floronics/ProBoter/docs/offene-fragen.md

# Offene Fragen

Sammelstelle für Fragen an SCHUTZWERK, die Werkstatt und andere Ansprechpartner.
Beantwortete Fragen mit Antwort und Datum unten unter **Erledigt** ablegen.

Status: `offen` · `gefragt` (wartet auf Antwort) · `erledigt`

## SCHUTZWERK

| # | Frage | Kontext | Status | Datum |
|---|---|---|---|---|
| | | | | |

## Werkstatt (Hochschule)

| # | Frage | Kontext | Status | Datum |
|---|---|---|---|---|
| | | | | |

## Sonstige

| # | Frage | Ansprechpartner | Status | Datum |
|---|---|---|---|---|
| | | | | |

## Erledigt

| # | Frage | Antwort | Datum |
|---|---|---|---|
| S1 | Aus welchem Material ist die Schubladenplatte gefertigt? | Siebdruckplatte, 12 mm Stärke (Material grundsätzlich austauschbar). Rückwand mit den Boards: 5 mm MDF, kann auch aus Kunststoff gefertigt werden. | 2026-10-28 |
| S2 | Wie wurde der PCB Holder gefertigt? | Zwei Rechteckführungen mit gedruckten Kunststoffhaltern, die vorne einen 90°-Innenwinkel haben. Material/Fertigungsverfahren der Halter sind beliebig wählbar. | 2026-10-28 |
| S3 | Endenbearbeitung/Nut der Trapezspindel TR10x2 | Entfällt – Spindel-Variante wurde laut SCHUTZWERK nicht weiterverfolgt (siehe S4), die betroffene BOM-Position entfällt komplett. | 2026-10-28 |
| S4 | Sind die Spindel-Angaben für X/Y in der BOM veraltet? | Ja, können raus. Das war der erste Prototyp-Aufbau mit Trapezspindeln, wurde dann gegen Zahnriemen getauscht. | 2026-10-28 |
| S5 | Welche Prüfspitzen und Aufnahmehülsen setzt ihr ein? | SCHUTZWERK hat keine Bestellbezeichnung mehr (nur vermuteter AliExpress-Artikel). Eigene Auswahl getroffen, P75-kompatibel, RS Components: Prüfspitzen 261-5171 (konkav, Power/GND), 261-5193 (Nadel, Oszi/Multimeter), 261-5187 (Kegel, Vergleich), Crimp-Buchse 261-5250 für alle. Achtung: Pins sind ca. 17 mm lang statt 31,8 mm im CAD, Probe-Holder muss angepasst werden. | 2026-10-28 |
| S6 | Gibt es Fertigungsdaten für das Probe-PCB, und welches Kabel verbindet MMCX und SMA? | Keine Gerber-/Schaltplandaten vorhanden – es ist keine funktionale Leiterplatte, sondern nur eine kleine Platine mit Aufnahmehülse (https://de.aliexpress.com/item/1005002266917025.html), die vorn ins Plastikteil eingeklebt ist und hinten per MMCX weitergeht. Das Kabel ist vermutlich RG316-Koaxkabel. | 2026-10-28 |
| S7 | Wo habt ihr die Stahlplatten lasern lassen? | Siebdruckplatte: expresszuschnitt.de. Stahlteile: laserteile4you.de. | 2026-10-28 |
| S8 | Welches Material wurde für die gedruckten Teile verwendet? | Teile mit mechanischer Belastung: PETG. ABS wurde nicht verwendet. Die Kalibrierplatte (und evtl. einzelne Halter) sind in PLA gedruckt. | 2026-10-28 |
| W1 | Können die Motorplatten in der Werkstatt gefertigt werden? | Nicht mehr nötig: Motorplatten X/X2 und Seitenplatten werden extern bei laserteile4you.de gelasert (Stahl oder Alu, 5 mm). Die Werkstatt schneidet nur Schubladenplatte und Rückwand zu. | 2026-10-28 |
