floronics/ProBoter/bom/Bestellliste.md

# Bestellliste und Einstieg

**Stand 16.10.2026 · ein PROBoter / vier Prüfeinheiten · Bildungseinrichtung Deutschland.**

3D-Druck und Blechbearbeitung intern; CNC/PCB extern. Host-PC, Messgeräte und Werkzeuge vorhan den. Arbeitszeit, Maschinenkosten, Softwaremigration und Elektronikentwicklung sind ausgeschlossen. Die Grundkonfiguration enthält **ein bewegliches Mikroskop und eine Übersichtskamera**, drei weitere Mikroskope sind optional.

## Kostenstand

| Ergebnis | netto | brutto 19% |
| --- | --- | --- |
| 1. Summe belegter Webpreise bei Planmengen (einschließlich ungeprüfter Kandidaten) | 3.153,78 € | 3.753,10 € |
| Zusätzliche eigene Budgetschätzungen inklusive Frachtreserve | 826,09 € | 983,03 € |
| 2. Vorläufiger Gesamtbedarf des bezifferten Umfangs | 3.979,87 € | 4.736,13 € |
| 3. 20 noch unbezifferte Bestellpositionen | offen | offen |

**Das vorläufige Total ist kein vollständiger Baupreis.** Die unbezifferten Platinen, Prüfkontakte, Sensoren und Kalibrierteile kommen hinzu. Ein vorhan dener Shoppreis beweist keine Austauschbarkeit. [Kostenmethodik](Kosten.md) trennt Preise, Mengenannahmen und offene Bedarfe.

## Dokumente

- [Alle Teile und Mengen](Teileliste.md) / [CSV](teileliste.csv)
- [Fertigung nach Verfahren und Angebotsanforderungen](Fertigung.md)
- [Nichtidentifizierte Teile und übrige Lücken](Ungeklaert.md)
- [Lieferanten, Rechnungskauf und Versand](Lieferanten.md)
- [Bestell-CSV mit Packungsrechnung](bestellliste.csv), [Kosten-JSON](kosten.json), [Angebotsquellen](data/offers.json)
- [CAD-/Fusion-Abgleich](CAD-Pruefung.md), [Reproduktion](Reproduktion.md)

## Bereits eindeutig beschaffbar

- **CAD-060:1×Mean Well RSP-200-24** – Originalmodell; Netzanschluss/Verteilung separat planen.
- **CAD-079:16×SHF10,DOLD11260** – Hauptmaße bestätigt; aktuell angekündigter Wareneingang 27.11.2026.

TMC2130, Rollen, Lager und Kamerakandidaten besitzen konkrete Bezugsquellen, benötigen aber die jeweils genannte Passungsprüfung. Filament ist als Materialvorschlag preislich bestimmt; Druckteile sind noch keine freigegebenen Fertigungsaufträge.

## Shopartikel mit beobachtetem Preis

| ID / Bedarf | Bedarf → Bestellung | Anbieter / Artikel | Preis pro Packung | Summe netto / brutto | Passung / Vorbehalt |
| --- | --- | --- | --- | --- | --- |
| **BUY-001** Netzteil 24 V<br>CAD-060 | 1 Stück → 1 × 1 | [REICHELT](https://www.reichelt.de/de/de/shop/produkt/schaltnetzteil_geschlossen_200_w_24_v_8_4_a-147909) / MW RSP-200-24<br>Mean Well: RSP-200-24<br>ab Lager; 1–2 Werktage | 42,50 € brutto | 35,71 € / 42,50 € | Originalmodell; CAD 215×115×30 mm. Gesamte 24-V-Last noch nachweisen.  |
| **BUY-002** 16 TMC2130 aus 4 Viererpacks<br>SYS-001 | 16 Stück → 4 × 4 | [RBS](https://www.roboter-bausatz.de/p/4x-tmc2130-spi-schrittmotortreiber) / RBS13024<br>BIGTREETECH: TMC2130 SPI Modul (Revision prüfen)<br>lieferbar; 1–3 Werktage | 39,95 € brutto | 134,29 € / 159,80 € | Treiberfamilie laut Firmware. SPI-Pinbelegung, Modulrevision, Jumper und Kühlung am SKR1.3 prüfen.  |
| **BUY-003** 16 Flanschhalter SHF10<br>CAD-079 | 16 Stück → 16 × 1 | [DOLD](https://www.dold-mechatronik.de/Wellenhalter-Flansch-SHF10) / 11260<br>DOLD: SHF10<br>nicht auf Lager; 320 Stück angekündigt für 27.11.2026 | 3,90 € brutto | 52,44 € / 62,40 € | CAD: 43×24×10 mm, Bohrung 10 mm, Befestigung 5,5 mm; mechanische Hauptmaße stimmen.  |
| **BUY-004** 12 X/Y-Antriebsriemenscheiben<br>CAD-077 | 12 Stück → 12 × 1 | [RBS](https://www.roboter-bausatz.de/p/gt2-riemenscheibe-z16-5mm-bohrung-6mm-riemen) / RBS10278<br>Maker Mind: 16-2GT-6 BF<br>lieferbar; 1–3 Werktage | 0,95 € brutto | 9,58 € / 11,40 € | Preisstaffel 5–19 Stück, geplant 12. Bohrung 5 mm CAD bestätigt; axiale Bund-/Klemmlänge mit 14,1-mm-CAD prüfen.  |
| **BUY-005** 20 Umlenkrollen 6 mm, 8,5 mm breit<br>CAD-078 | 20 Stück → 20 × 1 | [TINYTRONICS](https://www.tinytronics.nl/en/mechanics-and-actuators/parts/pulleys/gt2-16-pulley-16-teeth-3mm-axis-with-ball-bearing) / 002225<br>nicht angegeben: 002225<br>500+ auf Lager (NL) | 1,50 € brutto | 25,21 € / 30,00 € | Bohrung 3, Ø13, Höhe 8,5 mm, 6-mm-Riemen = CAD exakt.  |
| **BUY-006** 8 Z-Zahnscheiben 9 mm, Ersatz mit Halteranpassung<br>CAD-076 | 8 Stück → 8 × 1 | [RBS](https://www.roboter-bausatz.de/p/gt2-riemenscheibe-16-zaehne-5mm-bohrung-fuer-10mm-zahnriemen) / RBS12867<br>nicht angegeben: RBS12867<br>sofort verfügbar; 1–3 Werktage | 1,29 € brutto | 8,67 € / 10,32 € | Exaktes Teil 16 Zähne / 9 mm / Ø18×11 in DE/EU nicht gefunden. Kandidat Ø13×19,5, Zahnbreite 11,5: Halter anpassen; als Umlenkung nur mit Lagern. DOLD 64396 ist ein glattes Führungsrad und passt nicht.  |
| **BUY-007** X/Y-Riemen 6 mm,2 Rollen à10 m<br>CAD-087;CAD-104 | 20 m → 2 × 10 | [DOLD](https://www.dold-mechatronik.de/Zahnriemen-GT2-Breite-6mm-Meterware-Laenge-10-Meter) / 46194-VKV / Variante 10 m<br>DOLD: GT2 6 mm Neopren gewebeverstärkt<br>lieferbar; 3–4 Werktage | 25,00 € brutto | 42,02 € / 50,00 € | Budget 20 m für X/Y. Zuschnitt erst nach Prüfung der wirksamen Längen und offenen/geschlossenen Ausführung. Zuschnitt aus Fusion-Messung: 8×1,51 m + 4×1,10 m = 16,5 m inklusive Klemmzugabe; zwei 10-m-Rollen decken den Bedarf. |
| **BUY-008** Kurze Energieketten, 192 Glieder<br>CAD-049 | 192 Glied → 192 × 1 | [IGUS](https://www.igus.de/product/series-E2i-10?artNr=E2i.10.10.028.0) / E2i.10.10.028.0<br>igus: E2i.10.10.028.0<br>in 24 Stunden versandfertig | 0,47 € netto | 90,24 € / 107,39 € | Teilung 20 mm, Außenbreite 17,4, Höhe 15, Einbauhöhe 71 bei R28 = CAD. 0,24 m = 12 Glieder. Preis aus Seitendaten, vermutlich netto. 16 Abschnitte à 12 Glieder (0,24 m). |
| **BUY-009** 4 optische Endstops inkl 1 m Kabel<br>CAD-065 | 4 Stück → 4 × 1 | [RBS](https://www.roboter-bausatz.de/p/optischer-endschalter-endstop-mit-1m-kabel) / RBS12901<br>Maker Mind: RBS12901<br>sofort verfügbar; 1–3 Werktage | 2,85 € brutto | 9,58 € / 11,40 € | 35×11 mm, 2 Bohrungen im Abstand 28 mm = CAD. VCC/GND/SIG, 2,7–5 V, HIGH bei Unterbrechung; 3-polig 2,54 mm, 1 m Kabel. Pinfolge am SKR-Stecker prüfen.  |
| **MAT-001** PETG für CAD-Druckteile plus Kalibrierkörper<br>CAD-001;CAD-002;CAD-004;CAD-005;CAD-006;CAD-015;CAD-016;CAD-017;CAD-018;CAD-019;CAD-021;CAD-022;CAD-024;CAD-025;CAD-026;CAD-067;CAD-068;CAD-071;CAD-072;CAD-074;CAD-083;CAD-088;CAD-089;CAD-090;CAD-091;CAD-092;CAD-101;CAD-102;CAD-105;CAD-106;CAD-107;CAD-109;CAD-110;CAD-111;CAD-112;CAD-114;CAD-116;CAD-117;CAD-118;CAD-119;CAD-120;SYS-061;SYS-062;SYS-063;SYS-064;SYS-065;SYS-066;SYS-067;SYS-068;SYS-069;SYS-070;SYS-071;SYS-072 | 5,052 kg → 6 × 1 | [RBS](https://www.roboter-bausatz.de/p/yourdroid-petg-filament-schwarz-1.75mm-1kg) / RBS13444<br>your Droid: RBS13444<br>lieferbar; 1–3 Werktage | 11,95 € brutto | 60,25 € / 71,70 € | Werkstoffvorschlag; kein Originalwerkstoffnachweis. Bedarf aus CAD-Vollvolumen mit Zuschlag; Pass-/Belastungsprobe nötig. 2658.987 cm³ CAD-Vollvolumen × angenommene 1,27 g/cm³ ×1,20 +1 kg Kalibrier-/Probedruckbudget. Auf ganze 1 kg-Rollen gerundet. Kein Slicerresultat. |
| **BUY-011** USB-Mikroskop Toolcraft 2 MP (AUSWAHL, ANPASSUNG Halter)<br>CAD-085 | 1 Stück → 1 × 1 | [VOELKNER](https://www.voelkner.de/products/1177903/TOOLCRAFT-USB-Mikroskop-2-Megapixel-Digitale-Vergroesserung-max.-200-x.html) / D929041<br>Toolcraft: Conrad 1713197<br>auf Lager | 57,99 € brutto | 48,73 € / 57,99 € | Körper Ø33×110 mm (CAD Ø36×108), Fokus 0–150 mm. UVC/Linux nicht angegeben: vor Einbau mit v 4l 2-ctl testen. Druckhalter mit 1,5-mm-Hülse anpassen.  |
| **BUY-012** Aktiver 7Port-USB-Hub<br>SYS-010 | 1 Stück → 1 × 1 | [REICHELT](https://www.reichelt.de/de/de/shop/produkt/usb_2_0_7-port_hub_mit_netzteil_schwarz-131488) / D-LINK DUB H7<br>D-Link: DUB-H7/E<br>ab Lager; 1–2 Werktage | 25,90 € brutto | 21,76 € / 25,90 € | Steuergeräte an Hub, Kameras an zwei separate Hostports. Netzteil 5V2,5 A und Anschlusskabel enthalten; Strombudget prüfen.  |
| **BUY-013** LED-Streifen 5-m-Rolle für 1,9 m<br>SYS-007 | 1,9 m → 1 × 5 | [REICHELT](https://www.reichelt.de/de/de/shop/produkt/led-streifen_5_meter_4500_k_120_led_m_24_v_8_mm-365051) / LUXULA LX700101<br>LUXULA: LX700101<br>ab Lager; 1–2 Werktage | 6,95 € brutto | 5,84 € / 6,95 € | Vorschlag:2 m Beleuchtung aus 5 m-Rolle; 8 mm breit,5cm teilbar. Leistung, homogene Ausleuchtung und PWM/Kamera-Flimmern prüfen.  |
| **BUY-014** 12 NEMA17 Originalmotoren<br>CAD-064 | 12 Stück → 12 × 1 | [NANOTEC](https://www.nanotec.com/eu/de/produkte/363-st4118m1804-a) / ST4118M1804-A<br>Nanotec: ST4118M1804-A<br>Verfügbarkeit laut Shop anfragen | 31,20 € netto | 374,40 € / 445,54 € | Originalmodell, aktuelle Serie. 1,8 A, 1,1 Ω, 0,28 Nm, 42,3 mm Flansch, 38 mm, Welle Ø5×24, Litzen 300 mm mit JST XHP-4. Preisbasis im Shop nicht angegeben, als netto angesetzt.  |
| **BUY-016** 4 Steuerplatinen SKR 1.4 Turbo (ERSATZ)<br>CAD-023 | 4 Stück → 4 × 1 | [RBS](https://www.roboter-bausatz.de/p/btt-skr-1.4-turbo-32-bit-mainboard) / RBS13645<br>BIGTREETECH: SKR V1.4 Turbo<br>sofort verfügbar; 1–3 Werktage | 49,95 € brutto | 167,90 € / 199,80 € | Nur Kandidat: SKR V1.3 neu in DE/EU nicht gefunden. 110×85 mm, Löcher 102×76 (V1.3: 101,85×76,10), LPC1769. Marlin-Pins für Endstops, Treiber-CS und SPI-MOSI ändern; nicht freigegeben. Firmware-Migration auf SKR 1.4 Turbo nötig (Arbeitszeit nicht kalkuliert). |
| **BUY-018** 8 CPC-Führungswagen MR12ML<br>CAD-027 | 8 Stück → 8 × 1 | [MOTEDIS](https://www.motedis.com/de/Fuehrungswagen-Miniatur-MR12ML-SS-V0-N-Edelstahl) / 6344<br>CPC: MR12MLSSV0N<br>laut Shop derzeit nicht genug Bestand | 20,51 € netto | 164,08 € / 195,26 € | CPC-Katalog SS-Ausführung: L 47,6, Körperhöhe 10, Breite 27, Lochbild 20×20 M3 = CAD.  |
| **BUY-019** 2 CPC-Schienen MR12M 600 mm<br>CAD-095 | 2 Stück → 2 × 1 | [MOTEDIS](https://www.motedis.com/de/Edelstahl-Profilschienenfuehrung-Miniatur-MR12M-N-L-600mm) / MR12M-N-600<br>CPC: MR12M-N-600<br>laut Shop nicht auf Lager | 50,17 € netto | 100,34 € / 119,40 € | 12×7,5 mm, Teilung 25, Bohrung Ø3,5/Ø6, 24 Bohrungen, Endabstand 12,5 = CAD. Endabstand bei Bestellung angeben.  |
| **BUY-020** 4 HIWIN-Schienen 150 mm<br>CAD-053 | 4 Stück → 4 × 1 | [DAMEN](https://www.damencnc.com/en/hiwin-profile-rails-narrow-type-mgnr-12-hm/a1945) / 3449<br>HIWIN: MGNR12R150HM<br>auf Lager (NL) | 46,75 € netto | 187,00 € / 222,53 € | 12×8, Teilung 25, 6 Bohrungen, Endabstand 12,5 = CAD. Preis berechnet: 245 EUR/m netto × 0,15 m + 10 EUR Zuschnitt.  |
| **BUY-021** 4 HIWIN-Wagen MGN12C<br>CAD-054 | 4 Stück → 4 × 1 | [DAMEN](https://www.damencnc.com/en/hiwin-carriage-mgn-narrow-type-mgn-12-c-z0-hm-short/a1947) / 3455<br>HIWIN: MGN12CZ0HM<br>auf Lager (NL) | 31,00 € netto | 124,00 € / 147,56 € | Breite 27, Körperhöhe 10, Lochbild 20×15 M3 = CAD; Katalog-Länge 34,7 statt CAD 35,7.  |
| **BUY-022** 16 Gleitbuchsen RJ4JP-01-10<br>CAD-080 | 16 Stück → 16 × 1 | [DOLD](https://www.dold-mechatronik.de/index.php?a=216047) / RJ4JP-01-10<br>igus: RJ4JP-01-10<br>sofort verfügbar; 3–4 Werktage | 3,82 € brutto | 51,36 € / 61,12 € | d 10, D 19, B 29, Nut Ø18 = CAD. Staffelpreis ab 10 Stück.  |
| **BUY-023** Lange Energieketten, 112 Glieder<br>CAD-050 | 112 Glied → 112 × 1 | [IGUS](https://www.igus.de/product/series-E2i-10?artNr=E2I.10.20.028.0) / E2I.10.20.028.0<br>igus: E2i.10.20.028.0<br>in 24 Stunden versandfertig | 0,49 € netto | 54,88 € / 65,31 € | Teilung 20 mm, Außenbreite 27,4, Einbauhöhe 71 = CAD. 0,28 m = 14 Glieder. Preis vermutlich netto. 8 Abschnitte à 14 Glieder (0,28 m). |
| **BUY-024** 16 Anschlusssätze E2.10 schmal<br>SYS-027 | 16 Satz → 16 × 1 | [DIGIKEY](https://www.digikey.de/de/products/detail/igus/E2-100-10-34PZ/13157727) / E2-100-10-34PZ<br>igus: E2.100.10.34PZ<br>14 vorrätig, sonst 22 Wochen | 5,84 € netto | 93,44 € / 111,19 € | Beidseitig schwenkbar mit Zugentlastung; Breite 17,4 = CAD-Anschlusskörper.  |
| **BUY-025** 8 Anschlusssätze E2.10 breit<br>SYS-028 | 8 Satz → 8 × 1 | [DIGIKEY](https://www.digikey.de/de/products/detail/igus/E2-100-20-34PZ/13157712) / E2-100-20-34PZ<br>igus: E2.100.20.34PZ<br>42 vorrätig | 6,76 € netto | 54,08 € / 64,36 € | Breite 27,4 = CAD-Anschlusskörper.  |
| **BUY-017** Z-Riemen 9 mm<br>CAD-113 | 1,28 m → 2 × 1 | [RBS](https://www.roboter-bausatz.de/p/1-meter-gt2-zahnriemen-gates-ll2gt-rf-9mm) / RBS14040<br>Maker Mind (Shopangabe; Titel nennt Gates LL-2GT RF): LL-2GT RF 9 mm<br>sofort verfügbar; 1–3 Werktage | 8,69 € brutto | 14,61 € / 17,38 € | GT2, 9 mm breit = CAD. Bedarf 4×0,32 m. Zuschnitt aus Fusion-Messung 4×0,32 m. |
| **BUY-SYS-057** 10 Prüfstifte P75-E2<br>SYS-057 | 10 Stück → 10 × 1 | [DOMOTICX](https://domoticx.net/webshop/pogo-pin-test-probe-075mm-conisch-p75-e2/) / P75-E2<br>nicht angegeben: P75-E2<br>nicht geprüft | 0,18 € brutto | 1,51 € / 1,80 € | Gleicher Körper wie P75-B1, Kegelspitze.  |
| **BUY-SYS-042** Nutenstein I-Typ Nut 6, M4, Rückwand<br>SYS-042 | 6 Stück → 1 × 10 | [DOLD](https://www.dold-mechatronik.de/Nutenstein-mit-Steg-I-Typ-Nut-6-Gewindedurchmesser-M4) / 62347-VK<br>DOLD: 62347-VK<br>sofort verfügbar | 4,80 € brutto | 4,03 € / 4,80 € | Passend zu I-Typ Nut 6; Staffelpreis 0,48 EUR ab 10 Stück.  |
| **BUY-SYS-043** Zylinderschraube DIN 912 M4×10 A2, Rückwand<br>SYS-043 | 6 Stück → 1 × 10 | [SCHRAUBEN](https://schrauben-expert.de/Zylinderschraube-DIN-912-M4-x-10-mm-Edelstahl-A2) / 912 4 10 A2<br>Schrauben.Expert: 912 4 10 A2<br>Expresslager 1–4 Werktage | 3,30 € brutto | 2,77 € / 3,30 € | 3 mm Rückwand + Nutenstein; gleicher Artikel wie CAD-043, separat für die Rückwand.  |
| **BUY-SYS-044** Nutenstein I-Typ Nut 6, M5, Griff<br>SYS-044 | 2 Stück → 2 × 1 | [DOLD](https://www.dold-mechatronik.de/Nutenstein-mit-Steg-I-Typ-Nut-6-Gewindedurchmesser-M5) / 62361-VK<br>DOLD: 62361-VK<br>sofort verfügbar | 0,89 € brutto | 1,50 € / 1,78 € | Für die Griffschrauben M5.  |
| **BUY-SYS-045** Zylinderschraube DIN 912 M5×35 A2, Griff<br>SYS-045 | 2 Stück → 1 × 10 | [SCHRAUBEN](https://schrauben-expert.de/Zylinderschraube-DIN-912-M5-x-35-mm-Edelstahl-A2) / 912 5 35 A2<br>Schrauben.Expert: 912 5 35 A2<br>Express 13 Stück, Lager 8000 | 3,30 € brutto | 2,77 € / 3,30 € | Mindestabnahme 10.  |
| **BUY-SYS-046** Zylinderschraube DIN 912 M4×10 A2, Wellenhalter<br>SYS-046 | 7 Stück → 1 × 10 | [SCHRAUBEN](https://schrauben-expert.de/Zylinderschraube-DIN-912-M4-x-10-mm-Edelstahl-A2) / 912 4 10 A2<br>Schrauben.Expert: 912 4 10 A2<br>Expresslager 1–4 Werktage | 3,30 € brutto | 2,77 € / 3,30 € | Wellenhalter: 6 mm Flansch + Nutenstein; Fusion zeigt die modellierte M4×10 genau so.  |
| **BUY-SYS-047** Nutenstein I-Typ Nut 6, M4, Wellenhalter<br>SYS-047 | 8 Stück → 1 × 10 | [DOLD](https://www.dold-mechatronik.de/Nutenstein-mit-Steg-I-Typ-Nut-6-Gewindedurchmesser-M4) / 62347-VK<br>DOLD: 62347-VK<br>sofort verfügbar | 4,80 € brutto | 4,03 € / 4,80 € | Staffelpreis 0,48 EUR ab 10 Stück.  |
| **BUY-SYS-048** Linsenkopfschraube ISO 7380-1 M4×8 A2, Teleskopschienen<br>SYS-048 | 12 Stück → 1 × 25 | [SCHRAUBEN](https://schrauben-expert.de/Linsenkopfschraube-ISO-7380-1-M4-x-8-Edelstahl-A2) / 7380-1 4 8 A2<br>Schrauben.Expert: 7380-1 4 8 A2<br>Express 130 Stück | 5,00 € brutto | 4,20 € / 5,00 € | Flacher Kopf dk 7,6, k 2,2 mm; 25 Stück günstiger als 14.  |
| **BUY-SYS-049** Nutenstein I-Typ Nut 6, M4, Teleskopschienen<br>SYS-049 | 12 Stück → 2 × 10 | [DOLD](https://www.dold-mechatronik.de/Nutenstein-mit-Steg-I-Typ-Nut-6-Gewindedurchmesser-M4) / 62347-VK<br>DOLD: 62347-VK<br>sofort verfügbar | 4,80 € brutto | 8,07 € / 9,60 € | Staffelpreis 0,48 EUR ab 10 Stück.  |
| **BUY-SYS-050** Zylinderschraube DIN 912 M3×8 A2, Kabelhalter M3<br>SYS-050 | 4 Stück → 1 × 100 | [EISEN2000](https://www.eisenwaren2000.de/?a=85292) / OS-912-2-030008<br>nicht angegeben: 9122030008<br>sofort verfügbar; 2–5 Werktage | 5,00 € brutto | 4,20 € / 5,00 € | Blankes A2. Preisstaffel: Kaufmenge = günstigste Staffel ≥ Planmenge. Festigkeitsklasse A2-70 nicht ausgewiesen.  |
| **BUY-SYS-051** Zylinderschraube DIN 912 M3×10 A2, igus-Kettenanschlüsse<br>SYS-051 | 106 Stück → 2 × 100 | [EISEN2000](https://www.eisenwaren2000.de/?a=85293) / OS-912-2-030010<br>nicht angegeben: 9122030010<br>sofort verfügbar; 2–5 Werktage | 5,00 € brutto | 8,40 € / 10,00 € | Blankes A2. Preisstaffel: Kaufmenge = günstigste Staffel ≥ Planmenge. Festigkeitsklasse A2-70 nicht ausgewiesen.  |
| **BUY-SYS-052** Zylinderschraube DIN 912 M3×12 A2, Z-Kabelhalter<br>SYS-052 | 6 Stück → 1 × 50 | [EISEN2000](https://www.eisenwaren2000.de/?a=85294) / OS-912-2-030012<br>nicht angegeben: 9122030012<br>sofort verfügbar; 2–5 Werktage | 6,50 € brutto | 5,46 € / 6,50 € | Blankes A2. Preisstaffel: Kaufmenge = günstigste Staffel ≥ Planmenge. Festigkeitsklasse A2-70 nicht ausgewiesen.  |
| **BUY-SYS-053** Sechskantmutter DIN 934 M3 A2, Kabelführung<br>SYS-053 | 111 Stück → 3 × 50 | [SCHRAUBEN](https://schrauben-expert.de/Sechskantmutter-DIN-934-M3-Edelstahl-V2A) / 934 3 A2<br>Schrauben.Expert: 934 3 A2<br>Expresslager 1–4 Werktage | 6,00 € brutto | 15,13 € / 18,00 € | SW 5,5, H 2,4 = CAD; ISO 4032 identisch. Preisstaffel: Kaufmenge = günstigste Staffel ≥ Planmenge. Festigkeitsklasse A2-70 nicht ausgewiesen.  |
| **BUY-SYS-054** Linsenkopfschraube ISO 7380-1 M4×8 A2, Kabelführung<br>SYS-054 | 11 Stück → 1 × 25 | [SCHRAUBEN](https://schrauben-expert.de/Linsenkopfschraube-ISO-7380-1-M4-x-8-Edelstahl-A2) / 7380-1 4 8 A2<br>Schrauben.Expert: 7380-1 4 8 A2<br>Express 130 Stück | 5,00 € brutto | 4,20 € / 5,00 € | Flacher Kopf dk 7,6, k 2,2 mm; 25 Stück günstiger als 14.  |
| **BUY-SYS-055** Nutenstein I-Typ Nut 6, M4, Kabelhalter<br>SYS-055 | 3 Stück → 1 × 10 | [DOLD](https://www.dold-mechatronik.de/Nutenstein-mit-Steg-I-Typ-Nut-6-Gewindedurchmesser-M4) / 62347-VK<br>DOLD: 62347-VK<br>sofort verfügbar | 4,80 € brutto | 4,03 € / 4,80 € | Passend zu I-Typ Nut 6; Staffelpreis 0,48 EUR ab 10 Stück.  |
| **BUY-SYS-056** Zylinderschraube DIN 912 M5×10 A2, Kabelhalter M5<br>SYS-056 | 6 Stück → 1 × 50 | [SCHRAUBEN](https://schrauben-expert.de/Zylinderschraube-DIN-912-M5-x-10-mm-Edelstahl-A2) / 912 5 10 A2<br>Schrauben.Expert: 912 5 10 A2<br>Expresslager 1–4 Werktage | 6,00 € brutto | 5,04 € / 6,00 € | 50 Stück günstiger als 36. Preisstaffel: Kaufmenge = günstigste Staffel ≥ Planmenge. Festigkeitsklasse A2-70 nicht ausgewiesen.  |
| **BUY-SYS-059** Zylinderschraube DIN 912 M5×10 A2, Abdeckungen<br>SYS-059 | 18 Stück → 1 × 50 | [SCHRAUBEN](https://schrauben-expert.de/Zylinderschraube-DIN-912-M5-x-10-mm-Edelstahl-A2) / 912 5 10 A2<br>Schrauben.Expert: 912 5 10 A2<br>Expresslager 1–4 Werktage | 6,00 € brutto | 5,04 € / 6,00 € | 50 Stück günstiger als 36. Preisstaffel: Kaufmenge = günstigste Staffel ≥ Planmenge. Festigkeitsklasse A2-70 nicht ausgewiesen.  |
| **BUY-SYS-060** Nutenstein I-Typ Nut 6, M5, Abdeckungen<br>SYS-060 | 18 Stück → 18 × 1 | [DOLD](https://www.dold-mechatronik.de/Nutenstein-mit-Steg-I-Typ-Nut-6-Gewindedurchmesser-M5) / 62361-VK<br>DOLD: 62361-VK<br>sofort verfügbar | 0,89 € brutto | 13,46 € / 16,02 € | Für die Griffschrauben M5.  |
| **MAT-007** Aluprofil 40x 16S Nut 8, Zuschnitt<br>CAD-103 | 1 Los → 1 × 1 | [DOLD](https://www.dold-mechatronik.de/Aluminiumprofil-40x16S-I-Typ-Nut-8) / 60879-Z<br>DOLD: 60879-Z<br>Zuschnitt auf Bestellung | 29,03 € brutto | 24,39 € / 29,03 € | 1,178 kg/m ≈ 436 mm² (CAD 446 mm²), Kern Ø5 für M6 = CAD. 1,744 m à 15,50 EUR + 4 Schnitte à 0,50 EUR; Brutto/Netto im Shop nicht geprüft.  |
| **MAT-008** Aluprofil 80x 16S Nut 8, Zuschnitt, Kandidat<br>CAD-009 | 1 Los → 1 × 1 | [DOLD](https://www.dold-mechatronik.de/Aluminiumprofil-80x16S-I-Typ-Nut-8) / 60886-Z<br>DOLD: 60886-Z<br>Zuschnitt auf Bestellung | 74,80 € brutto | 62,86 € / 74,80 € | Gleiche Serie wie CAD-103, aber 2,196 kg/m ≈ 813 mm² (CAD 932 mm²). Produktseite nennt Kern für M8, CAD zeigt Ø5: vor Bestellung an der DOLD-Zeichnung prüfen. 2,6 m à 28,00 EUR + 4 Schnitte à 0,50 EUR.  |
| **MAT-009** Auslöserstäbe Ø8 Cf 53, Zuschnitt<br>CAD-093;CAD-094 | 1 Los → 1 × 1 | [DOLD](https://www.dold-mechatronik.de/Praezisionswelle-8mm-h6-geschliffen-und-gehaertet-Material-CF53-Zuschnitt) / PW-CF53-8-h 6-Z<br>DOLD: PW-CF53-8-h 6-Z<br>verfügbar, 9–10 Werktage | 14,29 € brutto | 12,01 € / 14,29 € | Cf 53 magnetisch, Ø8 h 6 = CAD. 0,8 m à 11,72 EUR + 8 Schnitte à 0,50 EUR + 0,91 EUR Mindermengenzuschlag.  |
| **BUY-SEN** 24 induktive Sensoren ELCO NI4-M08-ON6L-Q8<br>CAD-055 | 24 Stück → 24 × 1 | [ELCO](https://shop.elco-automation.de/NI4-M08-ON6L-Q8) / NI4-M08-ON6L-Q8<br>ELCO: NI4-M08-ON6L-Q8<br>Lieferzeit ca. 3 Wochen | 10,44 € netto | 250,56 € / 298,17 € | Sn 4 mm, 10–30 V DC, NPN NO, M8 3-polig, Messing vernickelt, M8×59,6 mm (CAD 60 mm). Datenblatt (Belegung, Muttern im Lieferumfang) noch prüfen; Shop ggf. Anfrage statt Checkout. Alternative ab Lager: FI2-M08-ON6L-Q8 (bündig, Sn 2 mm, 55,4 mm).  |
| **BUY-SW** Netzschalter Ø19 ONPOW LAS1 A<br>CAD-086 | 1 Stück → 1 × 1 | [REICHELT](https://www.reichelt.de/de/de/shop/produkt/av-schalter_ip67_22_19_mm_5a-250v_gn-108422) / VS LAS1 A-ZG24<br>ONPOW: LAS1AGQ-11ZE/G/DC24 V<br>ab Lager, 1–2 Werktage | 11,94 € brutto | 10,03 € / 11,94 € | Einbau Ø19 = CAD, 5 A / 250 V AC. Rastend aus Typcode Z und Bezeichnung "Schalter" abgeleitet: vor Bestellung bestätigen.  |
| **BUY-CAB** 24 Sensorleitungen ifm EVC141<br>SYS-016 | 24 Stück → 24 × 1 | [AUTOMATION24](https://www.automation24.de/m8-sensorleitung-ifm-electronic-evc141) / EVC141<br>ifm: EVC141<br>sofort verfügbar | 13,90 € netto | 333,60 € / 396,98 € | M8 3-polig gerade, PUR, schleppkettentauglich.  |
| **BUY-PIN** Prüfstifte P75-B1 (CAD-Spitze)<br>CAD-115 | 10 Stück → 10 × 1 | [DOMOTICX](https://domoticx.net/webshop/pogo-pin-test-probe-0-75mm-punt-p75-b1) / CON-0032-P75B1<br>nicht angegeben: P75-B1<br>239 auf Lager | 0,18 € brutto | 1,51 € / 1,80 € | Ø1,0 × 16,5 mm, 3 A, Hub 2,5 mm = CAD (Ø1 × 16,6, 30°-Spitze). Federkraft nicht angegeben.  |
| **BUY-LEDP** LED-Profilsatz BARdolino<br>SYS-008 | 1 Satz → 1 × 1 | [REICHELT](https://www.reichelt.de/de/de/shop/produkt/bardolino_flach_profil_alu_eloxiert_1m-122169) / BARDOLINO P1MF + A1MO + EKSF + HKS<br>Barthelme: 62399201 / 62399301 / 62398614 / 50990090<br>ab Lager, 1–2 Werktage | 44,55 € brutto | 37,44 € / 44,55 € | 2×6,65 + 2×4,60 + 2×8,55 + 3×1,65 EUR. Je 1-m-Profil ein 590- und ein 350-mm-Stück. Außen 18,4×13 mm für 8-mm-Streifen; Innenbreite im Datenblatt prüfen.  |
| **BUY-C051** Schubladengriff DOLD A-75873, Lochabstand 100 mm<br>CAD-051 | 1 Stück → 1 × 1 | [DOLD](https://www.dold-mechatronik.de/Buegelgriff-100mm-mit-Befestigungsbohrungen) / A-75873<br>DOLD: A-75873<br>laut Recherche lieferbar | 8,15 € brutto | 6,85 € / 8,15 € | Lochabstand 100, Höhe 49, Durchgangsbohrung Ø5,4 = CAD (Ø5,5 durch, 29 mm); Länge 112 statt 113 mm.  |
| **BUY-C052** Gelenkfuß M6×20 / Teller Ø40 mm<br>CAD-052 | 4 Stück → 4 × 1 | [DOLD](https://www.dold-mechatronik.de/index.php?a=91508) / GF-K-10-PA-028<br>DOLD: GF-K-10-PA-028<br>sofort verfügbar; 3–4 Werktage | 2,47 € brutto | 8,30 € / 9,88 € | M6×20 und Teller Ø40 = CAD (Fusion-Messung). Preis vorsichtshalber als Summe der Variantenteile angesetzt: Teller 0,87 + Gewindestange 1,50 + Mutter DIN 439 0,10 EUR; Shop zeigt 1,50 EUR (Luis 18.10.2026). Stahl verzinkt + PA, Traglast nicht angegeben.  |
| **BUY-C059** Mean Well MHS012 Montagewinkel<br>CAD-059 | 4 Stück → 4 × 1 | [REICHELT](https://www.reichelt.de/de/de/shop/produkt/befestigungswinkel_fuer_schaltnetzteile-188580) / MHS-012<br>Mean Well: MHS012<br>ab Lager; 1–2 Werktage | 0,30 € brutto | 1,01 € / 1,20 € | 15×16,2×19,5 laut Zeichnung (CAD 15×16×19,2); 4 je RSP-200.  |
| **BUY-C081** Anschraubwinkel 30 / Nut 6<br>CAD-081 | 26 Stück → 26 × 1 | [DOLD](https://www.dold-mechatronik.de/Winkel-30-I-Typ-Nut-6-inkl-Befestigungssatz) / 62385-BS<br>DOLD: 62385-BS<br>sofort verfügbar; 3–4 Werktage | 2,24 € brutto | 48,94 € / 58,24 € | 28×28×28 = CAD; Satz mit 2 Schrauben DIN 7380 M6×12 10.9 verzinkt (so belassen, Luis 18.10.2026) und 2 Nutensteinen M6. Staffelpreis 2,24 EUR ab 10 Stück (Einzelpreis 2,65 EUR).  |
| **BUY-C084** Teleskopschiene 350 mm, Vollauszug<br>CAD-084 | 2 Stück → 1 × 2 | [DOLD](https://www.dold-mechatronik.de/Vollauszug-45kg-350mm-(1-Paar-Teleskopschienen)) / HS-4613-350<br>DOLD: HS-4613-350<br>sofort verfügbar; 3–4 Werktage | 10,84 € brutto | 9,11 € / 10,84 € | 350×45,7×12,7 (CAD 45,5); die zwei CAD-Schienen sind ein Paar.  |
| **N-028** DIN 466 Rändelmutter hoch M4<br>CAD-028 | 10 Stück → 1 × 10 | [EISEN2000](https://www.eisenwaren2000.de/?a=82262) / OS-466-1-040<br>nicht angegeben: 4662040<br>sofort verfügbar; 2–5 Werktage | 16,10 € brutto | 13,53 € / 16,10 € | DIN 466 M4: dk 16, m 9,5 = CAD. Nur A1 statt A2 lieferbar. Preisstaffel: Kaufmenge = günstigste Staffel ≥ Planmenge. Festigkeitsklasse A2-70 nicht ausgewiesen.  |
| **N-029** DIN 562 M3 Vierkantmutter<br>CAD-029 | 10 Stück → 1 × 25 | [EISEN2000](https://www.eisenwaren2000.de/?a=82353) / OS-562-2-0030<br>Schäfer+Peters (Händlerangabe): 56223<br>sofort verfügbar; 2–5 Werktage | 6,00 € brutto | 5,04 € / 6,00 € | DIN 562 M3: s 5,5, m 1,8 = CAD. Preisstaffel: Kaufmenge = günstigste Staffel ≥ Planmenge. Festigkeitsklasse A2-70 nicht ausgewiesen.  |
| **N-030** DIN 562 M4 Vierkantmutter<br>CAD-030 | 14 Stück → 1 × 25 | [EISEN2000](https://www.eisenwaren2000.de/?a=82354) / OS-562-2-0040<br>Schäfer+Peters (Händlerangabe): 56224<br>sofort verfügbar; 2–5 Werktage | 6,25 € brutto | 5,25 € / 6,25 € | DIN 562 M4: s 7, m 2,2 = CAD. Preisstaffel: Kaufmenge = günstigste Staffel ≥ Planmenge. Festigkeitsklasse A2-70 nicht ausgewiesen.  |
| **N-031** DIN 7991 M3×8<br>CAD-031 | 36 Stück → 1 × 100 | [EISEN2000](https://www.eisenwaren2000.de/?a=84924) / OS-7991-2-030008<br>nicht angegeben: 79912030008<br>sofort verfügbar; 2–5 Werktage | 5,00 € brutto | 4,20 € / 5,00 € | Blankes A2; Schrauben.Expert nur schwarz. Preisstaffel: Kaufmenge = günstigste Staffel ≥ Planmenge. Festigkeitsklasse A2-70 nicht ausgewiesen.  |
| **N-032** DIN 7991 M6×12<br>CAD-032 | 18 Stück → 1 × 25 | [SCHRAUBEN](https://schrauben-expert.de/Senkschraube-ISO-10642-M6-x-12-Edelstahl-A2) / 7991 6 12 A2<br>Schrauben.Expert: 7991 6 12 A2<br>Expresslager 1–4 Werktage | 5,00 € brutto | 4,20 € / 5,00 € | ISO 10642 = DIN 7991; Kopf Ø13,44. Preisstaffel: Kaufmenge = günstigste Staffel ≥ Planmenge. Festigkeitsklasse A2-70 nicht ausgewiesen.  |
| **N-033** DIN 7991 M6×14<br>CAD-033 | 8 Stück → 1 × 10 | [SCHRAUBEN](https://schrauben-expert.de/Senkschraube-ISO-10642-M6-x-14-Edelstahl-A2) / 7991 6 14 A2<br>Schrauben.Expert: 7991 6 14 A2<br>Expresslager 1–4 Werktage | 3,30 € brutto | 2,77 € / 3,30 € | ISO 10642 = DIN 7991. Preisstaffel: Kaufmenge = günstigste Staffel ≥ Planmenge. Festigkeitsklasse A2-70 nicht ausgewiesen.  |
| **N-034** DIN 7991 M6×20<br>CAD-034 | 25 Stück → 1 × 25 | [SCHRAUBEN](https://schrauben-expert.de/Senkschraube-ISO-10642-M6-x-20-Edelstahl-A2) / 7991 6 20 A2<br>Schrauben.Expert: 7991 6 20 A2<br>Expresslager 1–4 Werktage | 5,00 € brutto | 4,20 € / 5,00 € | ISO 10642 = DIN 7991. Preisstaffel: Kaufmenge = günstigste Staffel ≥ Planmenge. Festigkeitsklasse A2-70 nicht ausgewiesen.  |
| **N-035** DIN 912 M3×10<br>CAD-035 | 84 Stück → 1 × 100 | [EISEN2000](https://www.eisenwaren2000.de/?a=85293) / OS-912-2-030010<br>nicht angegeben: 9122030010<br>sofort verfügbar; 2–5 Werktage | 5,00 € brutto | 4,20 € / 5,00 € | Blankes A2. Preisstaffel: Kaufmenge = günstigste Staffel ≥ Planmenge. Festigkeitsklasse A2-70 nicht ausgewiesen.  |
| **N-036** DIN 912 M3×12<br>CAD-036 | 10 Stück → 1 × 50 | [EISEN2000](https://www.eisenwaren2000.de/?a=85294) / OS-912-2-030012<br>nicht angegeben: 9122030012<br>sofort verfügbar; 2–5 Werktage | 6,50 € brutto | 5,46 € / 6,50 € | Blankes A2. Preisstaffel: Kaufmenge = günstigste Staffel ≥ Planmenge. Festigkeitsklasse A2-70 nicht ausgewiesen.  |
| **N-037** DIN 912 M3×14<br>CAD-037 | 6 Stück → 1 × 100 | [EISEN2000](https://www.eisenwaren2000.de/?a=85295) / OS-912-2-030014<br>nicht angegeben: 9122030014<br>sofort verfügbar; 2–5 Werktage | 5,00 € brutto | 4,20 € / 5,00 € | Blankes A2; 100 Stück günstiger als 6. Preisstaffel: Kaufmenge = günstigste Staffel ≥ Planmenge. Festigkeitsklasse A2-70 nicht ausgewiesen.  |
| **N-038** DIN 912 M3×16<br>CAD-038 | 31 Stück → 1 × 50 | [EISEN2000](https://www.eisenwaren2000.de/?a=85296) / OS-912-2-030016<br>nicht angegeben: 9122030016<br>sofort verfügbar; 2–5 Werktage | 10,50 € brutto | 8,82 € / 10,50 € | Blankes A2. Preisstaffel: Kaufmenge = günstigste Staffel ≥ Planmenge. Festigkeitsklasse A2-70 nicht ausgewiesen.  |
| **N-039** DIN 912 M3×18<br>CAD-039 | 36 Stück → 1 × 50 | [EISEN2000](https://www.eisenwaren2000.de/?a=85297) / OS-912-2-030018<br>nicht angegeben: 9122030018<br>sofort verfügbar; 2–5 Werktage | 10,50 € brutto | 8,82 € / 10,50 € | Blankes A2. Preisstaffel: Kaufmenge = günstigste Staffel ≥ Planmenge. Festigkeitsklasse A2-70 nicht ausgewiesen.  |
| **N-040** DIN 912 M3×20<br>CAD-040 | 6 Stück → 1 × 6 | [EISEN2000](https://www.eisenwaren2000.de/?a=85298) / OS-912-2-030020<br>nicht angegeben: 9122030020<br>sofort verfügbar; 2–5 Werktage | 8,40 € brutto | 7,06 € / 8,40 € | Blankes A2. Preisstaffel: Kaufmenge = günstigste Staffel ≥ Planmenge. Festigkeitsklasse A2-70 nicht ausgewiesen.  |
| **N-041** DIN 912 M3×30<br>CAD-041 | 10 Stück → 1 × 10 | [EISEN2000](https://www.eisenwaren2000.de/?a=85301) / OS-912-2-030030<br>nicht angegeben: 9122030030<br>sofort verfügbar; 2–5 Werktage | 7,90 € brutto | 6,64 € / 7,90 € | Blankes A2. Preisstaffel: Kaufmenge = günstigste Staffel ≥ Planmenge. Festigkeitsklasse A2-70 nicht ausgewiesen.  |
| **N-042** DIN 912 M3×8<br>CAD-042 | 58 Stück → 1 × 100 | [EISEN2000](https://www.eisenwaren2000.de/?a=85292) / OS-912-2-030008<br>nicht angegeben: 9122030008<br>sofort verfügbar; 2–5 Werktage | 5,00 € brutto | 4,20 € / 5,00 € | Blankes A2. Preisstaffel: Kaufmenge = günstigste Staffel ≥ Planmenge. Festigkeitsklasse A2-70 nicht ausgewiesen.  |
| **N-043** DIN 912 M4×10<br>CAD-043 | 3 Stück → 1 × 10 | [SCHRAUBEN](https://schrauben-expert.de/Zylinderschraube-DIN-912-M4-x-10-mm-Edelstahl-A2) / 912 4 10 A2<br>Schrauben.Expert: 912 4 10 A2<br>Expresslager 1–4 Werktage | 3,30 € brutto | 2,77 € / 3,30 € | Kopf Ø7, k 4. Preisstaffel: Kaufmenge = günstigste Staffel ≥ Planmenge. Festigkeitsklasse A2-70 nicht ausgewiesen.  |
| **N-044** DIN 912 M4×20<br>CAD-044 | 22 Stück → 1 × 25 | [SCHRAUBEN](https://schrauben-expert.de/Zylinderschraube-DIN-912-M4-x-20-mm-Edelstahl-A2) / 912 4 20 A2<br>Schrauben.Expert: 912 4 20 A2<br>Expresslager 1–4 Werktage | 5,00 € brutto | 4,20 € / 5,00 € | 25 Stück günstiger als 22. Preisstaffel: Kaufmenge = günstigste Staffel ≥ Planmenge. Festigkeitsklasse A2-70 nicht ausgewiesen.  |
| **N-045** DIN 912 M4×30<br>CAD-045 | 40 Stück → 1 × 50 | [SCHRAUBEN](https://schrauben-expert.de/Zylinderschraube-DIN-912-M4-x-30-mm-Edelstahl-A2) / 912 4 30 A2<br>Schrauben.Expert: 912 4 30 A2<br>Expresslager 1–4 Werktage | 6,00 € brutto | 5,04 € / 6,00 € | 50 Stück günstiger als 40. Preisstaffel: Kaufmenge = günstigste Staffel ≥ Planmenge. Festigkeitsklasse A2-70 nicht ausgewiesen.  |
| **N-046** DIN 912 M5×10<br>CAD-046 | 36 Stück → 1 × 50 | [SCHRAUBEN](https://schrauben-expert.de/Zylinderschraube-DIN-912-M5-x-10-mm-Edelstahl-A2) / 912 5 10 A2<br>Schrauben.Expert: 912 5 10 A2<br>Expresslager 1–4 Werktage | 6,00 € brutto | 5,04 € / 6,00 € | 50 Stück günstiger als 36. Preisstaffel: Kaufmenge = günstigste Staffel ≥ Planmenge. Festigkeitsklasse A2-70 nicht ausgewiesen.  |
| **N-047** DIN 912 M5×14<br>CAD-047 | 6 Stück → 1 × 10 | [SCHRAUBEN](https://schrauben-expert.de/Zylinderschraube-DIN-912-M5-x-14-mm-Edelstahl-A2) / 912 5 14 A2<br>Schrauben.Expert: 912 5 14 A2<br>Expresslager 1–4 Werktage | 3,30 € brutto | 2,77 € / 3,30 € | Preisstaffel: Kaufmenge = günstigste Staffel ≥ Planmenge. Festigkeitsklasse A2-70 nicht ausgewiesen.  |
| **N-048** DIN 933 M4×20<br>CAD-048 | 10 Stück → 1 × 10 | [SCHRAUBEN](https://schrauben-expert.de/Sechskantschraube-DIN-933-M4-x-20-Edelstahl-V2A) / 933 4 20 A2<br>Schrauben.Expert: 933 4 20 A2<br>Expresslager 1–4 Werktage | 3,30 € brutto | 2,77 € / 3,30 € | SW 7, Vollgewinde. Preisstaffel: Kaufmenge = günstigste Staffel ≥ Planmenge. Festigkeitsklasse A2-70 nicht ausgewiesen.  |
| **N-056** Sechskantmutter DIN 934 M3 A2<br>CAD-056 | 49 Stück → 1 × 50 | [SCHRAUBEN](https://schrauben-expert.de/Sechskantmutter-DIN-934-M3-Edelstahl-V2A) / 934 3 A2<br>Schrauben.Expert: 934 3 A2<br>Expresslager 1–4 Werktage | 6,00 € brutto | 5,04 € / 6,00 € | SW 5,5, H 2,4 = CAD; ISO 4032 identisch. Preisstaffel: Kaufmenge = günstigste Staffel ≥ Planmenge. Festigkeitsklasse A2-70 nicht ausgewiesen.  |
| **N-057** Sechskantmutter DIN 934 M4 A2<br>CAD-057 | 71 Stück → 1 × 100 | [SCHRAUBEN](https://schrauben-expert.de/Sechskantmutter-DIN-934-M4-Edelstahl-V2A) / 934 4 A2<br>Schrauben.Expert: 934 4 A2<br>Expresslager 1–4 Werktage | 7,00 € brutto | 5,88 € / 7,00 € | SW 7, H 3,2 = CAD; ISO 4032 identisch. Preisstaffel: Kaufmenge = günstigste Staffel ≥ Planmenge. Festigkeitsklasse A2-70 nicht ausgewiesen.  |
| **N-058** ISO 8673 Mutter M8<br>CAD-058 | 53 Stück → 1 × 100 | [BEFFUCHS](https://www.befestigungsfuchs.de/eisenwaren/muttern/sechskantmuttern/100-sechskantmuttern-mf8-sw13-feingewinde-1mm-edelstahl-a4-80-din-934) / 24122 08 1<br>Schäfer+Peters: S+P 093448 1<br>verfügbar; Versand in 3 Tagen | 9,41 € brutto | 7,91 € / 9,41 € | A4 statt A2; H 6,5 statt 6,8. Datenblatt nennt Linksgewinde, vermutlich Datenfehler: vor Bestellung klären. Preisstaffel: Kaufmenge = günstigste Staffel ≥ Planmenge. Festigkeitsklasse A2-70 nicht ausgewiesen. Nur kaufen, wenn die Sensoren keine Muttern mitbringen. |
| **MAT-002** 30×30 Nut 6 Aluprofil, Zuschnitt-Los<br>CAD-011;CAD-012;CAD-013;CAD-020 | 1 Los → 1 × 1 | [DOLD](https://www.dold-mechatronik.de/Aluminiumprofil-30x30L-I-Typ-Nut-6-leicht-094kg-m-Zuschnitt-50-6000mm) / 63009-Z<br>DOLD: 63009-Z<br>Zuschnitt auf Bestellung | 93,68 € brutto | 78,72 € / 93,68 € | Raster 30, Nut 6, Kern Ø5 (M6) = CAD; CAD-Querschnitt voller modelliert (Entscheidung Luis 17.10.2026). Los: 2×564 + 3×590 + 12×350 mm = 7,098 m à 12,00 EUR + 17 Schnitte à 0,50 EUR.  |
| **MAT-003** 60×30 Nut 6 Aluprofil schwer, Zuschnitt<br>CAD-014 | 1 Los → 1 × 1 | [DOLD](https://www.dold-mechatronik.de/Aluminiumprofil-30x60S-I-Typ-Nut-6-schwer-22kg-m-Zuschnitt-50-6000mm) / 71370-Z<br>DOLD: 71370-Z<br>Zuschnitt auf Bestellung | 43,00 € brutto | 36,13 € / 43,00 € | 2 Kerne Ø5 = CAD; schwere Variante gewählt (Entscheidung Luis 17.10.2026). 1,3 m à 30,00 EUR + 2 Schnitte à 2,00 EUR.  |
| **MAT-004** Präzisionswellen Ø10, Zuschnitt-Los<br>CAD-069;CAD-098 | 1 Los → 1 × 1 | [DOLD](https://www.voelkner.de/products/10394662/Praezisionswelle-10mm-h6-Edelstahl-X46CR13-Linearwellen-geschliffen-und-gehaertet.-ZUSCHNITT-18-EUR-m-0-60-EUR-pro-Schnitt-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) / D25160720<br>DOLD (über voelkner.de): D25160720<br>Zuschnitt auf Bestellung | 83,64 € brutto | 70,29 € / 83,64 € | Ø10 h 6, gehärtet und geschliffen = CAD. Los: 8×450 + 2×356,8 mm = 4,3136 m à 18 EUR + 10 Schnitte à 0,60 EUR (Preise aus Angebotstitel). Fase an den Enden nicht angegeben.  |
| **SHIP-RBS** RBS Sammelversand Deutschland<br> | 1 Sendung → 1 × 1 | [RBS](https://www.roboter-bausatz.de/c/information/versand-und-zahlung/) / offen<br>nicht festgelegt: offen<br>nicht bestätigt; Angebot/Checkout erforderlich | 0,00 € brutto | 0,00 € / 0,00 € |  Kostenlos ab 99 EUR brutto; geplanter RBS-Warenkorb liegt darüber. |
| **SHIP-REICHELT** Reichelt DHL Deutschland bis 10 kg<br> | 1 Sendung → 1 × 1 | [REICHELT](https://www.reichelt.de/versandkosten) / offen<br>nicht festgelegt: offen<br>nicht bestätigt; Angebot/Checkout erforderlich | 5,95 € brutto | 5,00 € / 5,95 € |  Öffentlicher DHL-Tarif bis 10 kg:5,95EURbrutto. Gewichtunter 10 kg für geplante Elektronik angenommen; endgültigen Warenkorb prüfen. |
| **SHIP-EISEN2000** Eisenwaren 2000 Versand Deutschland<br> | 1 Sendung → 1 × 1 | [EISEN2000](https://www.eisenwaren2000.de/) / offen<br>nicht festgelegt: offen<br>nicht bestätigt; Angebot/Checkout erforderlich | 0,00 € brutto | 0,00 € / 0,00 € |  Versandkostenfrei ab 59 EUR; geplanter Normteile-Warenkorb ca. 92 EUR. |

## Vorläufige Budgetansätze – keine Shopangebote

| ID / Bedarf | Bedarf → Bestellung | Anbieter / Artikel | Preis pro Packung | Summe netto / brutto | Passung / Vorbehalt |
| --- | --- | --- | --- | --- | --- |
| **BUY-015** 4 NEMA14 Z-Motoren, ERSATZ STEPPERONLINE 14HS13-0804S<br>CAD-063 | 4 Stück → 4 × 1 | [STEPPERONLINE](https://www.omc-stepperonline.com/de/nema-14-bipolar-1-8deg-18ncm-25-5oz-in-0-8a-5-74v-35x35x34mm-4-draehte-14hs13-0804s) / 14HS13-0804S | 8,00 € netto | 32,00 € / 38,08 € | 35×35×34,8 mm (Original 36 mm), Welle Ø5×24 mit D-Abflachung, 0,8 A, 18 Ncm, 4 Litzen 400 mm ohne Stecker. Shoppreis 8,48 USD; EUR-Preis im Checkout prüfen. Shoppreis 8,48 USD, als 8 EUR netto geschätzt; EUR-Preis und Versandlager im Checkout prüfen. |
| **MAT-010** Acrylglas-Abdeckungen, Zuschnitt-Los<br>CAD-007;CAD-008 | 1 Los → 1 × 1 | [PLATTENZUSCHNITT24](https://www.plattenzuschnitt24.de/Acrylglas-XT-5mm-transparent.html) / C10000-AC05 | 31,00 € brutto | 26,05 € / 31,00 € | Zuschnitt nach Maß, Kanten wählbar (gefräst/poliert), Kauf auf Rechnung. Preis nur im Konfigurator; Schätzung über 4 mm 58,60 und 6 mm 87,90 EUR/m² bei 0,418 m². Schätzung ca. 74 EUR/m² × 0,418 m² (zwischen 4- und 6-mm-Preis); exakter Preis im Konfigurator. |
| **MAT-005** Versteifungsprofile 40×16 und Halte-/Distanzstäbe<br>CAD-070;CAD-108 | 1 Los → 1 × 1 | [DOLD](https://www.dold-mechatronik.de/) / offen | 100,00 € brutto | 84,03 € / 100,00 € | ABWEICHUNG (Entscheidung Luis 17.10.2026): CAD-Vierkantrohr 11,5×11,5×1,5×205 mm (Fusion-Messung) wird durch Alu-Vierkantrohr 12×12×1 mm ersetzt (keine Last; 12×12×1,5 in DE/EU nicht gefunden); gedruckte Schieber CAD-067 auf 12 mm anpassen. Bezugsquelle z. B. e Bay metalexpres (Al Mg Si 0,5, ab 500 mm), Preis und Lager noch prüfen.; Fusion-Messung: massiver Rundstab Ø4×70 mm, Fasen an beiden Enden, ohne Gewinde. Werkstatt: aus Ø4-h 6-Silberstahl (1.2210) ablängen und anfasen (Entscheidung Luis 17.10.2026). Eigenes 100 EUR-Bruttobudget für Profile 4×436 mm, Rechteck 2×205 mm, Ø8Trigger 4×125+4×75 mm, Ø4 Stäbe 8×70 mm und 4Distanzteile. Material/Profile noch klären. |
| **MAT-006** Blechrohmaterial und Verschnitt<br>CAD-003;CAD-096;CAD-097;CAD-099;CAD-100 | 1 Los → 1 × 1 | [DOLD](https://www.dold-mechatronik.de/) / offen | 200,00 € brutto | 168,07 € / 200,00 € | 650×270×3 mm, 54 Bohrungen Ø3,4, 10 Bohrungen Ø4,5, 1 Bohrung Ø8. 6 Ø4,5-Bohrungen sitzen auf den langen Profilen (M4 + Nutenstein, siehe M01). Zuschnitt und Bohrungen intern; Zeichnung aus CAD ableiten.; 5 mm Stahl, 550×135 mm. Fusion-Messung: 16 Kernlöcher Ø2,46 für M3-Gewinde (Riemenspanner), Senkungen für M6 und Ø22-Durchbrüche für die Motoren. Kontur und Bohrungen aus CAD; Gewinde und Senkungen intern. Zeichnung mit Lagetoleranzen der Führungsbohrungen fehlt.; 5 mm Stahl, 550×135 mm. Fusion-Messung: 16 Kernlöcher Ø2,46 für M3-Gewinde (Riemenspanner), Senkungen für M6 und Ø22-Durchbrüche für die Motoren. Kontur und Bohrungen aus CAD; Gewinde und Senkungen intern. Zeichnung mit Lagetoleranzen der Führungsbohrungen fehlt.; 5 mm Seitenplatte des X-Wagens 55×166,5 mm. Fräszeichnung aus hardware/cad (.par/.dft) ableiten.; 5 mm Seitenplatte des X-Wagens 55×166,5 mm. Fräszeichnung aus hardware/cad (.par/.dft) ableiten. Eigener 200 EUR-Bruttobudgettopf für 3/5 mm Platten und noch nicht abgewickelte Teile. Kein Händlerangebot; Material/Flachzuschnitte noch nicht bestellfähig. Interne Arbeits-/Maschinenzeit ausgeschlossen. |
| **BUD-S011** USB-Kabel für 4 SKR<br>SYS-011 | 1 Los → 1 × 1 | [REICHELT](https://www.reichelt.de/) / offen | 20,00 € brutto | 16,81 € / 20,00 € | Host USB-A auf Board USB-B bestätigen; Länge vorläufig 2 m je Board, Ports/Verlegung prüfen. Eigener Gesamt-Budgetansatz fürden in Teileliste genannten Bedarf; kein konkretes Artikelangebot. Beipack undvorhan dene Bestände abziehen. |
| **BUD-S012** USB-Kabel für MUX/UART/Zielversorgung<br>SYS-012 | 1 Los → 1 × 1 | [REICHELT](https://www.reichelt.de/) / offen | 15,00 € brutto | 12,61 € / 15,00 € | 3 Verbindungen aus Softwarekonfiguration, Geräteseite und enthaltene Kabel offen; nur nach Geräteauswahl kaufen. Eigener Gesamt-Budgetansatz fürden in Teileliste genannten Bedarf; kein konkretes Artikelangebot. Beipack undvorhan dene Bestände abziehen. |
| **BUD-S013** Bewegliche Kameraleitung / USB-Verlängerung<br>SYS-013 | 1 Los → 1 × 1 | [REICHELT](https://www.reichelt.de/) / offen | 15,00 € brutto | 12,61 € / 15,00 € | Schleppkettengeeignete Leitung/Länge/Stecker offen; Kamera-Beipack gegenrechnen. Eigener Gesamt-Budgetansatz fürden in Teileliste genannten Bedarf; kein konkretes Artikelangebot. Beipack undvorhan dene Bestände abziehen. |
| **BUD-S014** Motorleitungen 4adrig<br>SYS-014 | 1 Los → 1 × 1 | [TME](https://www.tme.eu/de/) / offen | 64,00 € brutto | 53,78 € / 64,00 € | Plan 16×2 m; Schleppkettenradius, Querschnitt/Strom, Aderfarben und reale Wege offen. Eigener Gesamt-Budgetansatz fürden in Teileliste genannten Bedarf; kein konkretes Artikelangebot. Beipack undvorhan dene Bestände abziehen. |
| **BUD-S015** Motor-Gegenstecker und Crimpkontakte<br>SYS-015 | 1 Los → 1 × 1 | [TME](https://www.tme.eu/de/) / offen | 25,00 € brutto | 21,01 € / 25,00 € | Plan 2 Enden je 16 Motoren. Board-/Motorhersteller-Raster und Kontaktzahl prüfen; beiliegende Kabel abziehen. Eigener Gesamt-Budgetansatz fürden in Teileliste genannten Bedarf; kein konkretes Artikelangebot. Beipack undvorhan dene Bestände abziehen. |
| **BUD-S018** 24-V-Verteilung, Sicherungen, Klemmen, Leitungen<br>SYS-018 | 1 Los → 1 × 1 | [REICHELT](https://www.reichelt.de/) / offen | 60,00 € brutto | 50,42 € / 60,00 € | 4 Controller+Sensoren+LED; Last/Stromlaufplan, Aderquerschnitte und Sicherungswerte bestimmen. Eigener Gesamt-Budgetansatz fürden in Teileliste genannten Bedarf; kein konkretes Artikelangebot. Beipack undvorhan dene Bestände abziehen. |
| **BUD-S020** Netzeinspeisung, Leitung, Sicherung und Zugentlastung<br>SYS-020 | 1 Los → 1 × 1 | [REICHELT](https://www.reichelt.de/) / offen | 35,00 € brutto | 29,41 € / 35,00 € | 230 V-Anschluss an offenes Netzteil: Anschlussmodul, Netzleitung, Sicherungshalter und geschützter Kabelweg planen. Eigener Gesamt-Budgetansatz fürden in Teileliste genannten Bedarf; kein konkretes Artikelangebot. Beipack undvorhan dene Bestände abziehen. |
| **BUD-S021** Schutzleiter, Ringkabelschuhe und Klemmenabdeckung<br>SYS-021 | 1 Los → 1 × 1 | [REICHELT](https://www.reichelt.de/) / offen | 15,00 € brutto | 12,61 € / 15,00 € | Metallrahmen/Netzteil erden; Querschnitt, Anschlusspunkte und Prüfverfahren in Stromlaufplan dokumentieren. Eigener Gesamt-Budgetansatz fürden in Teileliste genannten Bedarf; kein konkretes Artikelangebot. Beipack undvorhan dene Bestände abziehen. |
| **BUD-S022** Messkoax und instrumentenseitige Adapter<br>SYS-022 | 1 Los → 1 × 1 | [TME](https://www.tme.eu/de/) / offen | 60,00 € brutto | 50,42 € / 60,00 € | Vorhan dene Messgeräte verwenden; BNC/SMA/MMCX und Impedanz gerätespezifisch. CAD-MM CX-Stecker 61/62 sind separat, hier nur Kabel und Instrumentadapter. Eigener Gesamt-Budgetansatz fürden in Teileliste genannten Bedarf; kein konkretes Artikelangebot. Beipack undvorhan dene Bestände abziehen. |
| **BUD-S025** USB-UART-Adapter<br>SYS-025 | 1 Los → 1 × 1 | [TME](https://www.tme.eu/de/) / offen | 20,00 € brutto | 16,81 € / 20,00 € | Software setzt Adapter voraus; Pegel, Isolation, Pinout und Zielversorgung prüfen; Laborausstattung ggf. gegenrechnen. Eigener Gesamt-Budgetansatz fürden in Teileliste genannten Bedarf; kein konkretes Artikelangebot. Beipack undvorhan dene Bestände abziehen. |
| **BUD-S029** Profil-Nutensteine und Zusatzbefestigung<br>SYS-029 | 1 Los → 1 × 1 | [DOLD](https://www.dold-mechatronik.de/) / offen | 35,00 € brutto | 29,41 € / 35,00 € | Nut 6/Profilserie klären; 26Winkel plus Halter. CAD-Vierkantmuttern 29/30 und mitgelieferte Winkelsätze abziehen. Eigener Gesamt-Budgetansatz fürden in Teileliste genannten Bedarf; kein konkretes Artikelangebot. Beipack undvorhan dene Bestände abziehen. |
| **BUD-S030** Scheiben, Sicherungselemente, Distanzteile<br>SYS-030 | 1 Los → 1 × 1 | [SCHRAUBEN](https://schrauben-expert.de/) / offen | 20,00 € brutto | 16,81 € / 20,00 € | Ergänzungsbedarf je Verschraubung/Idler; CAD-Normteile und Sensor-Beipack abziehen. Stückzahlen noch offen. Eigener Gesamt-Budgetansatz fürden in Teileliste genannten Bedarf; kein konkretes Artikelangebot. Beipack undvorhan dene Bestände abziehen. |
| **BUD-S031** Lötzinn, Schrumpfschlauch, Binder, Labels, Kleber<br>SYS-031 | 1 Los → 1 × 1 | [REICHELT](https://www.reichelt.de/) / offen | 35,00 € brutto | 29,41 € / 35,00 € | Verbrauchsmaterialbudget; vorhan dene Bestände später abziehen. Werkzeuge nicht enthalten. Eigener Gesamt-Budgetansatz fürden in Teileliste genannten Bedarf; kein konkretes Artikelangebot. Beipack undvorhan dene Bestände abziehen. |
| **BUD-S032** Controller-Befestigung und Kühlung<br>SYS-032 | 1 Los → 1 × 1 | [RBS](https://www.roboter-bausatz.de/) / offen | 30,00 € brutto | 25,21 € / 30,00 € | Abstandshalter, Isolierung, ggf.Lüfter; SKR/TMC-Beipack und thermische Auslegung prüfen. Eigener Gesamt-Budgetansatz fürden in Teileliste genannten Bedarf; kein konkretes Artikelangebot. Beipack undvorhan dene Bestände abziehen. |
| **FEE-001** Rechnungskaufgebühr Schrauben.Expert<br> | 1 Gebühr → 1 × 1 | [SCHRAUBEN](https://schrauben-expert.de/Zahlungsmoeglichkeiten) / offen | 5,00 € brutto | 4,20 € / 5,00 € |  Öffentlich 5 EUR; brutto angenommen,Steuerbasis im Checkoutprüfen. Ab 3.qualifizierter Bestellung entfallend. |
| **SHIP-BEFFUCHS** Befestigungsfuchs Versand Deutschland<br> | 1 Sendung → 1 × 1 | [BEFFUCHS](https://www.befestigungsfuchs.de/) / offen | 5,95 € brutto | 5,00 € / 5,95 € |  5,95 EUR laut Shop; nur nötig, falls M8×1-Muttern bestellt werden. |
| **SHIP-SCHRAUBEN** Schrauben.Expert Versand Deutschland<br> | 1 Sendung → 1 × 1 | [SCHRAUBEN](https://schrauben-expert.de/) / offen | 4,00 € brutto | 3,36 € / 4,00 € |  Versand nach Gewicht; Produktfeed nennt 4 EUR, Warenkorb ca. 54 EUR liegt unter der 100-EUR-Freigrenze. |
| **SHIP-REST** Frachtreserve fürübrige Lieferanten<br> | 1 Budget → 1 × 1 | noch festzulegen | 150,00 € brutto | 126,05 € / 150,00 € |  Eigene 150 EUR-Bruttoreserve für DOLD/TME/Normteile/Motoren/Führungen/CNC/PCB. Tatsächliche Fracht je Anbieter offen; kein bestätigter Versandpreis. Reichelt/RBS separat. |

## Nochunbezifferte Bestellpositionen

| ID / Bedarf | Bedarf → Bestellung | Anbieter / Artikel | Preis pro Packung | Summe netto / brutto | Passung / Vorbehalt |
| --- | --- | --- | --- | --- | --- |
| **BUY-010** Übersichtskamera ELP-USBFHD01M-H100<br>SYS-002 | 1 Stück → 1 × 1 | [ELP](https://www.elpcctv.com/elp-full-hd-1080p-usb-camera-module-usb20-ov2710-color-sensor-support-mjpeg-with-36mm-lens-p-203.html) / ELP-USBFHD01M-H100 | offen | offen / offen | OV2710, UVC/Linux, M12, Platine 38×38 auf 32×32 kürzbar. Lochraster 28×28 nicht schriftlich bestätigt.  |
| **OPEN-CAD-010** Schubladen-Dummyplatte<br>CAD-010 | 1 Stück → 1 × 1 | [DOLD](https://www.dold-mechatronik.de/) / offen | offen | offen / offen | Schubladen-Dummy 564×410×12 mm: unklar, ob reale Platte benötigt und welches Material. Nicht stillschweigend ausschließen oder aus Stahl fertigen. Preis und/oder Bestellvariante offen. Nicht im numerischen Zwischentotal enthalten. |
| **OPEN-CAD-061** MMCX-Stecker gerade mit RG316, offenes Ende<br>CAD-061 | 4 Stück → 4 × 1 | noch festzulegen | offen | offen / offen | Fusion: MMCX-Stecker mit Kabel Ø2,5 = RG316. rf-connectors.pl liefert MMCX-Pigtails RG316 offen nur bis 30 cm; 1 m nur mit SMA-Gegenstecker (abschneiden) oder als Sonderanfertigung. Länge an Kette/Messgerät festlegen. Preis und/oder Bestellvariante offen. Nicht im numerischen Zwischentotal enthalten. |
| **OPEN-CAD-062** MMCX-Stecker gewinkelt mit RG316, offenes Ende<br>CAD-062 | 4 Stück → 4 × 1 | noch festzulegen | offen | offen / offen | rf-connectors.pl PT_MMCX MLS030Q: gewinkelt, RG316, offen, 30 cm, 33,95 zł. Für 1–1,5 m Sonderlänge anfragen oder MMCX–SMA 1 m kürzen. Preis und/oder Bestellvariante offen. Nicht im numerischen Zwischentotal enthalten. |
| **OPEN-CAD-073** Aufnahmehülse R75 mit Drahtende (CAD: P75-2_W)<br>CAD-073 | 8 Stück → 8 × 1 | noch festzulegen | offen | offen / offen | Fusion-Messung: Ø1,2 × 25,4 mm, Drahtende Ø0,6 × 5 mm = R75-Aufnahmehülse für P75 (Bohrung ca. 1,4 mm). Kein EU-Angebot mit Preis gefunden; Peaktest R75-Serie nur auf Anfrage. Preis und/oder Bestellvariante offen. Nicht im numerischen Zwischentotal enthalten. |
| **OPEN-CAD-075** Prüfspitzen-PCB, unbestückt<br>CAD-075 | 4 Stück → 4 × 1 | [BETA](https://de.beta-layout.com/leiterplatten/) / offen | offen | offen / offen | 4 Stück; CAD nur Quader 26,67×10,96×1,6 mm ohne Daten. Entscheidung Luis 17.10.2026: Originaldaten bei SCHUTZWERK angefragt (Anfrage durch Luis versendet, Antwort offen). Preis und/oder Bestellvariante offen. Nicht im numerischen Zwischentotal enthalten. |
| **OPEN-SYS-003** Signal-Multiplexer, unbestückte Leiterplatte<br>SYS-003 | 1 Stück → 1 × 1 | [JLCPCB](https://jlcpcb.com/) / offen | offen | offen / offen | SCHUTZWERK-Original: 4 Lagen, Gerber hardware/signal-multiplexer/hardware/gerber 1.1/gerber 1.1.zip (deckungsgleich mit mux.kicad_pcb, geprüft 26.10.2026). Bei JLCPCB bestellen. Preis und/oder Bestellvariante offen. Nicht im numerischen Zwischentotal enthalten. |
| **OPEN-SYS-005** Innere Messing-Referenzzylinder Ø7/8/9/10<br>SYS-005 | 4 Stück → 4 × 1 | noch festzulegen | offen | offen / offen | WERKSTATT aus Messing-Rundstab (Entscheidung Luis 18.10.2026): je 1× Ø7/8/9/10 mm, Raster 11,95×19,95 mm, Endfläche bündig mit der Plattenoberfläche. Länge = Plattendicke 5,1 mm plus Einpresstiefe. Preis und/oder Bestellvariante offen. Nicht im numerischen Zwischentotal enthalten. |
| **OPEN-SYS-009** LED-Anschluss an den Heizbett-Ausgang der Licht-Steuerplatine<br>SYS-009 | 1 Satz → 1 × 1 | [REICHELT](https://www.reichelt.de/) / offen | offen | offen / offen | Configuration_adv.h:4396 setzt PROBOTER_LIGHT_CONTROL_PIN auf HEATER_BED_PIN; M376 steuert Helligkeit. Kein separater USB-LED-Controller nötig. Stecker/Leitungen, Strom und Flimmern prüfen; keine zusätzliche MOSFET-Platine pauschal kaufen. Preis und/oder Bestellvariante offen. Nicht im numerischen Zwischentotal enthalten. |
| **OPEN-SYS-017** Sensor-Gegenstecker und Kontakte<br>SYS-017 | 28 Satz → 28 × 1 | [TME](https://www.tme.eu/de/) / offen | offen | offen / offen | 24 induktiv+4 optisch; bei steckerfertigem Beipack reduzieren. Keine generischen JST/Dupont ohne Rasterprüfung. Preis und/oder Bestellvariante offen. Nicht im numerischen Zwischentotal enthalten. |
| **OPEN-SYS-019** Sensor-Pegelanpassung / Eingangsschutz<br>SYS-019 | 24 Kanäle → 24 × 1 | [BETA](https://de.beta-layout.com/leiterplatten/) / offen | offen | offen / offen | Bedarf abhängig von M8-Ausgang; 24 V/3,3 V-Interface. Keine Schaltung/BOM vorhan den; nicht blind 24Module bestellen. Preis und/oder Bestellvariante offen. Nicht im numerischen Zwischentotal enthalten. |
| **OPEN-SYS-023** Signal-Multiplexer Bestückung<br>SYS-023 | 1 Baugruppe → 1 × 1 | [JLCPCB](https://jlcpcb.com/) / offen | offen | offen / offen | Board-BOM hardware/signal-multiplexer/hardware/mux.csv (76 Bauteile, u. a. 6 Relais TE 6-1462037-3, SMA, USB-B, DB9). Bestückung bei JLCPCB oder selbst; MPNs/LCSC-Nummern noch zuordnen. Preis und/oder Bestellvariante offen. Nicht im numerischen Zwischentotal enthalten. |
| **OPEN-SYS-024** Prüfspitzen-PCB Bestückung<br>SYS-024 | 4 Baugruppen → 4 × 1 | [BETA](https://de.beta-layout.com/leiterplatten/) / offen | offen | offen / offen | CAD-MM CX/Federkontakte separat; zusätzliche Buchsen und Bauteile erst aus Schaltplan. Unbestückte Platine CAD-075 nicht erneut zählen. Preis und/oder Bestellvariante offen. Nicht im numerischen Zwischentotal enthalten. |
| **OPEN-SYS-026** Zielplatinen-Versorgungscontroller<br>SYS-026 | 1 Baugruppe → 1 × 1 | [BETA](https://de.beta-layout.com/leiterplatten/) / offen | offen | offen / offen | Softwareziel /dev/proboter_target-power-controller; Schaltung, Firmware/Hardware und Kabel fehlen. Separat vom RSP-Netzteil. Preis und/oder Bestellvariante offen. Nicht im numerischen Zwischentotal enthalten. |
| **OPEN-SYS-038** Kalibrier-Kontaktleitungen und gemeinsame Messreferenz<br>SYS-038 | 1 Satz → 1 × 1 | [TME](https://www.tme.eu/de/) / offen | offen | offen / offen | 4 SKR-Zentriereingänge P0_17 mit Pull-up/aktiv Low sowie Referenzkörper/Kontaktkreis verdrahten. Netzplan, Stecker, Länge und Bezugspotenzial mit Multiplexer klären; keine Verbindung ungeprüft festlegen. Preis und/oder Bestellvariante offen. Nicht im numerischen Zwischentotal enthalten. |
| **OPEN-SYS-039** Erhöhte Messing-Referenzzylinder<br>SYS-039 | 4 Stück → 4 × 1 | noch festzulegen | offen | offen / offen | WERKSTATT aus Messing-Rundstab Ø7 (Entscheidung Luis 18.10.2026): Raster 59,6×39,9 mm, Endflächen 6/8/10/12 mm über der Plattenoberfläche, in Türmen der Platte. Preis und/oder Bestellvariante offen. Nicht im numerischen Zwischentotal enthalten. |
| **OPEN-SYS-040** Äußere flache Messing-Referenzzylinder Ø7<br>SYS-040 | 4 Stück → 4 × 1 | noch festzulegen | offen | offen / offen | WERKSTATT aus Messing-Rundstab Ø7 (Entscheidung Luis 18.10.2026): Mittelpunkte (±54,95; 0) und (0; ±44,9) mm, bündig. Preis und/oder Bestellvariante offen. Nicht im numerischen Zwischentotal enthalten. |
| **OPEN-SYS-058** Prüfstifte P75 Flachspitze zum Bestromen von Pads (Spitzenauswahl)<br>SYS-058 | 10 Stück → 10 × 1 | noch festzulegen | offen | offen / offen | Wunsch Luis (17.10.2026). Flachspitzen-Code uneinheitlich (Peaktest: F flach, A konkav, D2 Kuppe); kein Lagerangebot gefunden, Spitzenzeichnung beim Händler anfordern. Preis und/oder Bestellvariante offen. Nicht im numerischen Zwischentotal enthalten. |
| **OPEN-SYS-073** Energiekette Schublade igus E2C.10.10.028.0, 0,5 m<br>SYS-073 | 2 Stück → 2 × 1 | [IGUS](https://www.igus.de/) / offen | offen | offen / offen | drag_chain_0_5m_E2C_10_10_028_0 in drawer_drag_chain.asm: 2 Ketten je 25 Glieder (Fusion-Messung) mit Anschlüssen E2.100.10.56PZ.A1 (SYS-074) (Entscheidung Luis 26.10.2026). Preis und/oder Bestellvariante offen. Nicht im numerischen Zwischentotal enthalten. |
| **OPEN-SYS-074** Anschlusssatz igus E2.100.10.56PZ.A1, Schubladenkette<br>SYS-074 | 2 Satz → 2 × 1 | [IGUS](https://www.igus.de/) / offen | offen | offen / offen | Anschlüsse zu SYS-073, laut CAD-Dateiname (Entscheidung Luis 26.10.2026). Preis und/oder Bestellvariante offen. Nicht im numerischen Zwischentotal enthalten. |

## Optionen und Vergleiche – nicht im Grundtotal

| ID | Artikel / Quelle | Menge | brutto | Einschränkung |
| --- | --- | --- | --- | --- |
| ALT-001 | [MR12MLVergleich, keine bestätigte CPC-Paarung](https://www.motedis.com/de/Fuehrungswagen-Miniatur-MR12ML-SS-V0-N-Edelstahl) | 8 | 185,74 € | Vergleichsangebot; CPC-Herkunft und Paarung nicht bestätigt. Anzeige hatte 20%USt, hier Netto mit 19%DE kalkuliert. Nicht im Basistotal.  |
| ALT-002 | [MGN12CNachbauvergleich, kein HIWIN](https://www.dold-mechatronik.de/Linear-carriage-MGN12C) | 4 | 48,00 € | Kein HIWIN-Original, nur gemeinsam mit passender Schiene prüfen. Nicht mit Originalschienen mischen; nicht im Basistotal.  |
| OPT-001 | [3zusätzliche Mikroskope](https://www.reichelt.de/de/de/shop/produkt/digital_mikroskop_50-_1000x_wifi_2_0-380934) | 3 | 164,97 € | Ersatzkandidat USB/Wi Fi. Linux-UVC, 100 mm Arbeitsabstand bei ca 30×40 mm Bildfeld und Halterpassung unbewiesen; nicht als kompatibel freigegeben. Nur Kamerapreis; zusätzliche Kabel, Halteränderung und USB-Topologie nicht kalkuliert. |

Lieferstatus, Hersteller/MPN und Preisdatum stehen vollständig in der [Bestell-CSV](bestellliste.csv) und [Angebotsdatei](data/offers.json). Sämtliche Webpreise sind EUR; Versand pro Lieferant siehe [Lieferanten](Lieferanten.md). Es wurden keine Bestellungen ausgelöst.
