floronics/ProBoter/bom/Fertigung.md

# Fertigungsliste und Anforderungen für Angebote

**Alle Sonderteile benötigen noch eine Freigabe von Werkstoff, Passungen und Zeichnung.**
Die folgende Einteilung ist eine begründete Fertigungsplanung. Originalbelege und
Vorschläge stehen getrennt in der Tabelle. Maße sind lokale CAD-Hüllmaße in mm,
keine tolerierten Fertigungszeichnungen und bei Biegeteilen keine Flachzuschnitte.
Der Fusion-Import setzt nahezu überall „Stahl“; das ist kein Materialbeleg.

[Teileliste](Teileliste.md) · [Kosten](Kosten.md) · [CAD-Messdaten](evidence/cad-geometry.csv)

## 3D-Druck intern

PETG als nichtleitender Ausgangsvorschlag; bei wärmeren Motorhaltern ggf. temperaturfesteren Werkstoff testen. Originalwerkstoff unbekannt. 0,2-mm-Schichthöhe, vier Außenwände und 40–60% Infill sind ausschließlich Versuchsvorschläge. Führungs-/Lagersitze mit Probekörper und gegebenenfalls Nacharbeit qualifizieren; Gewinde/Inserts nur nach Zeichnung. Druckrichtung nach Kraftfluss, Stützen und Bauräumen festlegen. Keine pauschale Passung aus Hüllmaßen ableiten.

Materialkalkulation: Summe der CAD-Vollvolumen × Planmenge × angenommene Dichte 1,27 g/cm³, plus 20% für Stützen/Fehldrucke; zusätzlich 1 kg für Kalibrierkörper/Versuche. Auf volle 1 kg-Rollen gerundet. Das ist ein bewusst konservativer Budgetansatz, kein Slicerresultat. Der echte Materialbedarf hängt von Infill, Wänden und Orientierung ab. Arbeitszeit/Maschinenkosten sind ausgeschlossen.

| ID / Teil | Planmenge | CAD-Hülle mm / Volumen je Teil | Verfahren / Werkstoffbeleg | Offen |
| --- | --- | --- | --- | --- |
| CAD-001 Y-Riemenklemme (CAD-Name TR10x 2 GT2 Adapter) | 4 Stück | 15.0 x 20.0 x 22.0 / 3.981555 cm³ | 3D-Druck intern, PETG, Geometrie als STL aus dem CAD (Entscheidung Luis 17.10.2026); PETG vorgeschlagen; Importmaterial Stahl ist kein Nachweis | Geometrie vorhan den; Druckorientierung, Passungen, Befestigung und Belastbarkeit festlegen. Volumen siehe CSV; kein Slicerbedarf. |
| CAD-002 Y-Riemenklemme, Deckel | 4 Stück | 7.0 x 20.0 x 20.494 / 1.770131 cm³ | 3D-Druck intern, PETG, Geometrie als STL aus dem CAD (Entscheidung Luis 17.10.2026); PETG vorgeschlagen; Importmaterial Stahl ist kein Nachweis | Geometrie vorhan den; Druckorientierung, Passungen, Befestigung und Belastbarkeit festlegen. Volumen siehe CSV; kein Slicerbedarf. |
| CAD-004 Grundgestell: Kabel Halter M3 flach | 2 Stück | 18.0 x 10.0 x 8.0 / 0.966242 cm³ | 3D-Druck intern, PETG, Geometrie als STL aus dem CAD (Entscheidung Luis 17.10.2026); PETG vorgeschlagen; Importmaterial Stahl ist kein Nachweis | Geometrie vorhan den; Druckorientierung, Passungen, Befestigung und Belastbarkeit festlegen. Volumen siehe CSV; kein Slicerbedarf. |
| CAD-005 Grundgestell: Kabel Halter M4 | 1 Stück | 18.0 x 12.0 x 10.5 / 1.508093 cm³ | 3D-Druck intern, PETG, Geometrie als STL aus dem CAD (Entscheidung Luis 17.10.2026); PETG vorgeschlagen; Importmaterial Stahl ist kein Nachweis | Geometrie vorhan den; Druckorientierung, Passungen, Befestigung und Belastbarkeit festlegen. Volumen siehe CSV; kein Slicerbedarf. |
| CAD-006 Grundgestell: Kabel Halter M5 flach | 4 Stück | 18.0 x 14.0 x 10.0 / 1.496717 cm³ | 3D-Druck intern, PETG, Geometrie als STL aus dem CAD (Entscheidung Luis 17.10.2026); PETG vorgeschlagen; Importmaterial Stahl ist kein Nachweis | Geometrie vorhan den; Druckorientierung, Passungen, Befestigung und Belastbarkeit festlegen. Volumen siehe CSV; kein Slicerbedarf. |
| CAD-015 Grundgestell: NEMA 14 auf 17 Adapter | 12 Stück | 40.0 x 45.0 x 52.0 / 20.242618 cm³ | 3D-Druck intern, PETG, Geometrie als STL aus dem CAD (Entscheidung Luis 17.10.2026); PETG vorgeschlagen; Importmaterial Stahl ist kein Nachweis | Geometrie vorhan den; Druckorientierung, Passungen, Befestigung und Belastbarkeit festlegen. Volumen siehe CSV; kein Slicerbedarf. |
| CAD-016 Grundgestell: Platte Adapter 1 | 2 Stück | 130.4 x 10.0 x 91.0 / 75.20469 cm³ | 3D-Druck intern, PETG, Geometrie als STL aus dem CAD (Entscheidung Luis 17.10.2026); PETG; SCHUTZWERK-Original liegt in printed_parts (hardware/cad) | Druckteil laut SCHUTZWERK-Solid-Edge-Ordner printed_parts (Entscheidung Luis 26.10.2026, vorher Werkstattplatte). Geometrie aus hardware/cad bzw. STEP. |
| CAD-017 Grundgestell: Platte Adapter 2 | 2 Stück | 130.5 x 10.0 x 91.0 / 74.711929 cm³ | 3D-Druck intern, PETG, Geometrie als STL aus dem CAD (Entscheidung Luis 17.10.2026); PETG; SCHUTZWERK-Original liegt in printed_parts (hardware/cad) | Druckteil laut SCHUTZWERK-Solid-Edge-Ordner printed_parts (Entscheidung Luis 26.10.2026, vorher Werkstattplatte). Geometrie aus hardware/cad bzw. STEP. |
| CAD-018 Grundgestell: Platte Adapter links | 2 Stück | 162.0 x 10.0 x 67.079 / 49.256445 cm³ | 3D-Druck intern, PETG, Geometrie als STL aus dem CAD (Entscheidung Luis 17.10.2026); PETG; SCHUTZWERK-Original liegt in printed_parts (hardware/cad) | Druckteil laut SCHUTZWERK-Solid-Edge-Ordner printed_parts (Entscheidung Luis 26.10.2026, vorher Werkstattplatte). Geometrie aus hardware/cad bzw. STEP. |
| CAD-019 Grundgestell: Platte Adapter rechts | 2 Stück | 162.0 x 10.0 x 67.079 / 49.256445 cm³ | 3D-Druck intern, PETG, Geometrie als STL aus dem CAD (Entscheidung Luis 17.10.2026); PETG; SCHUTZWERK-Original liegt in printed_parts (hardware/cad) | Druckteil laut SCHUTZWERK-Solid-Edge-Ordner printed_parts (Entscheidung Luis 26.10.2026, vorher Werkstattplatte). Geometrie aus hardware/cad bzw. STEP. |
| CAD-021 Riemen Spanner GT2 Basis | 20 Stück | 44.0 x 35.0 x 20.0 / 10.843249 cm³ | 3D-Druck intern, PETG, Geometrie als STL aus dem CAD (Entscheidung Luis 17.10.2026); PETG vorgeschlagen; Importmaterial Stahl ist kein Nachweis | Geometrie vorhan den; Druckorientierung, Passungen, Befestigung und Belastbarkeit festlegen. Volumen siehe CSV; kein Slicerbedarf. |
| CAD-022 Riemen Spanner GT2 Flügel | 20 Stück | 40.0 x 20.0 x 10.0 / 4.903973 cm³ | 3D-Druck intern, PETG, Geometrie als STL aus dem CAD (Entscheidung Luis 17.10.2026); PETG vorgeschlagen; Importmaterial Stahl ist kein Nachweis | Geometrie vorhan den; Druckorientierung, Passungen, Befestigung und Belastbarkeit festlegen. Volumen siehe CSV; kein Slicerbedarf. |
| CAD-024 Kabel Abdeckung | 4 Stück | 22.0 x 58.0 x 3.0 / 1.12083 cm³ | 3D-Druck intern, PETG, Geometrie als STL aus dem CAD (Entscheidung Luis 17.10.2026); PETG (Entscheidung Luis 17.10.2026); Original Blech 3 mm | Kabelabdeckung 22×58×3 mm mit 16 Bohrungen Ø4, als PETG-Druckteil statt Blech. |
| CAD-025 Kamera Halter | 1 Stück | 37.0 x 42.0 x 19.0 / 7.664257 cm³ | 3D-Druck intern, PETG, Geometrie als STL aus dem CAD (Entscheidung Luis 17.10.2026); PETG vorgeschlagen; Importmaterial Stahl ist kein Nachweis | Geometrie vorhan den; Druckorientierung, Passungen, Befestigung und Belastbarkeit festlegen. Volumen siehe CSV; kein Slicerbedarf. |
| CAD-026 Kamera Halter oben | 1 Stück | 104.0 x 56.63 x 5.0 / 11.238009 cm³ | 3D-Druck intern, PETG, Geometrie als STL aus dem CAD (Entscheidung Luis 17.10.2026); PETG; SCHUTZWERK-Original liegt in printed_parts (hardware/cad) | Druckteil laut SCHUTZWERK-Solid-Edge-Ordner printed_parts (Entscheidung Luis 26.10.2026, vorher Werkstattplatte). Geometrie aus hardware/cad bzw. STEP. |
| CAD-067 Platine Halter Gleiter | 4 Stück | 24.0 x 30.0 x 18.0 / 7.265163 cm³ | 3D-Druck intern, PETG, Geometrie als STL aus dem CAD (Entscheidung Luis 17.10.2026); PETG vorgeschlagen; Importmaterial Stahl ist kein Nachweis | Geometrie vorhan den; Druckorientierung, Passungen, Befestigung und Belastbarkeit festlegen. Volumen siehe CSV; kein Slicerbedarf. |
| CAD-068 Platine Halter Führung Halter rund d 10 | 4 Stück | 37.0 x 14.0 x 26.5 / 6.961743 cm³ | 3D-Druck intern, PETG, Geometrie als STL aus dem CAD (Entscheidung Luis 17.10.2026); PETG vorgeschlagen; Importmaterial Stahl ist kein Nachweis | Geometrie vorhan den; Druckorientierung, Passungen, Befestigung und Belastbarkeit festlegen. Volumen siehe CSV; kein Slicerbedarf. |
| CAD-071 Platine Halter Stange kurz rund d 10 | 2 Stück | 30.0 x 30.0 x 18.0 / 9.311414 cm³ | 3D-Druck intern, PETG, Geometrie als STL aus dem CAD (Entscheidung Luis 17.10.2026); PETG vorgeschlagen; Importmaterial Stahl ist kein Nachweis | Geometrie vorhan den; Druckorientierung, Passungen, Befestigung und Belastbarkeit festlegen. Volumen siehe CSV; kein Slicerbedarf. |
| CAD-072 Platine Halter Stange kurz rund d 10 gespiegelt | 2 Stück | 30.0 x 30.0 x 18.0 / 9.311414 cm³ | 3D-Druck intern, PETG, Geometrie als STL aus dem CAD (Entscheidung Luis 17.10.2026); PETG vorgeschlagen; Importmaterial Stahl ist kein Nachweis | Geometrie vorhan den; Druckorientierung, Passungen, Befestigung und Belastbarkeit festlegen. Volumen siehe CSV; kein Slicerbedarf. |
| CAD-074 Stromversorgung Schalter Halter | 1 Stück | 65.0 x 30.0 x 41.0 / 22.245151 cm³ | 3D-Druck intern, PETG, Geometrie als STL aus dem CAD (Entscheidung Luis 17.10.2026); PETG vorgeschlagen; Importmaterial Stahl ist kein Nachweis | Geometrie vorhan den; Druckorientierung, Passungen, Befestigung und Belastbarkeit festlegen. Volumen siehe CSV; kein Slicerbedarf. |
| CAD-083 Signal-Multiplexer Halter | 1 Stück | 117.0 x 103.0 x 45.0 / 35.446738 cm³ | 3D-Druck intern, PETG, Geometrie als STL aus dem CAD (Entscheidung Luis 17.10.2026); PETG vorgeschlagen; Importmaterial Stahl ist kein Nachweis | Geometrie vorhan den; Druckorientierung, Passungen, Befestigung und Belastbarkeit festlegen. Volumen siehe CSV; kein Slicerbedarf. |
| CAD-088 X-Achse Riemen Halter | 4 Stück | 47.0 x 20.0 x 44.0 / 14.729328 cm³ | 3D-Druck intern, PETG, Geometrie als STL aus dem CAD (Entscheidung Luis 17.10.2026); PETG vorgeschlagen; Importmaterial Stahl ist kein Nachweis | Geometrie vorhan den; Druckorientierung, Passungen, Befestigung und Belastbarkeit festlegen. Volumen siehe CSV; kein Slicerbedarf. |
| CAD-089 X-Achse Riemen Halter 1 | 12 Stück | 35.0 x 20.0 x 44.0 / 12.473 cm³ | 3D-Druck intern, PETG, Geometrie als STL aus dem CAD (Entscheidung Luis 17.10.2026); PETG vorgeschlagen; Importmaterial Stahl ist kein Nachweis | Geometrie vorhan den; Druckorientierung, Passungen, Befestigung und Belastbarkeit festlegen. Volumen siehe CSV; kein Slicerbedarf. |
| CAD-090 X-Achse Schlepp Energiekette Adapter | 8 Stück | 45.7 x 30.0 x 7.0 / 5.763221 cm³ | 3D-Druck intern, PETG, Geometrie als STL aus dem CAD (Entscheidung Luis 17.10.2026); PETG vorgeschlagen; Importmaterial Stahl ist kein Nachweis | Geometrie vorhan den; Druckorientierung, Passungen, Befestigung und Belastbarkeit festlegen. Volumen siehe CSV; kein Slicerbedarf. |
| CAD-091 X-Achse Endschalter Halter Seite kurz | 4 Stück | 12.0 x 68.5 x 12.0 / 6.096681 cm³ | 3D-Druck intern, PETG, Geometrie als STL aus dem CAD (Entscheidung Luis 17.10.2026); PETG vorgeschlagen; Importmaterial Stahl ist kein Nachweis | Geometrie vorhan den; Druckorientierung, Passungen, Befestigung und Belastbarkeit festlegen. Volumen siehe CSV; kein Slicerbedarf. |
| CAD-092 X-Achse Endschalter Halter oben lang | 4 Stück | 15.0 x 98.5 x 18.2 / 13.721216 cm³ | 3D-Druck intern, PETG, Geometrie als STL aus dem CAD (Entscheidung Luis 17.10.2026); PETG vorgeschlagen; Importmaterial Stahl ist kein Nachweis | Geometrie vorhan den; Druckorientierung, Passungen, Befestigung und Belastbarkeit festlegen. Volumen siehe CSV; kein Slicerbedarf. |
| CAD-101 X-Achse Schlitten induktiv Endschalter Adapter | 4 Stück | 20.5 x 50.0 x 48.5 / 12.153573 cm³ | 3D-Druck intern, PETG, Geometrie als STL aus dem CAD (Entscheidung Luis 17.10.2026); PETG vorgeschlagen; Importmaterial Stahl ist kein Nachweis | Geometrie vorhan den; Druckorientierung, Passungen, Befestigung und Belastbarkeit festlegen. Volumen siehe CSV; kein Slicerbedarf. |
| CAD-102 X-Achse Schlitten induktiv Endschalter Adapter gespiegelt | 4 Stück | 20.5 x 50.0 x 48.5 / 12.153573 cm³ | 3D-Druck intern, PETG, Geometrie als STL aus dem CAD (Entscheidung Luis 17.10.2026); PETG vorgeschlagen; Importmaterial Stahl ist kein Nachweis | Geometrie vorhan den; Druckorientierung, Passungen, Befestigung und Belastbarkeit festlegen. Volumen siehe CSV; kein Slicerbedarf. |
| CAD-105 Y-Achse Kamera Halter | 2 Stück | 50.816 x 51.0 x 35.0 / 23.701206 cm³ | 3D-Druck intern, PETG, Geometrie als STL aus dem CAD (Entscheidung Luis 17.10.2026); PETG vorgeschlagen; Importmaterial Stahl ist kein Nachweis | Geometrie vorhan den; Druckorientierung, Passungen, Befestigung und Belastbarkeit festlegen. Volumen siehe CSV; kein Slicerbedarf. |
| CAD-106 Y-Achse Kamera Halter kompakt | 2 Stück | 55.982 x 42.0 x 40.0 / 14.609185 cm³ | 3D-Druck intern, PETG, Geometrie als STL aus dem CAD (Entscheidung Luis 17.10.2026); PETG vorgeschlagen; Importmaterial Stahl ist kein Nachweis | Geometrie vorhan den; Druckorientierung, Passungen, Befestigung und Belastbarkeit festlegen. Volumen siehe CSV; kein Slicerbedarf. |
| CAD-107 Y-Achse Schlitten | 2 Stück | 65.0 x 19.8 x 136.0 / 83.210787 cm³ | 3D-Druck belegt (Thesis PDF-Seite 67); Druckparameter/Werkstoff vorgeschlagen; PETG vorgeschlagen; Importmaterial Stahl ist kein Nachweis | Geometrie vorhan den; Druckorientierung, Passungen, Befestigung und Belastbarkeit festlegen. Volumen siehe CSV; kein Slicerbedarf. |
| CAD-109 Y-Achse Schlitten Abstand Rohr 2 mm | 4 Stück | 3.0 x 10.0 x 10.0 / 0.099787 cm³ | 3D-Druck intern, PETG, Geometrie als STL aus dem CAD (Entscheidung Luis 17.10.2026); PETG (Entscheidung Luis 17.10.2026) | Fusion-Messung: Hülse Ø3/Ø4,8 × 3 mm (Name sagt 2 mm). Als PETG-Druckteil (Entscheidung Luis 17.10.2026); kein passender Kaufartikel gefunden. |
| CAD-110 Y-Achse Schlitten gespiegelt | 2 Stück | 65.0 x 19.8 x 136.0 / 83.210787 cm³ | 3D-Druck belegt (Thesis PDF-Seite 67); Druckparameter/Werkstoff vorgeschlagen; PETG vorgeschlagen; Importmaterial Stahl ist kein Nachweis | Geometrie vorhan den; Druckorientierung, Passungen, Befestigung und Belastbarkeit festlegen. Volumen siehe CSV; kein Slicerbedarf. |
| CAD-111 Y-Achse Schlitten gespiegelt oben | 2 Stück | 65.0 x 14.0 x 82.0 / 44.189726 cm³ | 3D-Druck belegt (Thesis PDF-Seite 67); Druckparameter/Werkstoff vorgeschlagen; PETG vorgeschlagen; Importmaterial Stahl ist kein Nachweis | Geometrie vorhan den; Druckorientierung, Passungen, Befestigung und Belastbarkeit festlegen. Volumen siehe CSV; kein Slicerbedarf. |
| CAD-112 Y-Achse Schlitten oben | 2 Stück | 65.0 x 14.0 x 82.0 / 44.189726 cm³ | 3D-Druck belegt (Thesis PDF-Seite 67); Druckparameter/Werkstoff vorgeschlagen; PETG vorgeschlagen; Importmaterial Stahl ist kein Nachweis | Geometrie vorhan den; Druckorientierung, Passungen, Befestigung und Belastbarkeit festlegen. Volumen siehe CSV; kein Slicerbedarf. |
| CAD-114 Z-Achse Antrieb Riemen Halter v 3 | 4 Stück | 35.0 x 15.0 x 35.0 / 8.11167 cm³ | 3D-Druck intern, PETG, Geometrie als STL aus dem CAD (Entscheidung Luis 17.10.2026); PETG vorgeschlagen; Importmaterial Stahl ist kein Nachweis | Geometrie vorhan den; Druckorientierung, Passungen, Befestigung und Belastbarkeit festlegen. Volumen siehe CSV; kein Slicerbedarf. |
| CAD-116 Z-Achse Prüfspitze Platine Halter | 2 Stück | 79.382 x 16.0 x 12.0 / 8.592166 cm³ | 3D-Druck belegt (Thesis PDF-Seite 67); Druckparameter/Werkstoff vorgeschlagen; PETG vorgeschlagen; Importmaterial Stahl ist kein Nachweis | Geometrie vorhan den; Druckorientierung, Passungen, Befestigung und Belastbarkeit festlegen. Volumen siehe CSV; kein Slicerbedarf. |
| CAD-117 Z-Achse Prüfspitze Platine Halter lang | 2 Stück | 103.413 x 16.0 x 55.0 / 16.318702 cm³ | 3D-Druck belegt (Thesis PDF-Seite 67); Druckparameter/Werkstoff vorgeschlagen; PETG vorgeschlagen; Importmaterial Stahl ist kein Nachweis | Geometrie vorhan den; Druckorientierung, Passungen, Befestigung und Belastbarkeit festlegen. Volumen siehe CSV; kein Slicerbedarf. |
| CAD-118 Z-Achse Schlitten Kabel Halter | 4 Stück | 16.0 x 8.0 x 10.0 / 0.762873 cm³ | 3D-Druck intern, PETG, Geometrie als STL aus dem CAD (Entscheidung Luis 17.10.2026); PETG vorgeschlagen; Importmaterial Stahl ist kein Nachweis | Geometrie vorhan den; Druckorientierung, Passungen, Befestigung und Belastbarkeit festlegen. Volumen siehe CSV; kein Slicerbedarf. |
| CAD-119 Z-Achse Schlitten Endschalter Auslöser | 2 Stück | 9.05 x 22.5 x 15.0 / 0.30959 cm³ | 3D-Druck intern, PETG, Geometrie als STL aus dem CAD (Entscheidung Luis 17.10.2026); PETG (Entscheidung Luis 17.10.2026); Original Blechteil | Auslöser für den optischen Z-Endschalter, keine Last. Statt Blech als PETG-Druckteil (Entscheidung 17.10.2026). |
| CAD-120 Z-Achse Schlitten Endschalter Auslöser gespiegelt | 2 Stück | 9.05 x 22.5 x 15.0 / 0.30959 cm³ | 3D-Druck intern, PETG, Geometrie als STL aus dem CAD (Entscheidung Luis 17.10.2026); PETG (Entscheidung Luis 17.10.2026); Original Blechteil | Auslöser für den optischen Z-Endschalter, keine Last. Statt Blech als PETG-Druckteil (Entscheidung 17.10.2026). |
| SYS-061 Kalibrierplatte Version 4, Druck | 1 Stück | 110 x 130 x 17 / 65.476 cm³ | 3D-Druck intern, Geometrie aus Solid Edge calibration_plate_v 4.par; ../hardware/cad; PETG | SCHUTZWERK-Original calibration_plate_v 4 (Baugruppe calibration_plate.asm), 110×130×17 mm, ersetzt die Alu-Platte SYS-004 (Entscheidung Luis 26.10.2026). Bohrungen für Ø7/8/9/10 Messingstifte und 4× Ø10,1 für SYS-063 vorhan den. |
| SYS-062 Kalibrier-Markereinlagen IDs 1/3/6/12, Druck | 4 Stück | 18.2 x 1.9 x 18.2 / 0.527 cm³ | 3D-Druck intern, Geometrie aus Solid Edge calibration_plate_marker_fill_001.par; ../hardware/cad; PETG | calibration_plate_marker_fill_001/003/006/012, je 18,2×18,2×1,9 mm, weiß in die schwarze Platte (Farbwechsel/Einleger). Ersetzt die Gravur SYS-006 (Entscheidung Luis 26.10.2026). |
| SYS-063 Kalibrierstifte, Druck | 4 Stück | 10 x 10 x 8 / 0.316 cm³ | 3D-Druck intern, Geometrie aus Solid Edge calibration_plate_pin.par; ../hardware/cad; PETG | calibration_plate_pin Ø10×8 mm (Stufen Ø7/Ø5), 4× in calibration_plate.asm. Passt in die 4 Bohrungen Ø10,1 der Platte, vermutlich die weißen Außenreferenzen; ersetzt SYS-037 (bei SCHUTZWERK bestätigen). |
| SYS-064 Schleppkettenhalter Schublade, gestellseitig, Druck | 1 Stück | 52 x 30 x 10 / 10.374 cm³ | 3D-Druck intern, Geometrie aus Solid Edge base_drawer_drag_chain_holder.par; ../hardware/cad; PETG | base_drawer_drag_chain_holder aus Baugruppe drawer_drag_chain (Entscheidung Luis 26.10.2026). |
| SYS-065 Schleppkettenhalter Schublade, schubladenseitig, Druck | 1 Stück | 120 x 25 x 40 / 31.445 cm³ | 3D-Druck intern, Geometrie aus Solid Edge drawer_drag_chain_holder.par; ../hardware/cad; PETG | drawer_drag_chain_holder aus Baugruppe drawer_drag_chain (Entscheidung Luis 26.10.2026). |
| SYS-066 Netzbuchsenhalter Schublade, Druck | 1 Stück | 102 x 24 x 30 / 30.008 cm³ | 3D-Druck intern, Geometrie aus Solid Edge base_drawer_power_plug_socket.par; ../hardware/cad; PETG | base_drawer_power_plug_socket, 102×24×30 mm (Entscheidung Luis 26.10.2026). Buchsentyp bei SCHUTZWERK anfragen. |
| SYS-067 Gehäuse Zielplatinen-Versorgungsschalter, Druck | 1 Stück | 95 x 28 x 75 / 48.525 cm³ | 3D-Druck intern, Geometrie aus Solid Edge target_power_switch.par; ../hardware/cad; PETG | target_power_switch, 95×28×75 mm; Gehäuse für SYS-026 (Entscheidung Luis 26.10.2026). |
| SYS-068 Deckel Zielplatinen-Versorgungsschalter, Druck | 1 Stück | 95 x 75 x 6 / 24.043 cm³ | 3D-Druck intern, Geometrie aus Solid Edge target_power_switch_top.par; ../hardware/cad; PETG | target_power_switch_top, 95×75×6 mm (Entscheidung Luis 26.10.2026). |
| SYS-069 Gehäuse Kleinnetzteil, Druck | 1 Stück | 80 x 50 x 25 / 26.362 cm³ | 3D-Druck intern, Geometrie aus Solid Edge base_power_supply_housing.par; ../hardware/cad; PETG | base_power_supply_housing, 80×50×25 mm (Entscheidung Luis 26.10.2026). Inhalt bei SCHUTZWERK anfragen. |
| SYS-070 Deckel Kleinnetzteil, Druck | 1 Stück | 50 x 50 x 2.5 / 6.008 cm³ | 3D-Druck intern, Geometrie aus Solid Edge base_power_supply_housing_top.par; ../hardware/cad; PETG | base_power_supply_housing_top, 50×50×2,5 mm (Entscheidung Luis 26.10.2026). |
| SYS-071 Raspberry-Pi-4-Halter, Druck | 1 Stück | 97 x 72 x 5 / 34.47 cm³ | 3D-Druck intern, Geometrie aus Solid Edge base_raspberry_pi_4_adapter.par; ../hardware/cad; PETG | base_raspberry_pi_4_adapter, 97×72×5 mm, in base.asm referenziert (Entscheidung Luis 26.10.2026). Ob ein Raspberry Pi 4 verbaut wird, bei SCHUTZWERK anfragen. |
| SYS-072 Halter Höhennivellier-Taster (Hilfsmittel), Druck | 1 Stück | 45 x 20 x 32 / 12.145 cm³ | 3D-Druck intern, Geometrie aus Solid Edge utils_height_leveling_probe_holder.par; ../hardware/cad; PETG | utils_height_leveling_probe_holder, 45×20×32 mm (Entscheidung Luis 26.10.2026). |

## Blech intern

Die Basis-Motorplatten und Schlitten-Seitenteile sind durch Blog/Thesis als Laserteile belegt; andere Verfahren/Materialien bleiben Vorschläge. Für Basisplatten Stahl, z.B.S235, vorschlagen; Sorte und Beschichtung sind nicht belegt. Abdeckungen können andere Werkstoffe erfordern. Dicke bei CAD-003 geometrisch 3 mm, CAD-007/008/096/097/099/100 geometrisch 5 mm. Motorhalteplatten CAD-096/097 und Seitenplatten CAD-099/100 werden selbst gefräst (Luis 26.10.2026). CAD-024 ist 3 mm dick; Kettenhalter und Trigger benötigen eine gesonderte Dicken-/Biegeprüfung.

Für jede Variante: Flachkontur/DXF, Lochliste, Gewinde/Senkungen, Biegeradien/-winkel, Bezugsflächen, Entgratung und Korrosionsschutz festlegen. Die beiden 5 mm-Motorplatten und 8Seitenteile belegen zusammen mindestens 0,22176m² rechteckige Hüllfläche; die beiden Seitendeckel und Topdeckel weitere 0,41830m².3 mm-Rückwand 0,17550m², vier Kabeldeckel 0,005104m². Das sind Flächen ohne Verschachtelung, Schnittfugen, weitere Bleche oder Biegeabwicklungen. Der 200 EUR-Materialansatz ist eine eigene Schätzung, keine Zuschnittbestellung.

| ID / Teil | Planmenge | CAD-Hülle mm / Volumen je Teil | Verfahren / Werkstoffbeleg | Offen |
| --- | --- | --- | --- | --- |
| CAD-003 Grundgestell: Rückseite Platte | 1 Stück | 650.0 x 3.0 x 270.0 / 519.940673 cm³ | WERKSTATT: eigene Fertigung aus Blech oder Aluminium (Entscheidung Luis 17.10.2026); Aluminium 3 mm (Entscheidung 17.10.2026), z. B. EN AW-5754 | 650×270×3 mm, 54 Bohrungen Ø3,4, 10 Bohrungen Ø4,5, 1 Bohrung Ø8. 6 Ø4,5-Bohrungen sitzen auf den langen Profilen (M4 + Nutenstein, siehe M01). Zuschnitt und Bohrungen intern; Zeichnung aus CAD ableiten. |
| CAD-096 X-Achse Motor Platte | 1 Stück | 550.0 x 5.0 x 135.0 / 335.704102 cm³ | WERKSTATT: selbst gefräst (Luis 26.10.2026); Rohteil-Modell *_raw in hardware/cad/mechanical_parts; Original lasergeschnitten (Blog); Stahl- oder Aluminiumplatte 5 mm, Werkstattentscheidung | 5 mm Stahl, 550×135 mm. Fusion-Messung: 16 Kernlöcher Ø2,46 für M3-Gewinde (Riemenspanner), Senkungen für M6 und Ø22-Durchbrüche für die Motoren. Kontur und Bohrungen aus CAD; Gewinde und Senkungen intern. Zeichnung mit Lagetoleranzen der Führungsbohrungen fehlt. |
| CAD-097 X-Achse Motor Platte 2 | 1 Stück | 550.0 x 5.0 x 135.0 / 335.571042 cm³ | WERKSTATT: selbst gefräst (Luis 26.10.2026); Rohteil-Modell *_raw in hardware/cad/mechanical_parts; Original lasergeschnitten (Blog); Stahl- oder Aluminiumplatte 5 mm, Werkstattentscheidung | 5 mm Stahl, 550×135 mm. Fusion-Messung: 16 Kernlöcher Ø2,46 für M3-Gewinde (Riemenspanner), Senkungen für M6 und Ø22-Durchbrüche für die Motoren. Kontur und Bohrungen aus CAD; Gewinde und Senkungen intern. Zeichnung mit Lagetoleranzen der Führungsbohrungen fehlt. |
| CAD-099 X-Achse Seite Platte | 4 Stück | 55.0 x 5.0 x 166.5 / 40.662747 cm³ | WERKSTATT: selbst gefräst (Luis 26.10.2026); Rohteil-Modell *_raw in hardware/cad/mechanical_parts; Stahl- oder Aluminiumplatte 5 mm, Werkstattentscheidung | 5 mm Seitenplatte des X-Wagens 55×166,5 mm. Fräszeichnung aus hardware/cad (.par/.dft) ableiten. |
| CAD-100 X-Achse Seite Platte beweglich | 4 Stück | 55.0 x 5.0 x 166.5 / 41.473401 cm³ | WERKSTATT: selbst gefräst (Luis 26.10.2026); Rohteil-Modell *_raw in hardware/cad/mechanical_parts; Stahl- oder Aluminiumplatte 5 mm, Werkstattentscheidung | 5 mm Seitenplatte des X-Wagens 55×166,5 mm. Fräszeichnung aus hardware/cad (.par/.dft) ableiten. |

## CNC extern

Vier Varianten, je 2 Stück =8Adapterplatten. CNC-Fräsen aus ENAW-6082T6,10 mm-Ausgangsdicke ist ein Vorschlag. Prüfen, ob Lasern/Wasserstrahl plus Nacharbeit technisch genügt; dadurch kann sich der Preis ändern.

Angebotspaket: separate STEP-Datei jeCAD-ID,2D-PDF mit Datumsstand/Revision, Material, Rohmaß inklusive Aufmaß, Loch-/Gewindetabelle, Bezugsflächen, Funktionspassungen, Ebenheit/Parallelität und Oberfläche. ISO2768-m allenfalls als zu bestätigender Allgemeintoleranzvorschlag, keine pauschale Freigabe kritischer Führungssitze. Kanten entgraten.8Teile getrennt ausweisen, Prüfmaße dokumentieren, Fertigung inDE/EU verlangen. [Xometry](https://xometry.eu/de/faq/) ist ein möglicher Anbieter; noch kein Angebot angefragt. Budget100EUR netto jeTeil inklusiveRohmaterial, ohneTransport.

| ID / Teil | Planmenge | CAD-Hülle mm / Volumen je Teil | Verfahren / Werkstoffbeleg | Offen |
| --- | --- | --- | --- | --- |

## Weitere Fertigung

**Profile:** CAD-011/012/013/020:30×30,2×564+3×590+12×350 =7098 mm netto. CAD-014:60×30,2×650 =1300 mm. Nut 6/I-Typ ist ein Kandidat; Nutgeometrie/Winkel/Nutensteine gegen CAD prüfen. Rohmaterialansatz 8 m bzw.1,4 m enthält Reserve, garantiert aber bei noch unbekannten Lieferstangen keinen optimierten Schnittplan. Schnittfuge, Rechtwinkligkeit, Stirngewinde und zusätzliche Bohrungen separat angeben.

**Wellen:** CAD-098:8×Ø10×450 und CAD-069:2×Ø10×356,8 =4313,6 mm netto. CF53h 6 als Vorschlag, gehärtet/geschliffen nur passend zur gewählten Buchse. Enden entgraten; Längentoleranzen festlegen.5 m Budgetmaterial. CAD-103:4×40×16×436 mm Profilhülle; Hohlquerschnitt/Material noch identifizieren. CAD-070:2×11,5×11,5×205 mm, CAD-108:8×Ø4×70 mm, CAD-093/094: je 4Triggerstäbe Ø8×125/75 mm. CAD-109:4Distanzteile, Name 2 mm gegen geometrisch 3 mm auflösen.

**Kalibrierung:** Messingzylinder drehen/ablängen und Stirnflächen vermessen. Der aktuelle Reference Board-Code unterscheidet vier innere ZylinderØ7/8/9/10, vier erhöhteØ7 (Höhenniveaus 6/8/10/12 mm) und vier äußereØ7 auf Grundniveau; zusätzlich vier weiße Referenzen. Siehe SYS-005/037/039/040. Durchmesser 7 mm deräußeren Gruppen kommen aus der Code-Skizze, nicht aus einer Fertigungszeichnung. Thesis und späterer Softwarestand sind verschiedene Versionen. `inner_brass_pin_width=11.95`, `height=19.95` sowie `raised_brass_pin_width=59.6`, `height=39.9` sind Raster-/Abstandswerte, keine Zylinderdurchmesser. Äußere Messingpins liegenauf den Achsen, weiße Pins an den Ecken des Rasters 109,9×89,8 mm. Marker 18,2×18,2 und Marker-Raster 60×80 mm, Hamming-IDs 1/3/6/12. Gesamtlänge/Einstecktiefe ist nicht Endflächenhöhe. Tatsächliche Geometrie vermessen und in Software hinterlegen; keine vollständige Fertigungszeichnung allein aus den Parametern behaupten.

| ID / Teil | Planmenge | CAD-Hülle mm / Volumen je Teil | Verfahren / Werkstoffbeleg | Offen |
| --- | --- | --- | --- | --- |
| CAD-009 Grundgestell: Schlepp Energiekette Halter | 4 Stück | 80.0 x 650.0 x 16.0 / 606.011318 cm³ | Zuschnitt/Nachbearbeitung vorgeschlagen; Aluminium, DOLD I-Typ Nut 8 | Fusion-Messung: Alu-Flachprofil 16×80×650 mm (932 mm², 2 Kerne Ø5) mit 18 M3-Gewinden. Kandidat DOLD 80x 16S I-Typ Nut 8 (60886-Z), gleiche Serie wie CAD-103, aber 813 mm² und laut Produktseite M8-Kern. Kerngröße an der DOLD-Zeichnung prüfen; M3-Gewinde in der Werkstatt. |
| CAD-011 Grundgestell: Schublade lang Seite | 2 Stück | 30.0 x 564.0 x 30.0 / 313.869744 cm³ | Zuschnitt/Nachbearbeitung vorgeschlagen; je Teil vorgeschlagen, siehe Fertigung.md | Querschnitt und Länge aus CAD; Profilserie, Toleranzen, Endbearbeitung/Bohrungen festlegen. |
| CAD-012 Grundgestell: Rahmen lang Seite | 3 Stück | 30.0 x 590.0 x 30.0 / 328.338917 cm³ | Zuschnitt/Nachbearbeitung vorgeschlagen; je Teil vorgeschlagen, siehe Fertigung.md | Querschnitt und Länge aus CAD; Profilserie, Toleranzen, Endbearbeitung/Bohrungen festlegen. |
| CAD-013 Grundgestell: Rahmen kurz | 8 Stück | 30.0 x 350.0 x 30.0 / 194.777323 cm³ | Zuschnitt/Nachbearbeitung vorgeschlagen; je Teil vorgeschlagen, siehe Fertigung.md | Querschnitt und Länge aus CAD; Profilserie, Toleranzen, Endbearbeitung/Bohrungen festlegen. |
| CAD-014 Grundgestell: Rahmen Seite | 2 Stück | 30.0 x 650.0 x 60.0 / 790.966595 cm³ | Zuschnitt/Nachbearbeitung vorgeschlagen; je Teil vorgeschlagen, siehe Fertigung.md | Querschnitt und Länge aus CAD (2×650 mm). Beide Stirnseiten je 2× M6-Gewinde in die Kernbohrungen Ø5 (15/45 mm) für die Senkschrauben M6×20 der Motorplatten, ≥ 16 mm tief, intern schneiden (Entscheidung Luis 18.10.2026). |
| CAD-020 Grundgestell: vertikal | 4 Stück | 30.0 x 350.0 x 30.0 / 194.777323 cm³ | Zuschnitt/Nachbearbeitung vorgeschlagen; je Teil vorgeschlagen, siehe Fertigung.md | Querschnitt und Länge aus CAD (4×350 mm). Unten M6-Gewinde in die Kernbohrung Ø5 für die Gelenkfüße, intern schneiden (Entscheidung 17.10.2026). Profilserie siehe M01. |
| CAD-069 Platine Halter Führung rund | 2 Stück | 10.0 x 356.8 x 10.0 / 28.023006 cm³ | Zuschnitt/Nachbearbeitung vorgeschlagen; je Teil vorgeschlagen, siehe Fertigung.md | Querschnitt und Länge aus CAD; Profilserie, Toleranzen, Endbearbeitung/Bohrungen festlegen. |
| CAD-070 Platine Halter rechteckig Stange | 2 Stück | 11.5 x 205.0 x 11.5 / 12.3 cm³ | Zuschnitt/Nachbearbeitung vorgeschlagen; Aluminium-Vierkantrohr 12×12×1 (Al Mg Si 0,5) | ABWEICHUNG (Entscheidung Luis 17.10.2026): CAD-Vierkantrohr 11,5×11,5×1,5×205 mm (Fusion-Messung) wird durch Alu-Vierkantrohr 12×12×1 mm ersetzt (keine Last; 12×12×1,5 in DE/EU nicht gefunden); gedruckte Schieber CAD-067 auf 12 mm anpassen. Bezugsquelle z. B. e Bay metalexpres (Al Mg Si 0,5, ab 500 mm), Preis und Lager noch prüfen. |
| CAD-093 X-Achse Endschalter oben lang | 4 Stück | 125.0 x 8.0 x 8.0 / 6.277164 cm³ | Zuschnitt/Nachbearbeitung vorgeschlagen; Stahl Ø8 h 6, magnetisch (Cf 53), kein Edelstahl A2 | Halterplatte der Übersichtskamera, 104×56,6×5 mm, 4 Bohrungen Ø5,5. Zeichnung aus CAD ableiten. |
| CAD-094 X-Achse Endschalter oben kurz | 4 Stück | 75.0 x 8.0 x 8.0 / 3.76389 cm³ | Zuschnitt/Nachbearbeitung vorgeschlagen; Stahl Ø8 h 6, magnetisch (Cf 53), kein Edelstahl A2 | Halterplatte der Übersichtskamera, 104×56,6×5 mm, 4 Bohrungen Ø5,5. Zeichnung aus CAD ableiten. |
| CAD-098 X-Achse rund Schiene | 8 Stück | 10.0 x 450.0 x 10.0 / 35.335325 cm³ | Zuschnitt/Nachbearbeitung vorgeschlagen; je Teil vorgeschlagen, siehe Fertigung.md | Querschnitt und Länge aus CAD; Profilserie, Toleranzen, Endbearbeitung/Bohrungen festlegen. |
| CAD-103 X-Achse Schlitten Versteifung Träger | 4 Stück | 40.0 x 436.0 x 16.0 / 194.501744 cm³ | Zuschnitt/Nachbearbeitung vorgeschlagen; Aluminium, DOLD 40x 16S I-Typ Nut 8 | DOLD 40x 16S I-Typ Nut 8 schwer (60879-Z) im Zuschnitt: 1,178 kg/m ≈ 436 mm² (CAD 446 mm²), Kern Ø5 für M6 = CAD. M6-Gewinde in die Stirnseiten selbst schneiden. |
| CAD-108 Y-Achse Schlitten Abstand Stange | 8 Stück | 4.0 x 70.0 x 4.0 / 0.876766 cm³ | WERKSTATT: Ablängen und Anfasen; Silberstahl 1.2210 Ø4 h 6 | Fusion-Messung: massiver Rundstab Ø4×70 mm, Fasen an beiden Enden, ohne Gewinde. Werkstatt: aus Ø4-h 6-Silberstahl (1.2210) ablängen und anfasen (Entscheidung Luis 17.10.2026). |
| SYS-005 Innere Messing-Referenzzylinder Ø7/8/9/10 | 4 Stück | offen / offen | Planungsbedarf; ../software/hardware-control/proboter/tasks/utils/reference_board.py; nicht belegt | WERKSTATT aus Messing-Rundstab (Entscheidung Luis 18.10.2026): je 1× Ø7/8/9/10 mm, Raster 11,95×19,95 mm, Endfläche bündig mit der Plattenoberfläche. Länge = Plattendicke 5,1 mm plus Einpresstiefe. |
| SYS-039 Erhöhte Messing-Referenzzylinder | 4 Stück | offen / offen | Planungsbedarf; ../software/hardware-control/proboter/tasks/utils/reference_board.py; nicht belegt | WERKSTATT aus Messing-Rundstab Ø7 (Entscheidung Luis 18.10.2026): Raster 59,6×39,9 mm, Endflächen 6/8/10/12 mm über der Plattenoberfläche, in Türmen der Platte. |
| SYS-040 Äußere flache Messing-Referenzzylinder Ø7 | 4 Stück | offen / offen | Planungsbedarf; ../software/hardware-control/proboter/tasks/utils/reference_board.py; nicht belegt | WERKSTATT aus Messing-Rundstab Ø7 (Entscheidung Luis 18.10.2026): Mittelpunkte (±54,95; 0) und (0; ±44,9) mm, bündig. |

## PCB extern

**Signal-Multiplexer:** SCHUTZWERK-Ki Cad-Projekt mit Gerber liegt in `hardware/signal-multiplexer` (Bestellstand gerber 1.1, Fertigung bei JLCPCB). **Für die übrigen Platinen keine Gerber/Schaltpläne gefunden.** STEP enthält äußere Plattenkörper, keine Leiterbahnen. Betroffen: vier Prüfspitzen-PCBs, eventuell 24 Kanäle Sensorinterface und der in Software konfigurierte Zielversorgungscontroller. Platinen und Bestückung sind eigene Zeilen; CAD-082 als Dummy wirdnichtnochmals bestellt. CAD-Stecker/Federkontakte nicht nochmals in PCBA-Budget aufnehmen.

[BetaLAYOUT](https://de.beta-layout.com/leiterplatten/) als deutscherFertiger. VorAngebot nötig: geprüfterSchaltplan, Gerber/Bohrdaten oder nativesPCB-Projekt, Lagenaufbau/Kupfer/Dicke, Bestückungs-BOM mitMPNs, Positionsdatei/CPL, Polungen, Panel-/Mengenangaben, E-Test undFunktionsprüfvorschrift. FR4/1,6mm ist nur einVorschlag (Prüfspitzen-Dicke geometrisch1,6mm); Lagenzahl/Kupferstärke fehlen. BareBoards, Stencil, Bauteile, Rüstkosten undBestückung getrennt anbietenlassen. KeineDevelopmentkosten oderPCBA-Preise erfunden.

| ID / Teil | Planmenge | CAD-Hülle mm / Volumen je Teil | Verfahren / Werkstoffbeleg | Offen |
| --- | --- | --- | --- | --- |
| CAD-075 Prüfspitzen-PCB, unbestückt | 4 Stück | 26.67 x 10.96 x 1.6 / 0.272651 cm³ | PCB erforderlich; Fertigungsdaten fehlen; FR4 1,6 mm vorgeschlagen; Dicke geometrisch belegt | 4 Stück; CAD nur Quader 26,67×10,96×1,6 mm ohne Daten. Entscheidung Luis 17.10.2026: Originaldaten bei SCHUTZWERK angefragt (Anfrage durch Luis versendet, Antwort offen). |
| SYS-003 Signal-Multiplexer, unbestückte Leiterplatte | 1 Stück | offen / offen | Planungsbedarf; ../hardware/signal-multiplexer/hardware/mux.kicad_pcb; nicht belegt | SCHUTZWERK-Original: 4 Lagen, Gerber hardware/signal-multiplexer/hardware/gerber 1.1/gerber 1.1.zip (deckungsgleich mit mux.kicad_pcb, geprüft 26.10.2026). Bei JLCPCB bestellen. |
| SYS-019 Sensor-Pegelanpassung / Eingangsschutz | 24 Kanäle | offen / offen | Planungsbedarf; ../firmware/Marlin/Configuration.h; nicht belegt | Bedarf abhängig von M8-Ausgang; 24 V/3,3 V-Interface. Keine Schaltung/BOM vorhan den; nicht blind 24Module bestellen. |
| SYS-023 Signal-Multiplexer Bestückung | 1 Baugruppe | offen / offen | Planungsbedarf; ../hardware/signal-multiplexer/hardware/mux.csv; nicht belegt | Board-BOM hardware/signal-multiplexer/hardware/mux.csv (76 Bauteile, u. a. 6 Relais TE 6-1462037-3, SMA, USB-B, DB9). Bestückung bei JLCPCB oder selbst; MPNs/LCSC-Nummern noch zuordnen. |
| SYS-024 Prüfspitzen-PCB Bestückung | 4 Baugruppen | offen / offen | Planungsbedarf; evidence/cad-geometry.csv; nicht belegt | CAD-MM CX/Federkontakte separat; zusätzliche Buchsen und Bauteile erst aus Schaltplan. Unbestückte Platine CAD-075 nicht erneut zählen. |
| SYS-026 Zielplatinen-Versorgungscontroller | 1 Baugruppe | offen / offen | Planungsbedarf; ../software/hardware-control/proboter/cli.py; nicht belegt | Softwareziel /dev/proboter_target-power-controller; Schaltung, Firmware/Hardware und Kabel fehlen. Separat vom RSP-Netzteil. |
