floronics/ProBoter/bom/Kosten.md

# Kosten und Kalkulationsgrenzen

**Preisstand 16.10.2026; EUR. Ein PROBoter mit vier Prüfeinheiten.**
Öffentliche Seiten bzw. Suchindexanzeigen sind Preisbeobachtungen, keine bindenden
Angebote. Bestand und Preis können gegenüber dem Index geändert sein. Vor einer
Bestellung den Artikel, die Mengenstaffel, die Rechnungsfreigabe und das Lieferdatum
im Shop bestätigen. Kein Warenkorb wurde bestellt.

## Drei getrennte Ergebnisse

| Umfang | netto | brutto |
| --- | --- | --- |
| 1. Beobachtete Webpreise × geplante Bestellpackungen | 3.153,78 € | 3.753,10 € |
| Davon Positionen mit Status bestellfähig | 2.861,71 € | 3.405,54 € |
| Davon übrige Material-/Kandidatenpreise mit offenen Prüfungen | 292,07 € | 347,56 € |
| Eigene Budgetschätzungen zusätzlich | 826,09 € | 983,03 € |
| 2. Vorläufiger Gesamtbedarf des bezifferten Umfangs | 3.979,87 € | 4.736,13 € |
| 3. Noch unbezifferte Positionen: 20 | nicht berechenbar | nicht berechenbar |

**Der Gesamtpreis eines funktionierenden Nachbaus bleibt offen.** Die Summe unter 2
deckt nur bezifferte Positionen ab. Entwicklung von Elektronik/Firmware, interne
Arbeitszeit, Maschinenkosten, Host-PC, Messgeräte und Werkzeuge sind ausgeschlossen.
Einzelne Budgetansätze können nach Konstruktion stark abweichen; sie sind weder
Preisobergrenzen noch Angebote. Es wurde kein pauschaler Gewinn-/Risikozuschlag aufgeschlagen.

## Rechenregeln

- Steuerbasis:19% deutsche Umsatzsteuer als Planannahme für die Lieferung nach DE.
  Keine Vorsteuerabzugsberechtigung oder innergemeinschaftliche Steuerbefreiung unterstellt.
  Bei einem EU-Lieferanten die tatsächliche Rechnungsbehandlung prüfen.
- Bruttopreise: Zeilenbrutto = Packungen × Packungspreis; netto = brutto/1,19.
  Nettopreise: Zeilennetto = Packungen × Packungspreis; brutto = netto×1,19.
  Auf Zeilenebene kaufmännisch auf Cent gerundet; Summen addieren diese Zeilen.
  Daher kann die Umrechnung der Gesamtsumme um wenige Cent abweichen.
- Packungen = aufgerundeter Bedarf/Packungsinhalt. Vier Treiber je Packung,
 10 m bei GT2-6 mm,5 m bei LED und 1 kg bei Filament sind dokumentiert.
  Normteil-Zehnerpackungen und Profil-Recheneinheiten sind **Planannahmen**,
  keine behaupteten Händler-Mindestmengen. Stückbedarf bleibt in Teileliste sichtbar.
- Internes Druckmaterial nach Vollvolumen und Zuschlag; Blech als eigener
  Budgettopf. CNC-Budget enthält Material bereits. Keine erneute Berechnung
  der einzelnen Druck-/Blechteile oder des CNC-Rohmaterials.
- Baugruppen nicht zusätzlich zu ihren Blattteilen kalkuliert.
  X/Y-Riemen teilen einen Kostenposten. Führungswagen und Schienen im Budget
  als abgestimmte Sätze. Multiplexer-Dummy ausgeschlossen; echte Platine und
  Bestückung getrennt und unbeziffert.
- Enthaltene optische Endstop-Kabel sowie Hub-Netzteil/-Kabel nicht doppelt
  kalkuliert.48M8-Sensormuttern zunächst offen, da möglicherweise Beipack.
  Kettenendstücke sind nur ein Budget, bis der Lieferumfang geklärt ist.
- Optionen/Vergleiche `ALT-*` und `OPT-*` sind aus Grundsummen ausgeschlossen.
  Ein Nachbauwagen ist keine bestätigte Alternative für eine Originalschiene.
- Fehlende Preise sind in CSV leere Zellen und in JSON/Code null/None, niemals 0.
  Nur RBS-Versand ist ausdrücklich 0, weil der geplante Sammelwarenkorb 99 EUR
  übersteigt. Die 150 EUR für sonstige Fracht sind eine eigene Budgetreserve.
  Rechnungsgebühr Schrauben.Expert zusätzlich 5 EUR brutto angenommen, Steuerbasis offen.

## Budget nach Lieferant

Nur die numerisch bezifferten Grundpositionen; darunter befinden sich Schätzungen.
Die bevorzugten Ansprechpartner für unbezifferte Zeilen stehen in der Bestellliste.

| Lieferant | Webpreise brutto | Schätzungen brutto | Summe beziffert brutto |
| --- | --- | --- | --- |
| AUTOMATION24 | 396,98 € | 0,00 € | 396,98 € |
| BEFFUCHS | 9,41 € | 5,95 € | 15,36 € |
| DAMEN | 370,09 € | 0,00 € | 370,09 € |
| DIGIKEY | 175,55 € | 0,00 € | 175,55 € |
| DOLD | 640,87 € | 335,00 € | 975,87 € |
| DOMOTICX | 3,60 € | 0,00 € | 3,60 € |
| EISEN2000 | 113,65 € | 0,00 € | 113,65 € |
| ELCO | 298,17 € | 0,00 € | 298,17 € |
| IGUS | 172,70 € | 0,00 € | 172,70 € |
| MOTEDIS | 314,66 € | 0,00 € | 314,66 € |
| NANOTEC | 445,54 € | 0,00 € | 445,54 € |
| OFFEN | 0,00 € | 150,00 € | 150,00 € |
| PLATTENZUSCHNITT24 | 0,00 € | 31,00 € | 31,00 € |
| RBS | 481,80 € | 30,00 € | 511,80 € |
| REICHELT | 138,99 € | 195,00 € | 333,99 € |
| SCHRAUBEN | 103,10 € | 29,00 € | 132,10 € |
| STEPPERONLINE | 0,00 € | 38,08 € | 38,08 € |
| TINYTRONICS | 30,00 € | 0,00 € | 30,00 € |
| TME | 0,00 € | 169,00 € | 169,00 € |
| VOELKNER | 57,99 € | 0,00 € | 57,99 € |

## Noch unbeziffert – Auswirkung auf die Vollständigkeit

| Bestellzeile | Benötigter Umfang | Warum Preis fehlt |
| --- | --- | --- |
| BUY-010 | Übersichtskamera ELP-USBFHD01M-H100 | OV2710, UVC/Linux, M12, Platine 38×38 auf 32×32 kürzbar. Lochraster 28×28 nicht schriftlich bestätigt. |
| OPEN-CAD-010 | Schubladen-Dummyplatte | Schubladen-Dummy 564×410×12 mm: unklar, ob reale Platte benötigt und welches Material. Nicht stillschweigend ausschließen oder aus Stahl fertigen. |
| OPEN-CAD-061 | MMCX-Stecker gerade mit RG316, offenes Ende | Fusion: MMCX-Stecker mit Kabel Ø2,5 = RG316. rf-connectors.pl liefert MMCX-Pigtails RG316 offen nur bis 30 cm; 1 m nur mit SMA-Gegenstecker (abschneiden) oder als Sonderanfertigung. Länge an Kette/Messgerät festlegen. |
| OPEN-CAD-062 | MMCX-Stecker gewinkelt mit RG316, offenes Ende | rf-connectors.pl PT_MMCX MLS030Q: gewinkelt, RG316, offen, 30 cm, 33,95 zł. Für 1–1,5 m Sonderlänge anfragen oder MMCX–SMA 1 m kürzen. |
| OPEN-CAD-073 | Aufnahmehülse R75 mit Drahtende (CAD: P75-2_W) | Fusion-Messung: Ø1,2 × 25,4 mm, Drahtende Ø0,6 × 5 mm = R75-Aufnahmehülse für P75 (Bohrung ca. 1,4 mm). Kein EU-Angebot mit Preis gefunden; Peaktest R75-Serie nur auf Anfrage. |
| OPEN-CAD-075 | Prüfspitzen-PCB, unbestückt | 4 Stück; CAD nur Quader 26,67×10,96×1,6 mm ohne Daten. Entscheidung Luis 17.10.2026: Originaldaten bei SCHUTZWERK angefragt (Anfrage durch Luis versendet, Antwort offen). |
| OPEN-SYS-003 | Signal-Multiplexer, unbestückte Leiterplatte | SCHUTZWERK-Original: 4 Lagen, Gerber hardware/signal-multiplexer/hardware/gerber 1.1/gerber 1.1.zip (deckungsgleich mit mux.kicad_pcb, geprüft 26.10.2026). Bei JLCPCB bestellen. |
| OPEN-SYS-005 | Innere Messing-Referenzzylinder Ø7/8/9/10 | WERKSTATT aus Messing-Rundstab (Entscheidung Luis 18.10.2026): je 1× Ø7/8/9/10 mm, Raster 11,95×19,95 mm, Endfläche bündig mit der Plattenoberfläche. Länge = Plattendicke 5,1 mm plus Einpresstiefe. |
| OPEN-SYS-009 | LED-Anschluss an den Heizbett-Ausgang der Licht-Steuerplatine | Configuration_adv.h:4396 setzt PROBOTER_LIGHT_CONTROL_PIN auf HEATER_BED_PIN; M376 steuert Helligkeit. Kein separater USB-LED-Controller nötig. Stecker/Leitungen, Strom und Flimmern prüfen; keine zusätzliche MOSFET-Platine pauschal kaufen. |
| OPEN-SYS-017 | Sensor-Gegenstecker und Kontakte | 24 induktiv+4 optisch; bei steckerfertigem Beipack reduzieren. Keine generischen JST/Dupont ohne Rasterprüfung. |
| OPEN-SYS-019 | Sensor-Pegelanpassung / Eingangsschutz | Bedarf abhängig von M8-Ausgang; 24 V/3,3 V-Interface. Keine Schaltung/BOM vorhan den; nicht blind 24Module bestellen. |
| OPEN-SYS-023 | Signal-Multiplexer Bestückung | Board-BOM hardware/signal-multiplexer/hardware/mux.csv (76 Bauteile, u. a. 6 Relais TE 6-1462037-3, SMA, USB-B, DB9). Bestückung bei JLCPCB oder selbst; MPNs/LCSC-Nummern noch zuordnen. |
| OPEN-SYS-024 | Prüfspitzen-PCB Bestückung | CAD-MM CX/Federkontakte separat; zusätzliche Buchsen und Bauteile erst aus Schaltplan. Unbestückte Platine CAD-075 nicht erneut zählen. |
| OPEN-SYS-026 | Zielplatinen-Versorgungscontroller | Softwareziel /dev/proboter_target-power-controller; Schaltung, Firmware/Hardware und Kabel fehlen. Separat vom RSP-Netzteil. |
| OPEN-SYS-038 | Kalibrier-Kontaktleitungen und gemeinsame Messreferenz | 4 SKR-Zentriereingänge P0_17 mit Pull-up/aktiv Low sowie Referenzkörper/Kontaktkreis verdrahten. Netzplan, Stecker, Länge und Bezugspotenzial mit Multiplexer klären; keine Verbindung ungeprüft festlegen. |
| OPEN-SYS-039 | Erhöhte Messing-Referenzzylinder | WERKSTATT aus Messing-Rundstab Ø7 (Entscheidung Luis 18.10.2026): Raster 59,6×39,9 mm, Endflächen 6/8/10/12 mm über der Plattenoberfläche, in Türmen der Platte. |
| OPEN-SYS-040 | Äußere flache Messing-Referenzzylinder Ø7 | WERKSTATT aus Messing-Rundstab Ø7 (Entscheidung Luis 18.10.2026): Mittelpunkte (±54,95; 0) und (0; ±44,9) mm, bündig. |
| OPEN-SYS-058 | Prüfstifte P75 Flachspitze zum Bestromen von Pads (Spitzenauswahl) | Wunsch Luis (17.10.2026). Flachspitzen-Code uneinheitlich (Peaktest: F flach, A konkav, D2 Kuppe); kein Lagerangebot gefunden, Spitzenzeichnung beim Händler anfordern. |
| OPEN-SYS-073 | Energiekette Schublade igus E2C.10.10.028.0, 0,5 m | drag_chain_0_5m_E2C_10_10_028_0 in drawer_drag_chain.asm: 2 Ketten je 25 Glieder (Fusion-Messung) mit Anschlüssen E2.100.10.56PZ.A1 (SYS-074) (Entscheidung Luis 26.10.2026). |
| OPEN-SYS-074 | Anschlusssatz igus E2.100.10.56PZ.A1, Schubladenkette | Anschlüsse zu SYS-073, laut CAD-Dateiname (Entscheidung Luis 26.10.2026). |

## Größte Kostenrisiken

Die fehlenden PCB-Entwürfe bestimmen Bestückung, Sensorinterface und Anschlussplan.
Ein Einkauf einzelner Platinenrohlinge löst diesen Entwicklungsbedarf nicht.
Originalmotoren und SKR1.3 können Beschaffungs- oder Umkonstruktionskosten verursachen.
Vier zusätzliche NEMA14 statt der Planmenge 4 würden imreinen Motorbudget weitere
238 EUR brutto erfordern; daraus folgt nochkein funktionierender Antriebsplan.
Kamerakandidaten können nach dem Optiktest entfallen oder einenanderen Halter benötigen.
Die historischen Projektkosten im Blog sind keine Preisgrundlage dieser Kalkulation.

Maschinenlesbar: [Bestell-CSV](bestellliste.csv), [Summen-JSON](kosten.json).
Rechenweg und Prüfung: [Reproduktion](Reproduktion.md).
