floronics/ProBoter/bom/Recherche-Stand.md

# Recherche-Zwischenstand

16.10.2026: [Fusion-Abgleich](CAD-Pruefung.md) erfasst alle120 STEP-Teilnamen.
Der [Lieferantenvergleich](Lieferanten.md) dokumentiert Rechnungskauf und Fracht.
[Angebotsdaten](data/offers.json) enthalten exakt benannte Shopartikel, Preisbasis,
Packungsgröße, Lieferstatus und die noch offenen Kompatibilitätsprüfungen.

Die Preisbeobachtungen stammen aus öffentlichen Produktseiten bzw. deren
Suchindex am Recherchedatum. Indexstände können älter sein. Es gibt keine
reservierten Bestände, verbindlichen Angebote oder individuelle Rabatte.
Ab-Preise konfigurierbarer Produkte werden nicht als fertige Zuschnittpreise
übernommen. Vergleichsartikel werden nicht zusätzlich zum Original eingerechnet.
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
