floronics/ProBoter/bom/zeichnungen/CAD-097-x_motor_plate_2.dxf

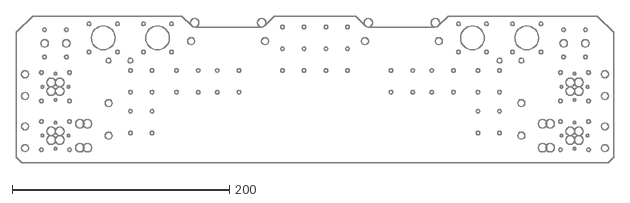
[picture p1: CAD file, 2026-10-17]
bom/zeichnungen/CAD-097-x_motor_plate_2.dxf
550.0 x 135.0
