floronics/ProBoter/hardware/3d_models/tooled_parts.step

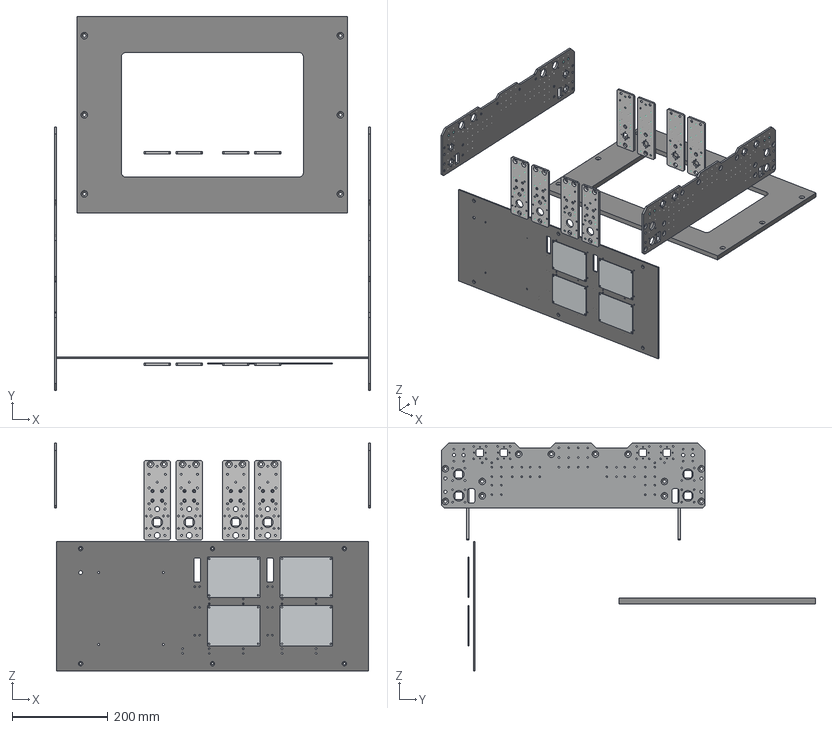
[picture p2: CAD file, 2026-10-27]
hardware/3d_models/tooled_parts.step
660.0 x 780.0 x 475.0 mm
