floronics/ProBoter/hardware/3d_models/tooled_parts/07_x_side_plate_x4.step

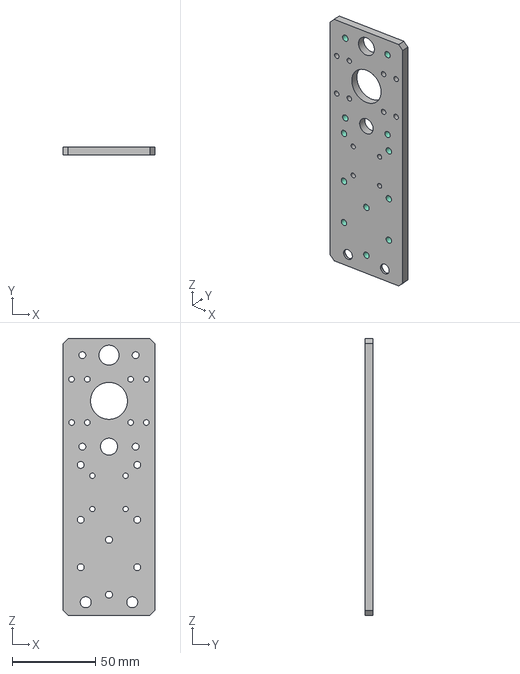
[picture p3: CAD file, 2026-10-27]
hardware/3d_models/tooled_parts/07_x_side_plate_x4.step
55.0 x 5.00 x 166.5 mm
