floronics/ProBoter/hardware/signal-multiplexer/hardware/relay/c-1462037-3-a-3d.stp

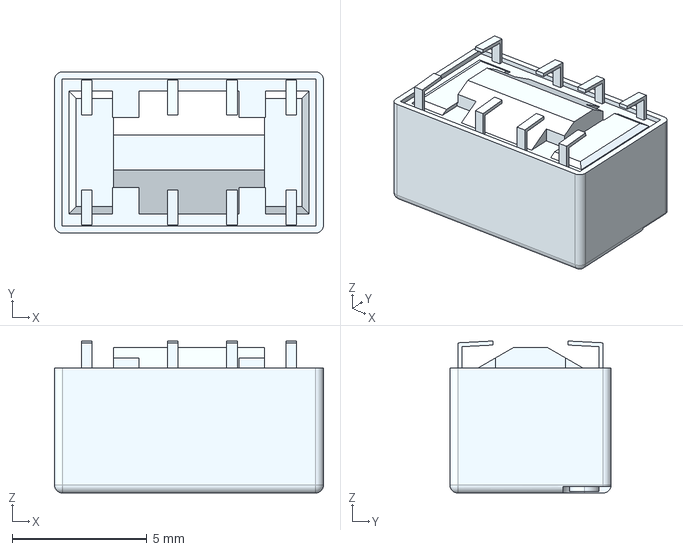
[picture p4: CAD file, 2026-10-26]
hardware/signal-multiplexer/hardware/relay/c-1462037-3-a-3d.stp
10.0 x 6.00 x 5.65 mm
