floronics/ProBoter/bom/zeichnungen/CAD-003-base_back_plate.dxf

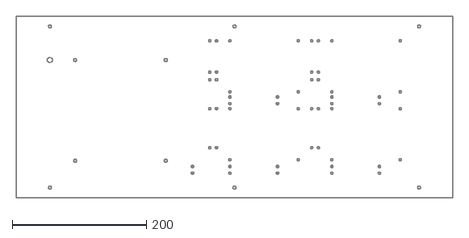
[picture p5: CAD file, 2026-10-17]
bom/zeichnungen/CAD-003-base_back_plate.dxf
650.0 x 270.0
