floronics/ProBoter/hardware/3d_models/tooled_parts/05_x_motor_plate_x1.step

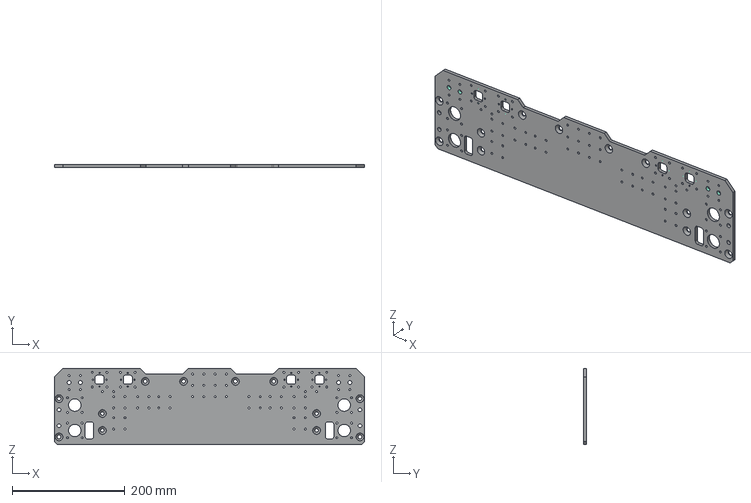
[picture p6: CAD file, 2026-10-27]
hardware/3d_models/tooled_parts/05_x_motor_plate_x1.step
550.0 x 5.00 x 135.0 mm
