floronics/ProBoter/bom/zeichnungen/CAD-096-x_motor_plate.dxf

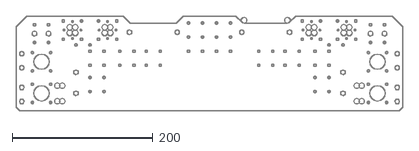
[picture p7: CAD file, 2026-10-17]
bom/zeichnungen/CAD-096-x_motor_plate.dxf
550.0 x 135.0
