floronics/ProBoter/hardware/3d_models/tooled_parts/04_base_drawer_dummy_plate_x1.step

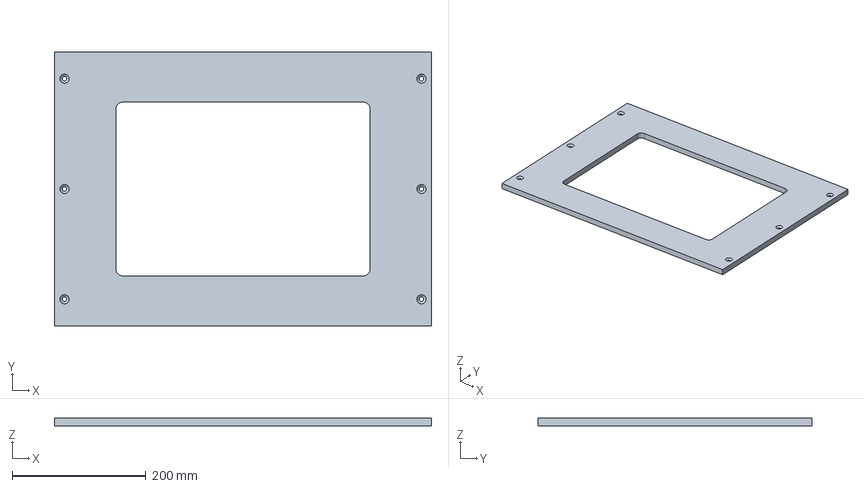
[picture p8: CAD file, 2026-10-27]
hardware/3d_models/tooled_parts/04_base_drawer_dummy_plate_x1.step
564.0 x 410.0 x 12.0 mm
