floronics/ProBoter/hardware/3d_models/tooled_parts/01_base_back_plate_x1.step

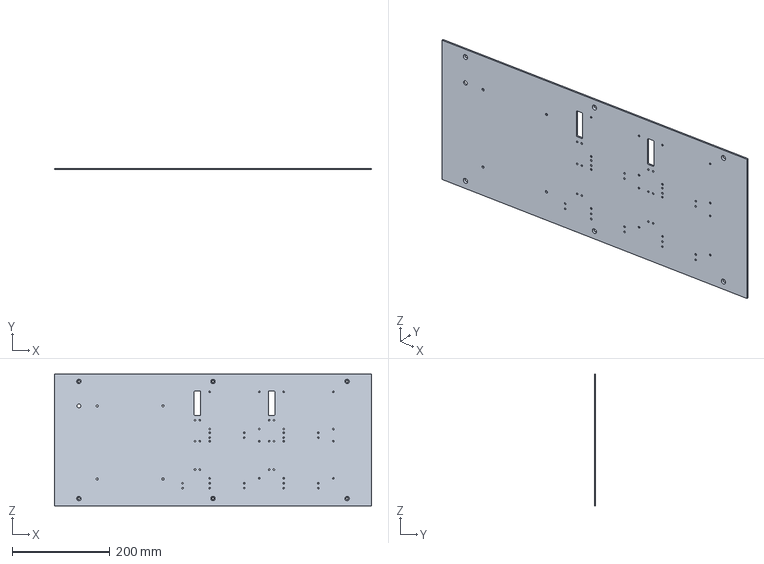
[picture p10: CAD file, 2026-10-27]
hardware/3d_models/tooled_parts/01_base_back_plate_x1.step
650.0 x 3.00 x 270.0 mm
