floronics/ProBoter/(list of files, cad)

Other CAD files:
hardware/3d_models/tooled_parts/03_base_cover_top_x2.step
hardware/3d_models/tooled_parts/02_base_cover_long_side_x2.step
hardware/3d_models/tooled_parts/08_x_side_plate_moving_x4.step
hardware/cad/printed_parts/base_drag_chain_holder.psm
