floronics/ProBoter/bom/zeichnungen/M01-Platten.pdf

# CAD-003 Rückwand

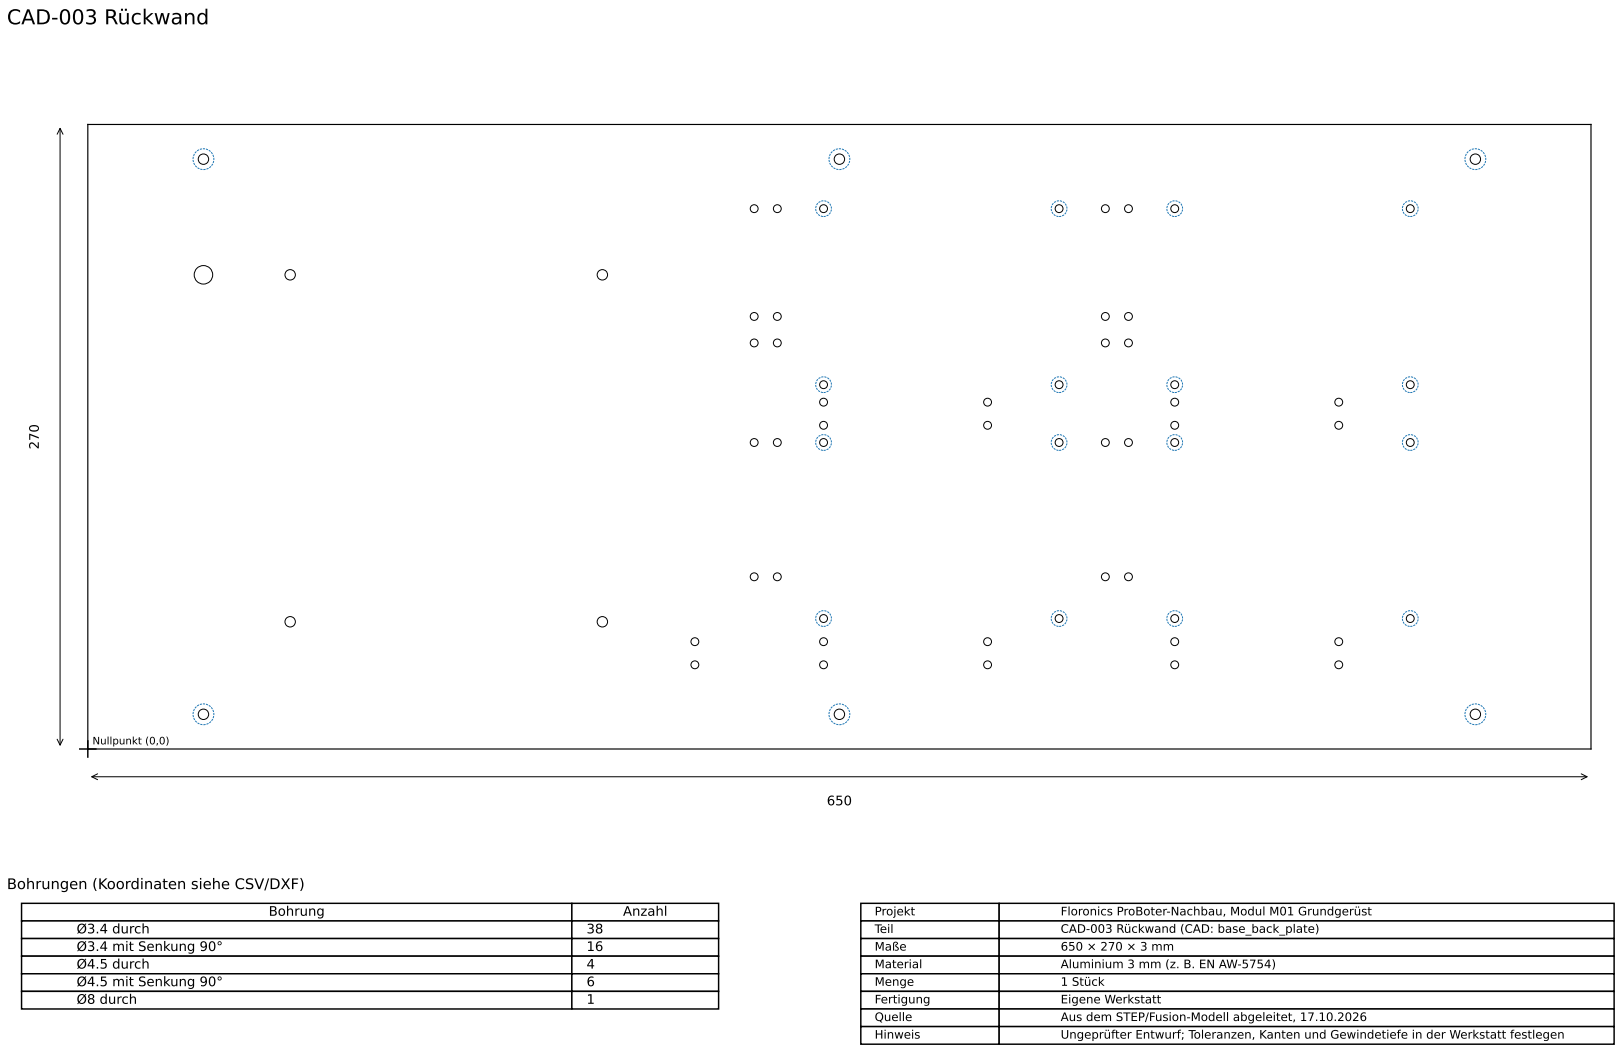
[picture p11: page 1]
Nullpunkt (0,0); Bohrung; Anzahl; Ø3.4 durch; Ø3.4 mit Senkung 90°; Ø4.5 durch; Ø4.5 mit Senkung 90°; Ø8 durch; Projekt; Floronics ProBoter-Nachbau, Modul M01 Grundgerüst; Teil; CAD-003 Rückwand (CAD: base_back_plate); Maße; Material; Aluminium 3 mm (z. B. EN AW-5754); Menge; 1 Stück; Fertigung; Eigene Werkstatt

Bohrungen (Koordinaten siehe CSV/DXF)

Quelle | Aus dem STEP/Fusion-Modell abgeleitet, 17.10.2026
Hinweis | Ungeprüfter Entwurf; Toleranzen, Kanten und Gewindetiefe in der Werkstatt festlegen

# CAD-096 Motorplatte 1

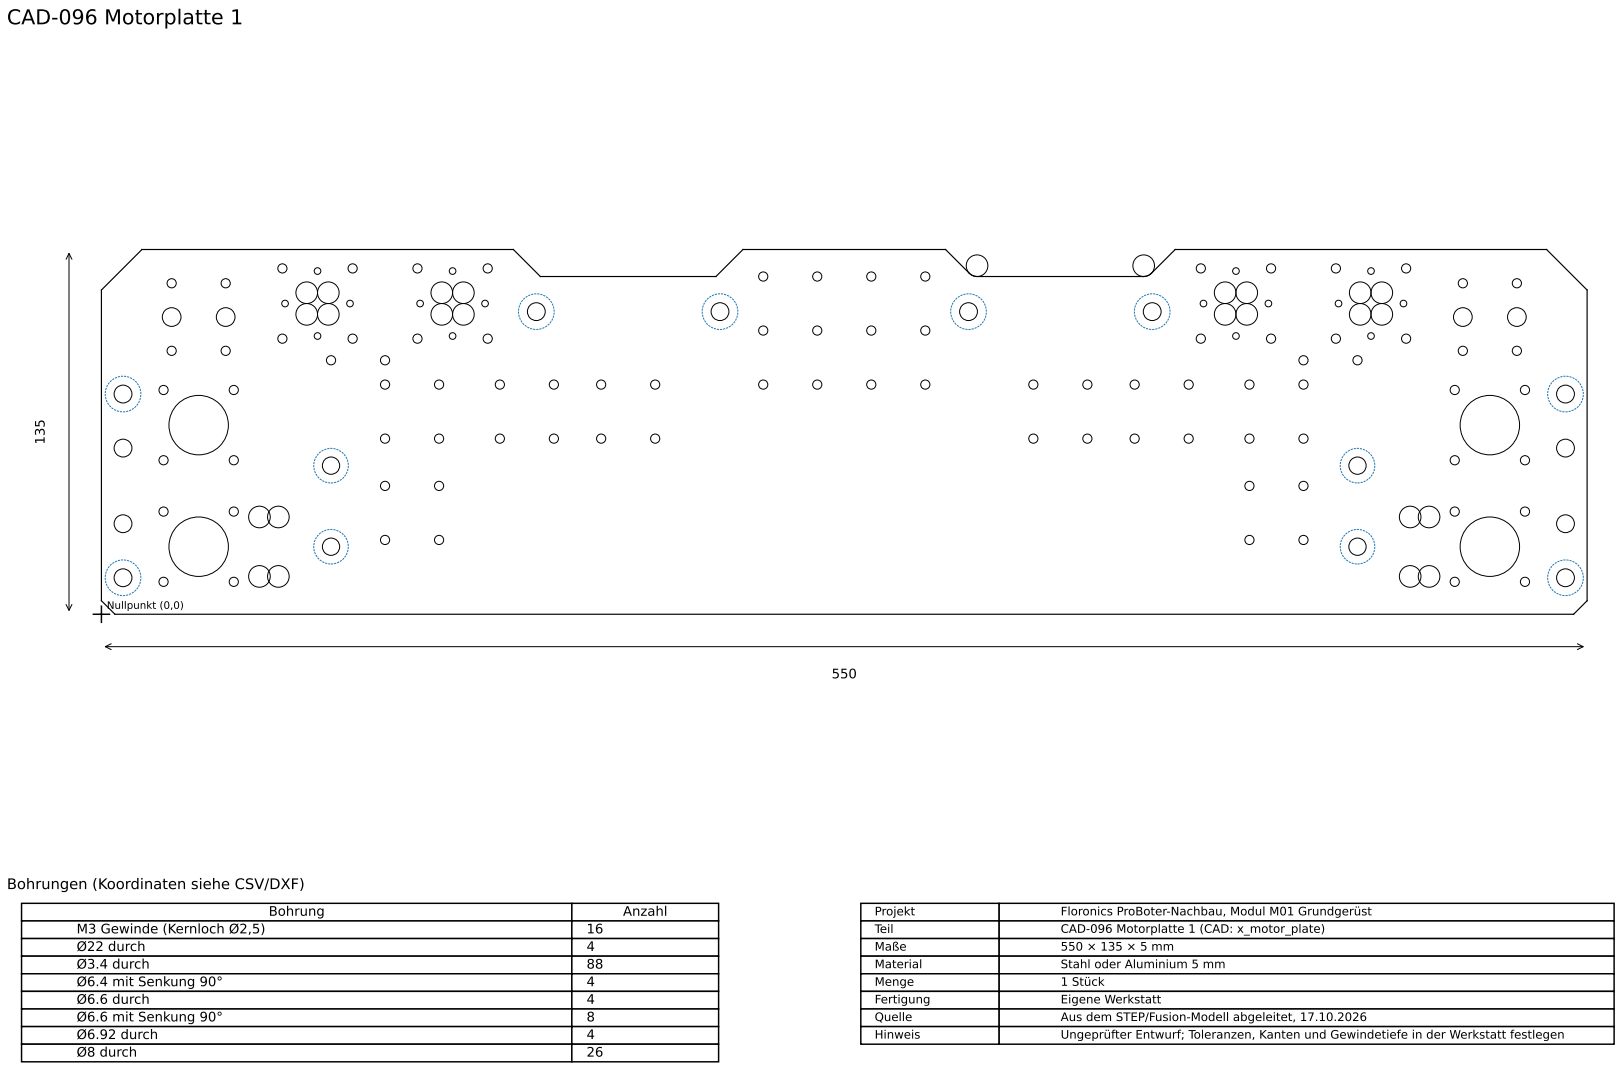
[picture p12: page 2]
Nullpunkt (0,0); Bohrung; Anzahl; M3 Gewinde (Kernloch Ø2,5); Ø22 durch; Ø3.4 durch; Ø6.4 mit Senkung 90°; Ø6.6 durch; Ø6.6 mit Senkung 90°; Ø6.92 durch; Ø8 durch; Projekt; Floronics ProBoter-Nachbau, Modul M01 Grundgerüst; Teil; CAD-096 Motorplatte 1 (CAD: x_motor_plate); Maße; Material; Stahl oder Aluminium 5 mm; Menge; 1 Stück; Fertigung; Eigene Werkstatt; Quelle; Aus dem STEP/Fusion-Modell abgeleitet, 17.10.2026; Hinweis; Ungeprüfter Entwurf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

Bohrungen (Koordinaten siehe CSV/DXF)

# CAD-097 Motorplatte 2

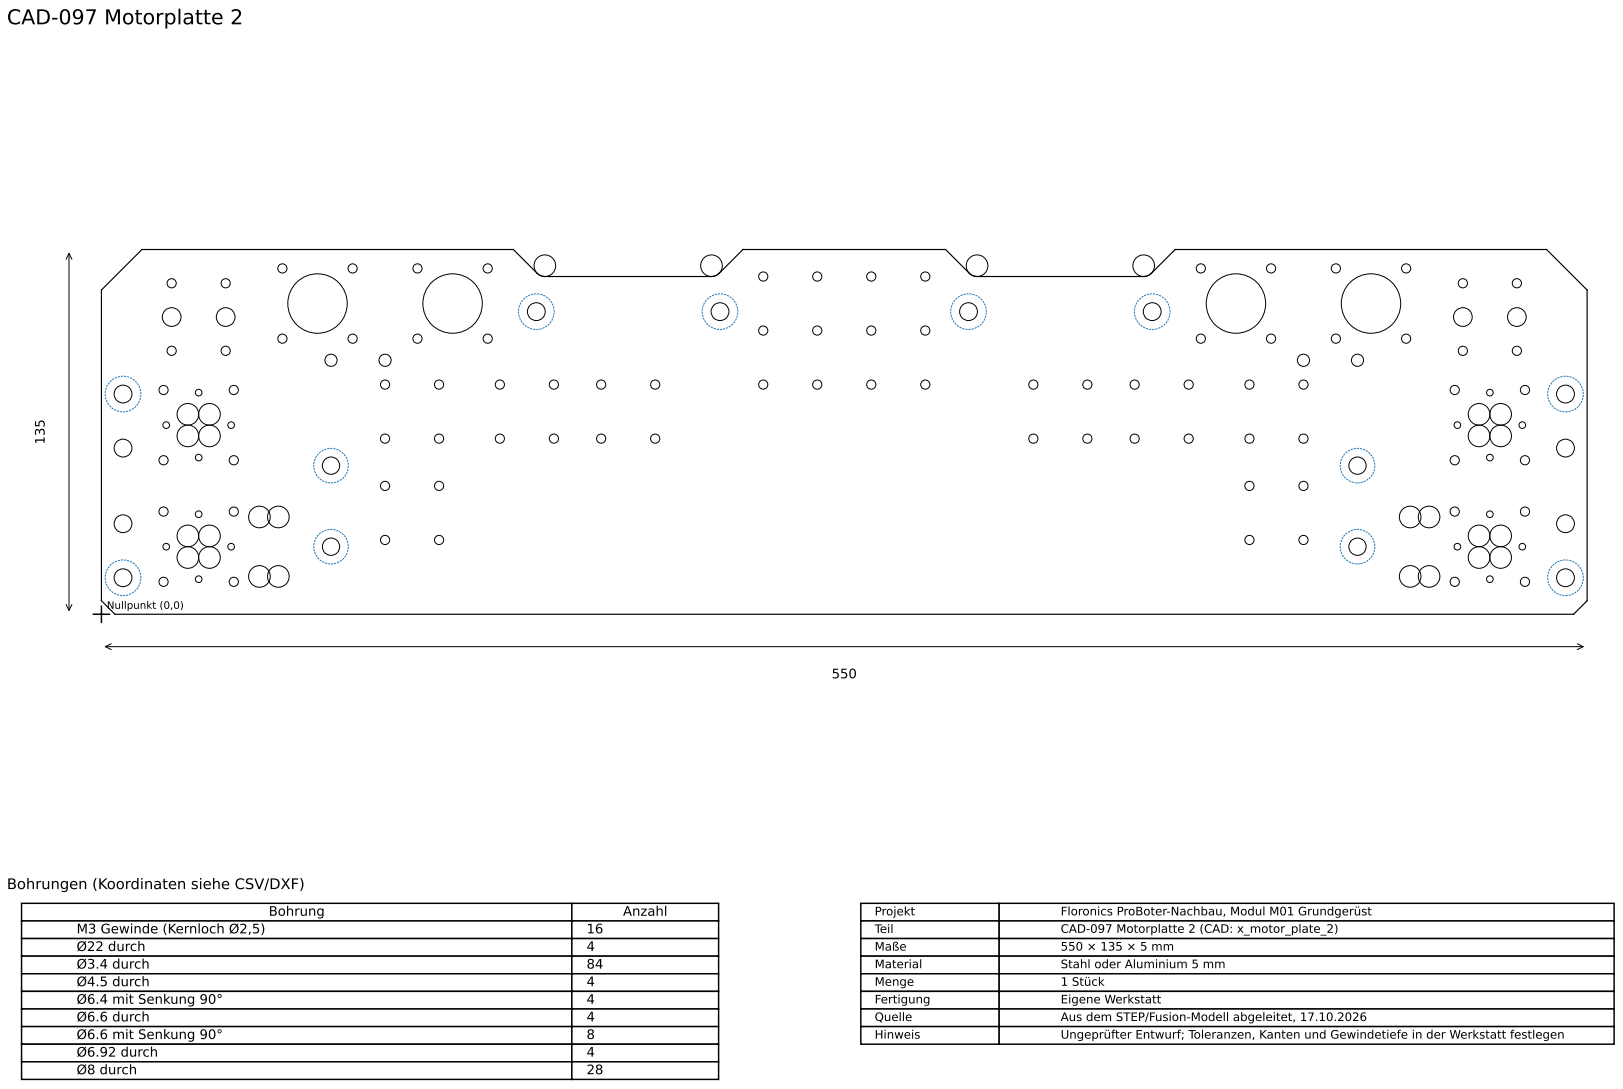
[picture p13: page 3]
Nullpunkt (0,0); Bohrung; Anzahl; M3 Gewinde (Kernloch Ø2,5); Ø22 durch; Ø3.4 durch; Ø4.5 durch; Ø6.4 mit Senkung 90°; Ø6.6 durch; Ø6.6 mit Senkung 90°; Projekt; Floronics ProBoter-Nachbau, Modul M01 Grundgerüst; Teil; CAD-097 Motorplatte 2 (CAD: x_motor_plate_2); Maße; Material; Stahl oder Aluminium 5 mm; Menge; 1 Stück; Fertigung; Eigene Werkstatt; Quelle; Aus dem STEP/Fusion-Modell abgeleitet, 17.10.2026; Hinweis; Ungeprüfter Entwurf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

Bohrungen (Koordinaten siehe CSV/DXF)

Ø6.92 durch | 4
Ø8 durch | 28
