floronics/ProBoter/hardware/signal-multiplexer/hardware/ENG_CD_1634506_C.pdf

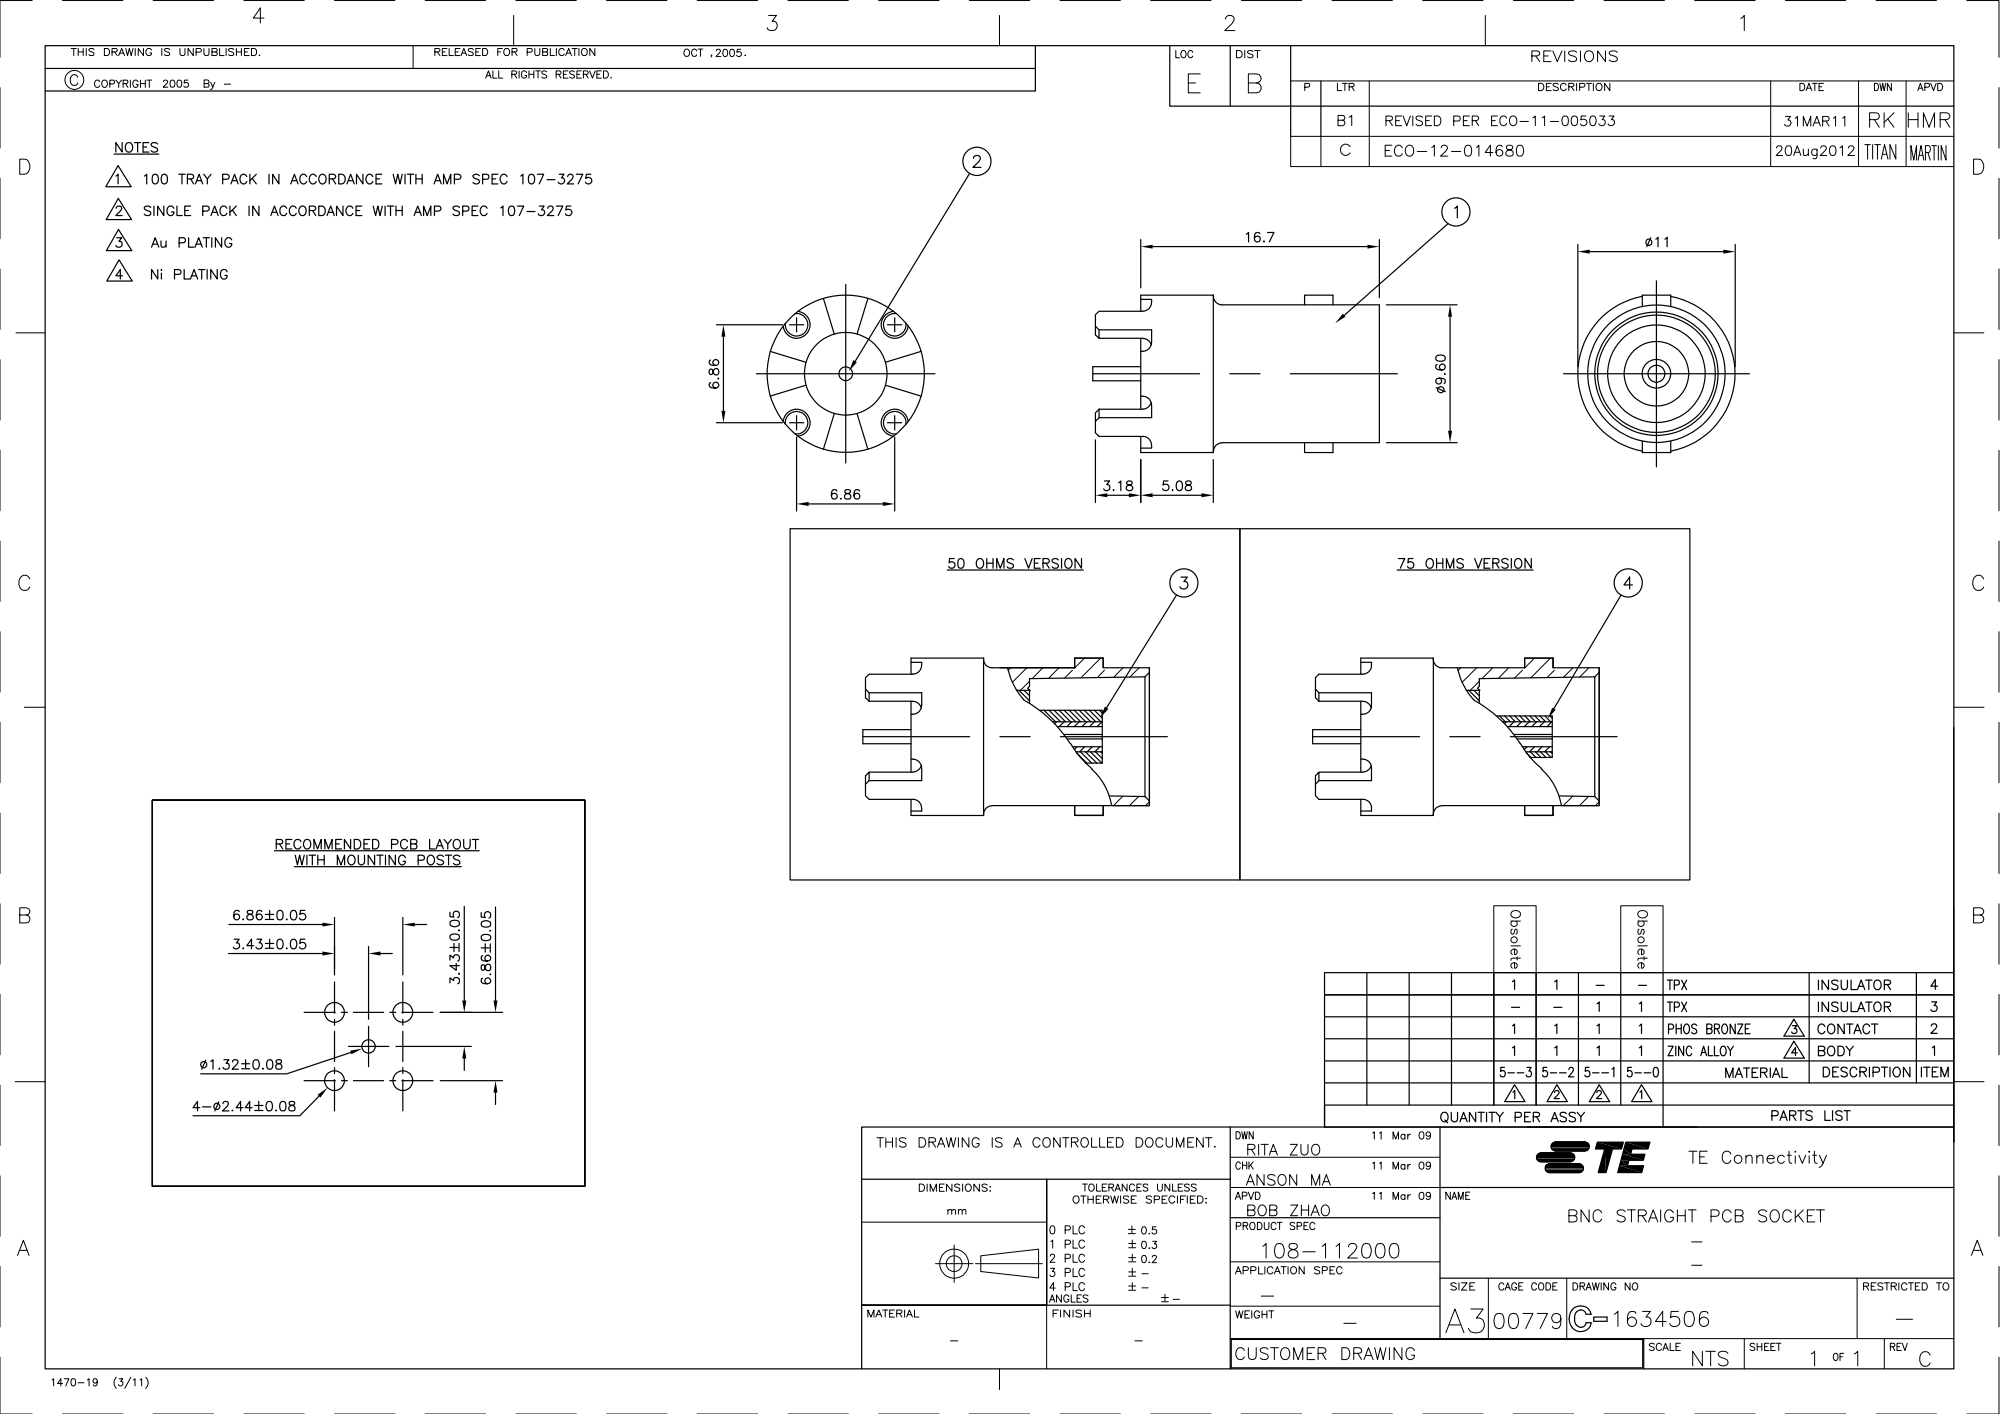
[picture p14: page 1]
