floronics/ProBoter/hardware/signal-multiplexer/hardware/schaltplan/mux.pdf

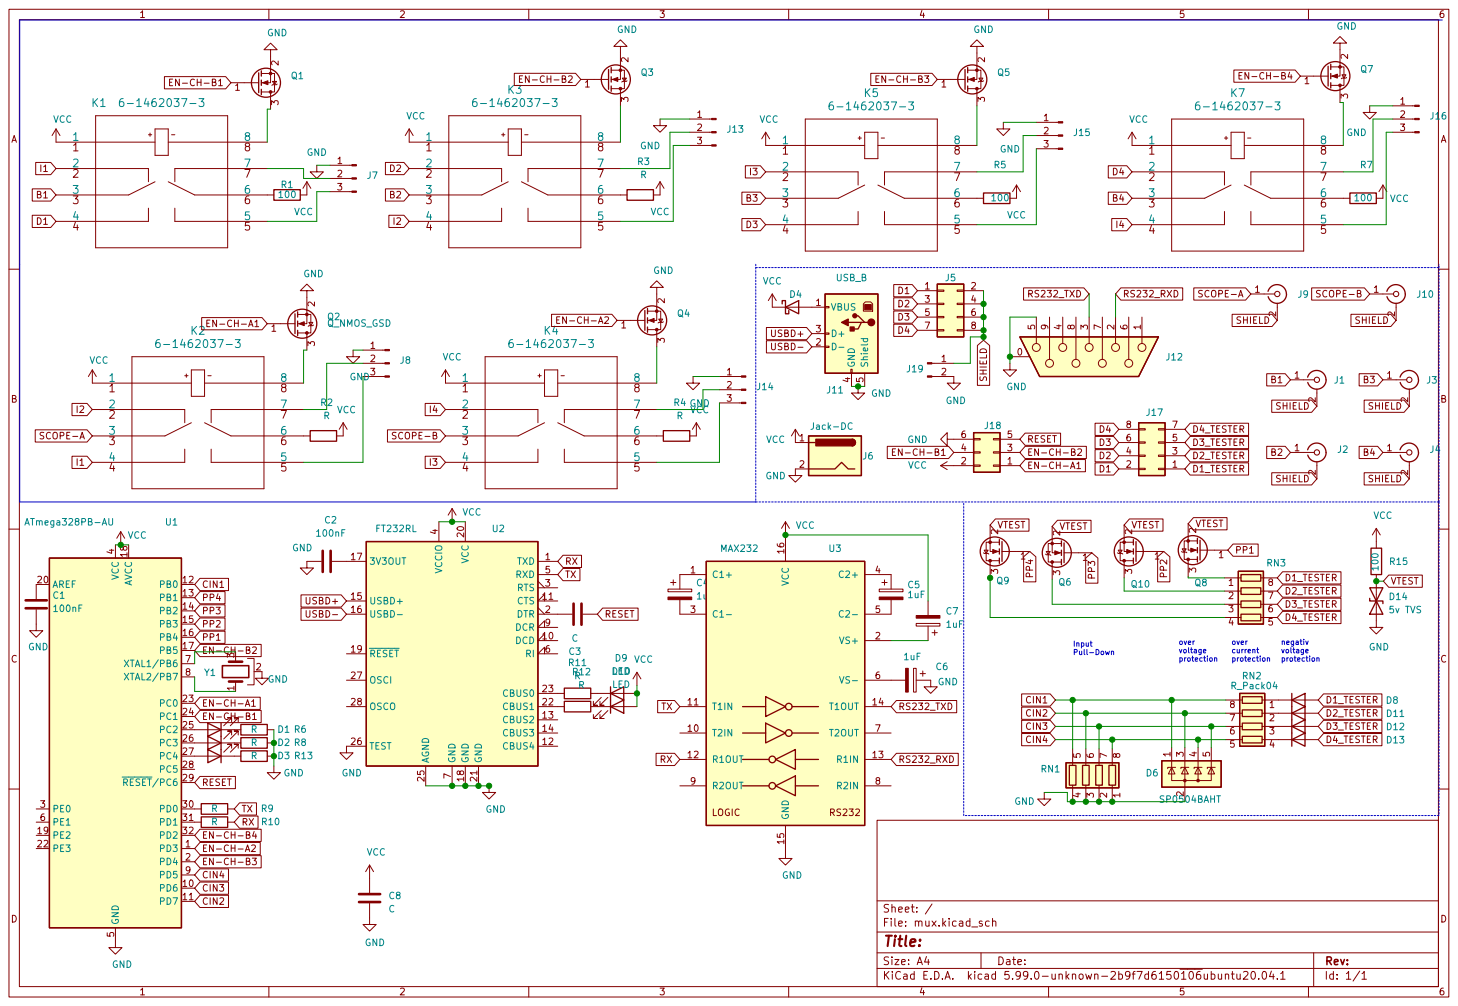
[picture p15: page 1]
