floronics/ProBoter/hardware/signal-multiplexer/hardware/mux.kicad_pcb

## KiCad design hardware/signal-multiplexer/hardware/mux.kicad_pcb (2026-10-26)

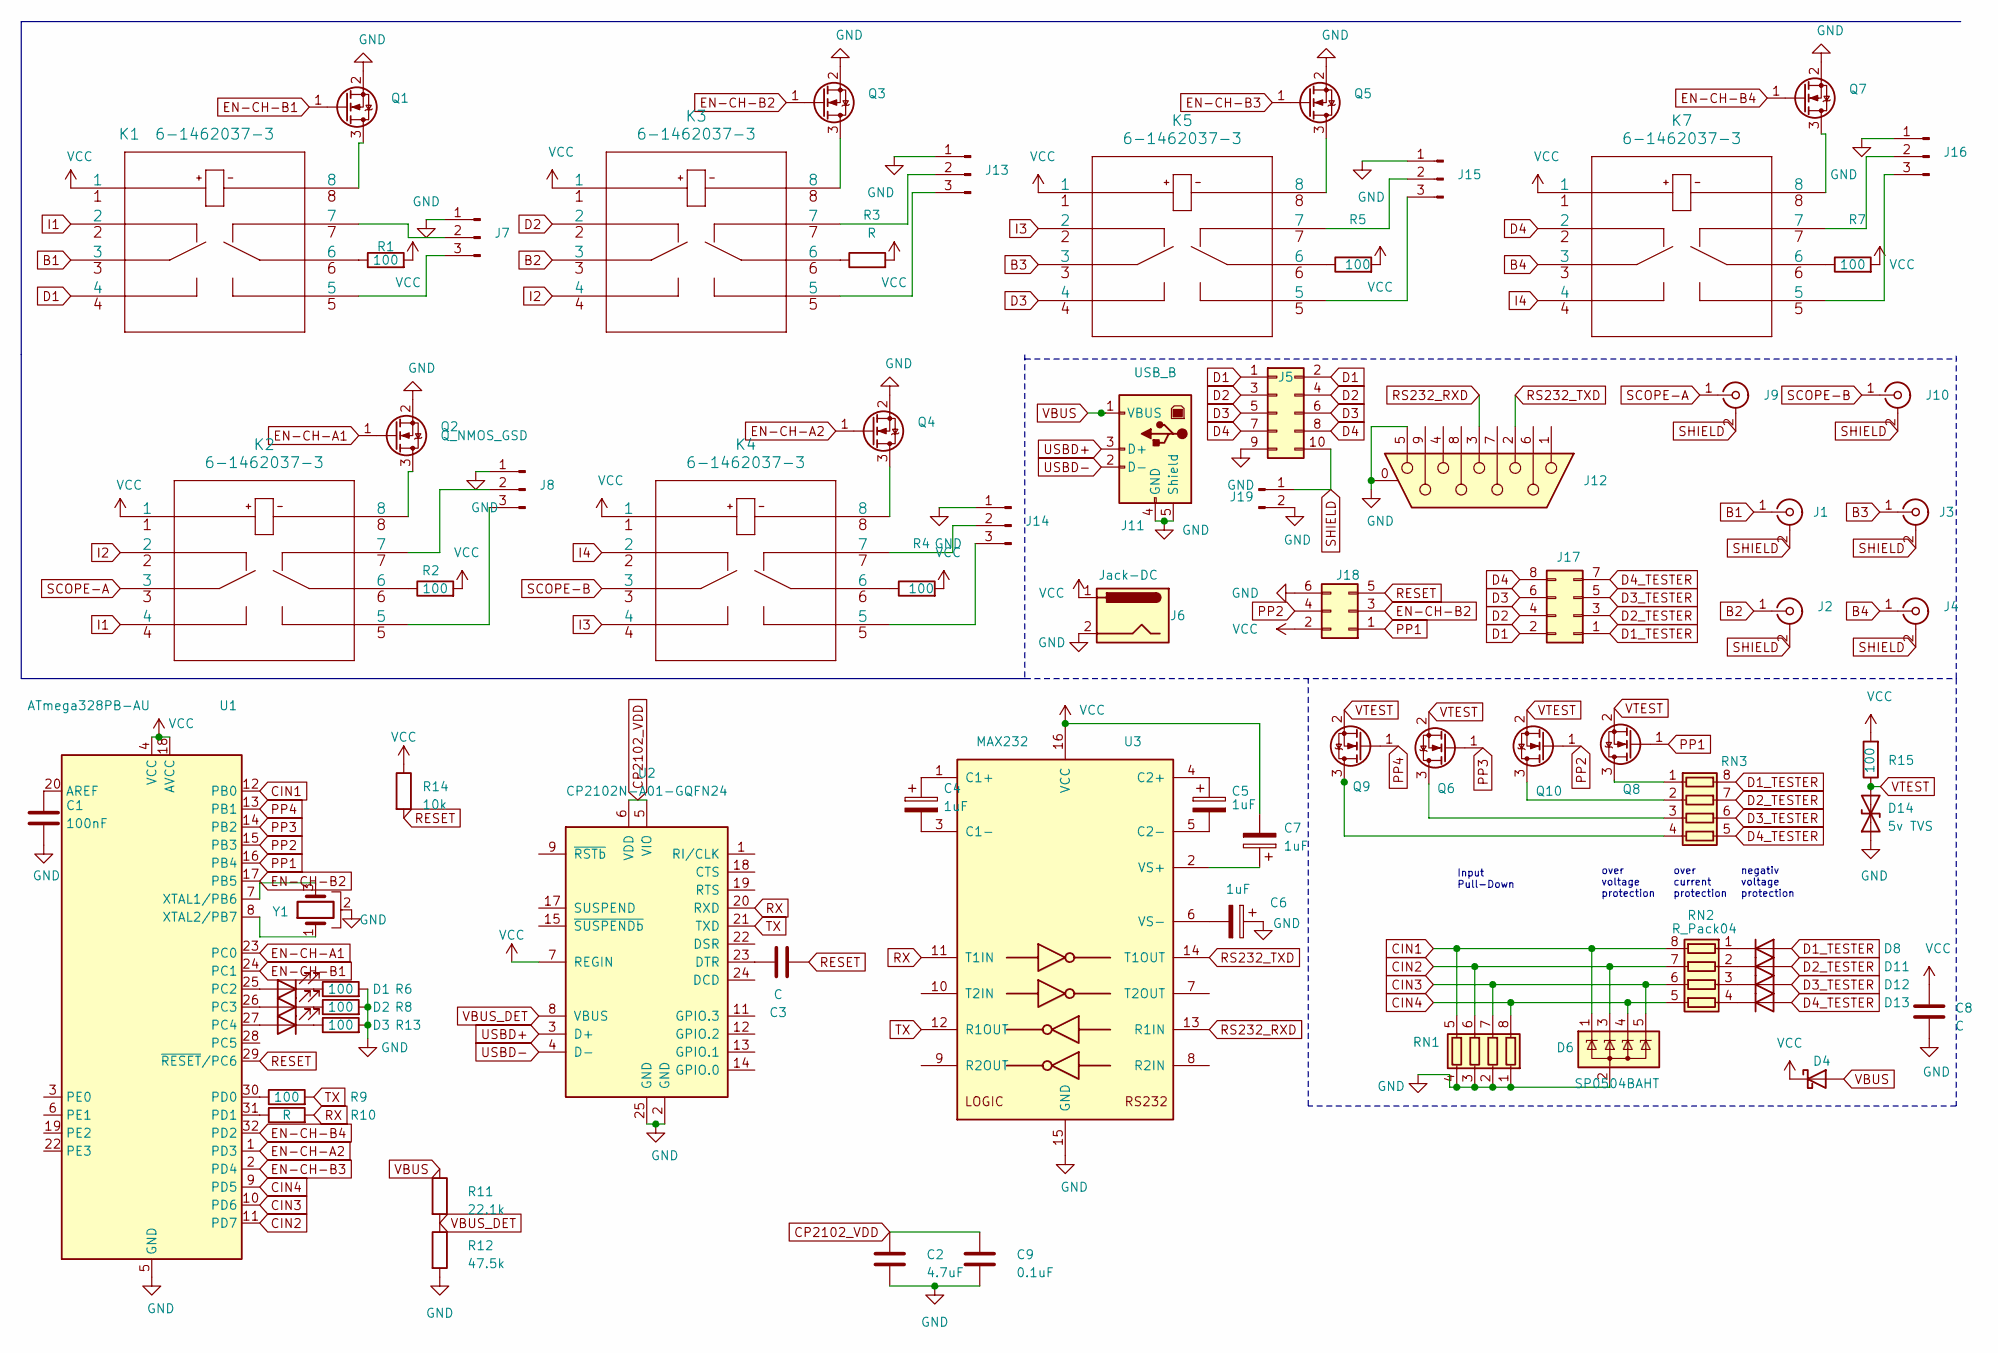
[picture p16: schematic mux.kicad_sch]

Parts:
C1: 100nF; CP_EIA-1608-08_AVX-J_Pad1.25x1.05mm_HandSolder
C2: 4.7uF; C_0805_2012Metric
C3: C; CP_EIA-1608-08_AVX-J_Pad1.25x1.05mm_HandSolder
C4, C5, C6, C7: 1uF; CP_EIA-1608-08_AVX-J_Pad1.25x1.05mm_HandSolder
C8: C; C_0805_2012Metric
C9: 0.1uF; C_0805_2012Metric
D1, D2, D3: LED; LED_D3.0mm_Horizontal_O3.81mm_Z6.0mm
D4: D_Schottky; D_SOD-123
D6: SP0504BAHT; SOT-23-5
D8, D11, D12, D13: D; D_0805_2012Metric
D14: 5v TVS; D_0805_2012Metric
J1, J2, J3, J4, J9, J10: Conn_Coaxial; SMA_Molex_73251-2200_Horizontal
J5: Conn_02x04_Odd_Even; PinHeader_2x05_P2.54mm_Horizontal
J6: Jack-DC; BarrelJack_Wuerth_6941xx301002
J7, J8, J13, J14, J15, J16: Conn_01x03_Male; JST_PH_B3B-PH-K_1x03_P2.00mm_Vertical
J11: USB_B; USB_B_Lumberg_2411_02_Horizontal
J12: DB9_Female_MountingHoles; DSUB-9_Female_Horizontal_P2.77x2.84mm_EdgePinOffset7.70mm_H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
J17: Conn_02x04_Odd_Even; PinHeader_2x04_P2.54mm_Vertical
J18: Conn_02x03_Odd_Even; PinHeader_2x03_P2.54mm_Vertical
J19: Conn_01x02_Male; PinHeader_1x02_P2.54mm_Vertical
K1, K2, K3, K4, K5, K7: 6-1462037-3
Q1, Q2, Q3, Q4, Q5, Q6, Q7, Q8, Q9, Q10: Q_NMOS_GSD; SOT-23
R1, R2, R4, R5, R6, R7, R8, R9, R13, R15: 100; R_0805_2012Metric
R3, R10: R; R_0805_2012Metric
R11: 22.1k; R_0805_2012Metric
R12: 47.5k; R_0805_2012Metric
R14: 10k; R_0805_2012Metric
RN1, RN2, RN3: R_Pack04; R_Array_Convex_4x0603
U1: ATmega328PB-AU; TQFP-32_7x7mm_P0.8mm
U2: CP2102N-A01-GQFN24; QFN-24-1EP_4x4mm_P0.5mm_EP2.6x2.6mm
U3: MAX232; SOIC-16_3.9x9.9mm_P1.27mm
Y1: Crystal_GND2; Resonator_SMD_Murata_CSTxExxV-3Pin_3.0x1.1mm_HandSoldering

Connections:
B1: J1.1 (In), K1.3
B2: J2.1 (In), K3.3
B3: J3.1 (In), K5.3
B4: J4.1 (In), K7.3
CIN1: D6.1 (K), RN1.5 (R4.2), RN2.8 (R1.2), U1.12 (PB0)
CIN2: D6.3 (K), RN1.6 (R3.2), RN2.7 (R2.2), U1.11 (PD7)
CIN3: D6.5 (K), RN1.7 (R2.2), RN2.6 (R3.2), U1.10 (PD6)
CIN4: D6.4 (K), RN1.8 (R1.2), RN2.5 (R4.2), U1.9 (PD5)
CP2102_VDD: C2.1, C9.1, U2.5 (VIO), U2.6 (VDD)
D1: J5.1, J5.2, J17.2, K1.4
D1_TESTER: D8.2 (A), J17.1, RN3.8 (R1.2)
D2: J5.3, J5.4, J17.4, K3.2
D2_TESTER: D11.2 (A), J17.3, RN3.7 (R2.2)
D3: J5.5, J5.6, J17.6, K5.4
D3_TESTER: D12.2 (A), J17.5, RN3.6 (R3.2)
D4: J5.7, J5.8, J17.8, K7.2
D4_TESTER: D13.2 (A), J17.7, RN3.5 (R4.2)
EN-CH-A1: Q2.1 (G), U1.23 (PC0)
EN-CH-A2: Q4.1 (G), U1.1 (PD3)
EN-CH-B1: Q1.1 (G), U1.24 (PC1)
EN-CH-B2: J18.3, Q3.1 (G), U1.17 (PB5)
EN-CH-B3: Q5.1 (G), U1.2 (PD4)
EN-CH-B4: Q7.1 (G), U1.32 (PD2)
GND: C1.2, C2.2, C6.1, C8.2, C9.2, D6.2 (A), D14.1 (A1), J5.9, J6.2, J7.1, J8.1, J11.4 (GND), J11.5 (Shield), J12.0 (PAD), J12.5, J13.1, J14.1, J15.1, J16.1, J18.6, J19.2, Q1.2 (S), Q2.2 (S), Q3.2 (S), Q4.2 (S), Q5.2 (S), Q7.2 (S), R6.2, R8.2, R12.2, R13.2, RN1.1 (R1.1), RN1.2 (R2.1), RN1.3 (R3.1), RN1.4 (R4.1), U1.5 (GND), U1.21 (GND), U2.2 (GND), U2.25 (GND), U3.15 (GND), Y1.2
I1: K1.2, K2.4
I2: K2.2, K3.4
I3: K4.4, K5.2
I4: K4.2, K7.4
unnamed: C1.1, U1.20 (AREF)
unnamed: C3.2, U2.23 (DTR)
unnamed: C4.1, U3.1 (C1+)
unnamed: C4.2, U3.3 (C1-)
unnamed: C5.1, U3.4 (C2+)
unnamed: C5.2, U3.5 (C2-)
unnamed: C6.2, U3.6 (VS-)
unnamed: C7.1, U3.2 (VS+)
unnamed: D1.1 (K), R6.1
unnamed: D1.2 (A), U1.25 (PC2)
unnamed: D2.1 (K), R8.1
unnamed: D2.2 (A), U1.26 (PC3)
unnamed: D3.1 (K), R13.1
unnamed: D3.2 (A), U1.27 (PC4)
unnamed: D8.1 (K), RN2.1 (R1.1)
unnamed: D11.1 (K), RN2.2 (R2.1)
unnamed: D12.1 (K), RN2.3 (R3.1)
unnamed: D13.1 (K), RN2.4 (R4.1)
unnamed: J7.2, K1.7
unnamed: J7.3, K1.5
unnamed: J8.2, K2.7
unnamed: J8.3, K2.5
unnamed: J13.2, K3.7
unnamed: J13.3, K3.5
unnamed: J14.2, K4.7
unnamed: J14.3, K4.5
unnamed: J15.2, K5.7
unnamed: J15.3, K5.5
unnamed: J16.2, K7.7
unnamed: J16.3, K7.5
unnamed: K1.6, R1.1
unnamed: K1.8, Q1.3 (D)
unnamed: K2.6, R2.1
unnamed: K2.8, Q2.3 (D)
unnamed: K3.6, R3.1
unnamed: K3.8, Q3.3 (D)
unnamed: K4.6, R4.1
unnamed: K4.8, Q4.3 (D)
unnamed: K5.6, R5.1
unnamed: K5.8, Q5.3 (D)
unnamed: K7.6, R7.1
unnamed: K7.8, Q7.3 (D)
unnamed: Q6.3 (D), RN3.3 (R3.1)
unnamed: Q8.3 (D), RN3.1 (R1.1)
unnamed: Q9.3 (D), RN3.4 (R4.1)
unnamed: Q10.3 (D), RN3.2 (R2.1)
unnamed: R9.1, U1.30 (PD0)
unnamed: R10.1, U1.31 (PD1)
unnamed: U1.7 (XTAL1/PB6), Y1.3
unnamed: U1.8 (XTAL2/PB7), Y1.1
PP1: J18.1, Q8.1 (G), U1.16 (PB4)
PP2: J18.4, Q10.1 (G), U1.15 (PB3)
PP3: Q6.1 (G), U1.14 (PB2)
PP4: Q9.1 (G), U1.13 (PB1)
RESET: C3.1, J18.5, R14.2, U1.29 (~RESET~/PC6)
RS232_RXD: J12.3, U3.13 (R1IN)
RS232_TXD: J12.2, U3.14 (T1OUT)
RX: R10.2, U2.20 (RXD), U3.11 (T1IN)
SCOPE-A: J9.1 (In), K2.3
SCOPE-B: J10.1 (In), K4.3
SHIELD: J1.2 (Ext), J2.2 (Ext), J3.2 (Ext), J4.2 (Ext), J5.10, J9.2 (Ext), J10.2 (Ext), J19.1
TX: R9.2, U2.21 (TXD), U3.12 (R1OUT)
USBD+: J11.3 (D+), U2.3 (D+)
USBD-: J11.2 (D-), U2.4 (D-)
VBUS: D4.2 (A), J11.1 (VBUS), R11.1
VBUS_DET: R11.2, R12.1, U2.8 (VBUS)
VCC: C7.2, C8.1, D4.1 (K), J6.1, J18.2, K1.1, K2.1, K3.1, K4.1, K5.1, K7.1, R1.2, R2.2, R3.2, R4.2, R5.2, R7.2, R14.1, R15.2, U1.4 (VCC), U1.18 (AVCC), U2.7 (REGIN), U3.16 (VCC)
VTEST: D14.2 (A2), Q6.2 (S), Q8.2 (S), Q9.2 (S), Q10.2 (S), R15.1

Notes on the sheet:
Input Pull-Down
over voltage protection
over current protection
negativ voltage protection

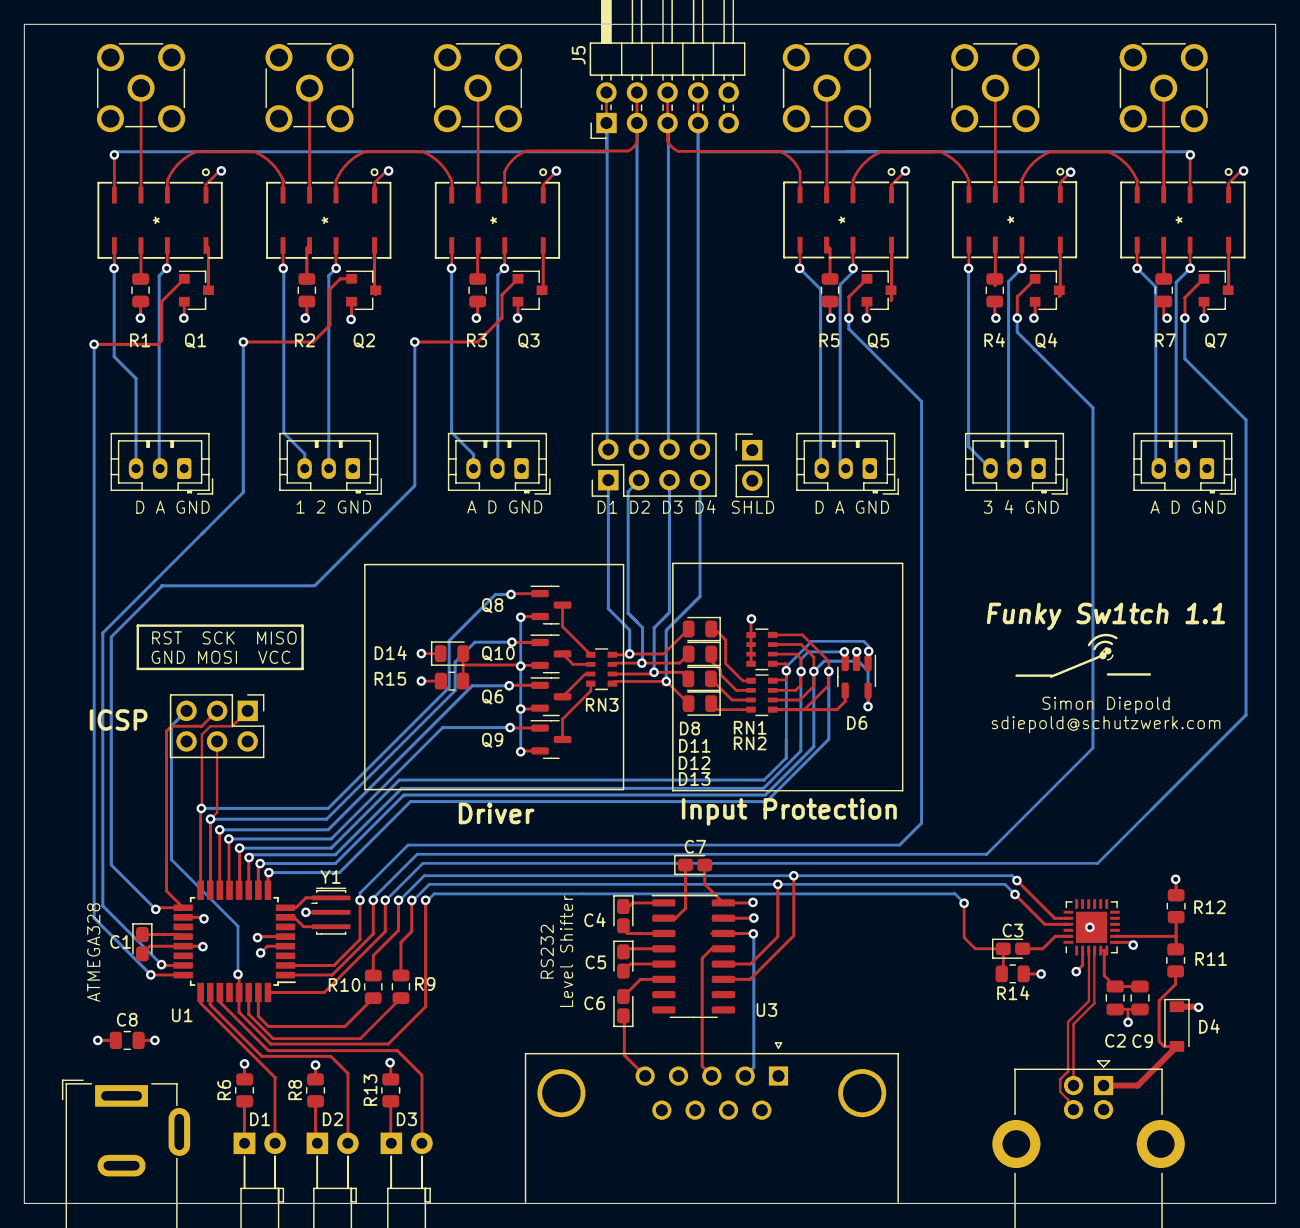
[picture p17: board mux.kicad_pcb from above]

Board: 4 copper layers, 104.0 x 98.0 mm, 76 parts (0 on the bottom side), 96 nets.
