floronics/ProBoter/(commit log)

2026-10-16 Add Floronics build research and CAD-derived parts list
2026-10-16 Count reused STEP assemblies recursively and correct BOM quantities
2026-10-16 Add four-probe procurement BOM, fabrication groups and auditable cost model
2026-10-17 Group parts list by the 13 top-level Fusion components
    Teileliste.md now opens with one section per top-level CAD component
    (K01 base, K02-K05 x_slide, K06-K09 y_slide, K10-K13 z_slide) plus K14
    for parts without a CAD body. Subassembly parts stay with their
    component and are labelled with their direct subassembly.
    extract_step_bom.py gains --components to export per-placement counts
    from STEP, so the 12 NEMA17 motors missing from the Fusion import are
    still placed correctly. The generator maps STEP placements to Fusion
    paths and validates that every CAD part is placed exactly once.
2026-10-17 Clarify fasteners and Fusion-measured drive parts
    - 23 standard parts (A2, +10 % / min. +2 reserve) now orderable with
    verified Schrauben.Expert / Eisenwaren2000 articles and tier prices;
    M8x1 nuts stay open (left-hand thread note, sensors ship nuts).
    - New tools/fusion_measurements.py + evidence JSON: belt pitch lengths,
    NEMA14 duplicate placements (4 motors confirmed), Z pulley on motor
    shaft (SYS-035 dropped), hole patterns of guides, handle, foot.
    - Belt cut lengths and chain end brackets documented from geometry.
2026-10-17 Clarify drive, electronics and mechanics parts from datasheets
    - Verified articles with matching CAD dimensions: NEMA17 original,
    optical endstops, X/Y/Z belts, CPC MR12 guides, HIWIN MGN12 guides,
    igus E2i chains (per link) and end brackets, RJ4JP bushings,
    telescopic slides, profile brackets, MHS012 brackets.
    - Candidates only (not released): SKR 1.4 Turbo, NEMA14 successor
    SC3518M1204-A, 9 mm Z pulley RBS12867, handle A-75903, foot.
    - Corrected wrong DOLD 64396 (smooth wheel, not GT2).
    - 40 positions now orderable; web-priced share 2,346 EUR net.
2026-10-17 Flag unclear manufacturing method of base adapter plates
2026-10-17 Add assembly modules, starting with M01 base frame
    bom/montage/module.json defines build modules by Fusion scope and CAD
    name; the generator writes Montage.md and montage.csv with status
    counts per module. tools/fusion_show_module.py shows one module in
    Fusion (visibility only).
2026-10-17 Check M01 base frame for completeness via Fusion contact analysis
    - Brackets: 18 of 26 join frame profiles (8 belong to the drawer).
    - M6x20 countersunk: 8 of 22 join motor plates to 60x30 profiles.
    - Removed M6x14 (drawer), adapter plates (carry X belt drives) and
    M8x1 nuts (sensors) from M01.
    - Added parts missing in CAD: 8 slot nuts M6, 6 M4 screws + slot nuts
    for the back plate, M6 tapping of 4 vertical profile ends.
    - Module rendering supports partial quantities, additions, removals.
2026-10-17 Add M02 X axis module with Fusion contact check
2026-10-17 Add M03 Y axis module; identify CAD-001/002 as Y belt clamp
2026-10-17 Add M04 Z axis module with Fusion contact check
2026-10-17 Add M05 drawer and PCB holder module
2026-10-17 Add M06 cable routing module
2026-10-17 Add M07 electrics and sensors module
2026-10-17 Add M08 optics, M09 probe tips, M10 covers; check module coverage
2026-10-17 M01: foot M6x20 measured, back plate aluminium, motor plates in-house
2026-10-17 M01: frame profiles DOLD 30x30L and 30x60S as cut-to-length lots
2026-10-17 Revert "M01: frame profiles DOLD 30x30L and 30x60S as cut-to-length lots"
    This reverts commit d34fa1af39bf01fcd50f0b5ecc6d8952041c0821.
2026-10-17 Reapply DOLD cut-to-length frame profiles (confirmed by Luis)
    Cut lengths are taken unchanged from CAD.
2026-10-17 M01: add slot nuts and back-plate screws, mark plates as workshop parts
2026-10-17 Add workshop drawings for M01 plates (PDF, DXF, hole tables)
    Geometry read from Fusion via tools/fusion_plate_geometry.py, rendered by
    tools/render_plate_drawings.py. Unchecked draft derived from CAD.
2026-10-17 Remove generated M01 plate drawings (partly wrong)
2026-10-17 Remove plate drawing scripts
2026-10-17 M02: workshop plates, PETG prints specified, exact 8.5 mm idlers, cut shafts
2026-10-17 M02: threads in workshop plates for M3x18 and M5 screws
2026-10-17 M03: bushing retention confirmed by clamping; Ø4x70 rods open
2026-10-17 M04: NEMA14 replaced by STEPPERONLINE 14HS13 (flagged), EU pulley with holder adaptation, printed end stop triggers
2026-10-17 M04: spacer sleeve search result recorded
2026-10-17 M04: spacer sleeves as PETG print
2026-10-17 M05: handle A-75873, fasteners for handle, shaft holders and telescopic slides
2026-10-17 M05: verified screw articles for handle and telescopic slides
2026-10-17 M05: square tube changed to 12x12 (flagged deviation)
2026-10-17 M05: square tube 12x12x1 confirmed
2026-10-17 M06: cable cover printed, fasteners for holders and igus brackets derived from geometry, chain holder profile flagged
2026-10-17 Identify 16-series flat profiles: 40x16S (stiffener) orderable, 80x16S candidate for chain holder
2026-10-17 M07: sensor spec derived from CAD+firmware, power switch function, steel trigger rods
2026-10-17 M07: SICK NPN sensors with ifm cables, Cf53 trigger rods, ONPOW latching switch; M8 nuts included with sensors
2026-10-17 M07: switch sensors to ELCO NI4-M08-ON6L-Q8 (cheaper, exact length); M8 nuts back to open
2026-10-17 M08: overview camera is a 32x32 board camera (28 mm M2 pattern), holder plate workshop
2026-10-17 M08: Toolcraft microscope (holder adaptation, UVC test) and ELP-USBFHD01M-H100 overview camera
2026-10-17 M09: P75-B1 probes plus cone/flat tip selection, R75 receptacle and MMCX RG316 identified, PCB via SCHUTZWERK request
2026-10-18 Mark igus end bracket sets SYS-027/028 as orderable
2026-10-18 M10: acrylic covers cut to size (plattenzuschnitt24) with M5 screws and slot nuts
2026-10-18 M12 lighting: LED strip around top frame, BARdolino profiles with diffuser
2026-10-18 M13 calibration: reference plate dimensions from software, workshop parts, engraved markers
2026-10-18 Save Fusion view onlyPassiveParts and split it into ordered vs self-made parts
    tools/fusion_views.py saves/applies named visibility views; tools/classify_view.py
    groups the view by procurement and manufacturing technique (bom/views/).
2026-10-18 Add combined order list of all 132 positions sorted by module
    tools/build_order_overview.py joins bom/bestellliste.csv with the module
    assignment from bom/montage/ and writes bom/Gesamtbestellliste.md/.csv.
    System parts without CAD are assigned via the "zusatz" entries of module.json.
2026-10-18 M01 review: drop slot nuts SYS-041, add review status file
    Fusion measurement shows the 8 countersunk M6x20 of the motor plates sit in
    the end faces of the 60x30 profiles on the core bores, not in the slot. The
    M6 nuts SYS-041 are dropped; CAD-014 now notes 2x M6 per end, tapped in-house.
    bom/data/pruefung.csv holds the per-position review status (M01 checked
    against the shops on 18.10.2026); build_order_overview.py shows it as a column.
2026-10-18 M01: use DOLD tier price 2.24 EUR for 26 brackets 62385-BS
    Keep the zinc-plated DIN 7380 M6x12 screws of the bracket set.
2026-10-22 Add original SCHUTZWERK BOM and reconciled BOM against our research
    bom/BOM.ods is the original SCHUTZWERK BOM (V1.0 plus Probe Upgrade sheet).
    tools/build_schutzwerk_bom.py generates bom/BOM-SCHUTZWERK-Abgleich.csv:
    all SCHUTZWERK rows (they take precedence), our order list positions they
    replace are dropped, remaining positions from our research are appended.
    Source column marks origin; SCHUTZWERK links checked for availability on
    2026-10-22, unavailable parts marked with x.
2026-10-26 Add SCHUTZWERK Solid Edge CAD, signal multiplexer board and BOM.xlsx
    Original files from SCHUTZWERK: hardware/cad (Solid Edge parts and
    assemblies), hardware/signal-multiplexer (KiCad project, Gerbers,
    firmware; KiCad backups and fp-info-cache left out) and the SCHUTZWERK
    part list with links as bom/source/schutzwerk-bom.xlsx.
2026-10-26 Measure SCHUTZWERK Solid Edge parts in Fusion
    99 printed, mechanical and PCB part files uploaded to the Fusion folder
    SolidEdge-Original and measured (bounding box, volume, material, bodies).
2026-10-26 Route printed_parts as prints, mill motor/side plates, multiplexer at JLCPCB
    - Adapter plates CAD-016..019 and camera_holder_top CAD-026 are in
    SCHUTZWERK's printed_parts folder: now 3D-Druck intern (PETG 4 -> 5 kg).
    - Motor plates CAD-096/097 and side plates CAD-099/100 are milled in house.
    - Multiplexer PCB SYS-003 and assembly SYS-023 now point to the SCHUTZWERK
    KiCad project (gerber1.1 matches mux.kicad_pcb) and JLCPCB.
2026-10-26 Add Solid Edge part list checked against the BOM
    bom/SolidEdge-Teileliste.md/.csv lists every SCHUTZWERK Solid Edge file
    with folder-based process, Fusion geometry, STEP count and our BOM group.
    READMEs for hardware/cad and the multiplexer board (order gerber1.1).
2026-10-26 Decide the 36 Solid-Edge-only parts
    - Printed calibration plate v4, marker inserts and pins (SYS-061..063)
    replace the aluminium plate, engraving and POM references (SYS-004/006/037).
    - Drawer cable chain: two printed holders, power socket holder and
    2x igus E2C.10 0.5 m with brackets (SYS-064..066, SYS-073/074).
    - Printed housings for target power switch, small PSU, Raspberry Pi
    holder and height leveling tool (SYS-067..072).
    - Old variants, duplicates and pogo pin holders not needed; raw plates via MAT-006.
    - PETG now 6 rolls.
2026-10-26 Group all CAD parts by procurement in a Fusion copy
    tools/fusion_groups.py sorts the 119 part types (1054 occurrences) into
    3D-Druck, Fertigung (incl. PCBs), DOLD offer AN2026-104489, remaining
    SCHUTZWERK BOM parts and unassigned. tools/fusion_build_groups.py builds
    the flat Fusion copy "proboter Gruppen" from that mapping.
2026-10-26 Add Bestellliste.xlsx: SCHUTZWERK BOM with DOLD offer column
    Copy of bom/source/schutzwerk-bom.xlsx with a column after "Teil" that
    marks whether each line is in DOLD offer AN2026-104489 (ja with position,
    nein, or same article but BOM_2 quantity not offered).
2026-10-26 Replace Nanotec ST3518 with closed-loop 14HS11-1004-ME1K + CL42T-V41
    X, Y and Z drives now use the StepperOnline 14HS11-1004-ME1K (NEMA 14,
    1000 PPR encoder, 34.5 mm incl. encoder, fits the existing CAD) with a
    CL42T-V41 closed-loop driver each. TMC2130 row flagged for review and
    StepperOnline added to the manufacturer legend.
2026-10-27 Add 2x DOLD 80x16S profile as drag chain holders
    The two upper base_drag_chain_holder parts are replaced by DOLD
    60886-Z aluminium profile 80x16S Nut 8, cut to 650 mm. The two lower
    holders stay printed parts. M3 threads on top are drilled in-house.
2026-10-27 Add igus E2i.10 drag chains to order list
    X axis: E2i.10.20.028.0, 14 links (0.28 m) with E2.100.20.34PZ.A2 brackets.
    Y axis: E2i.10.10.028.0, 12 links (0.24 m) with E2.100.10.34PZ.A2 brackets.
    Both 2 per probe. Inserted row 92; totals shifted and re-checked.
2026-10-27 Update order list: sensors, shaft holders, belts, spindle parts, slides
    - Inductive end stops: M8 LJ8A3-2-Z/BX (Amazon) instead of M12 AI905,
    3 per probe as used by the firmware
    - Add 4x DOLD SHF10 flange shaft holders per probe
    - GT2 6 mm wheels, idlers and belt sized for X, Y and Z
    (4 + 4 per probe, 5 m belt per probe)
    - Spindle drive parts set to 0 (belt drive in CAD), DOLD positions
    15, 17, 18, 24, 25 marked for removal
    - Drawer slides: DOLD HS-4613-350 instead of Teleskopschienen24
2026-10-27 Return to open-loop drives: 14HS13-0804S + BTT TMC2130 V3.0 SPI
    X, Y and Z now use the StepperOnline 14HS13-0804S (NEMA 14, 18 Ncm,
    0.8 A, 34.8 mm) in place of the Nanotec ST3518M1004-A, whose product
    page is gone. The CL42T-V41 closed-loop drivers are removed again and
    the TMC2130 V2.0 set is replaced by 4x BTT TMC2130 V3.0 SPI per probe
    from Tinytronics, added to the supplier legend.
2026-10-27 Order SKR V1.4 Turbo and TMC2130 drivers from Roboter-Bausatz
    The "Smoothieboard ohne Stepper Treiber" row linked to a PoPprint SKR V1.3,
    which is no longer available; it is replaced by the BTT SKR V1.4 Turbo.
    Board and BTT TMC2130 V3.0 SPI drivers now come from Roboter-Bausatz.de
    to bundle the order; Roboter-Bausatz replaces Tinytronics in the legend.
2026-10-27 Add central Mean Well PSU and USB microscope to order list
    One Mean Well SDR-240-24 DIN-rail supply from DOLD now powers all four
    probes instead of one Kingled 200 W supply per probe. It is counted once:
    the frame total includes it and the per-probe total excludes it.
    Also adds a Toolcraft USB microscope per probe (Voelkner) with its
    supplier in the legend.
2026-10-27 Merge order list into one sheet with fastener category
    - BOM and BOM_2 merged into a single sheet "Bestellliste"; duplicates
    from BOM_2 removed, only USB hub and spare foot plate kept
    - Obsolete SCHUTZWERK rows removed (spindle parts with quantity 0,
    old screw rows, manufacturer colour legend)
    - New category "Schrauben, Muttern & Kleinteile" with the CAD
    quantities plus reserve (DOLD, A2 or galvanised)
    - DOLD offer column replaced by a "Shop" column; all colours removed,
    missing quantities and links highlighted in orange
    - Totals now computed from the "je Probe" flag
2026-10-27 Add DOLD order list, status column and per-shop sheet
    - New bom/Dold Bestellung.xlsx: all DOLD items with full-build
    quantity (4 probes) and link, without prices
    - Bestellliste: notes column removed, offer highlighting removed,
    new status column (identifiziert, bestellt, geliefert, verbaut)
    - New sheet "nach Hersteller" grouping all parts by shop, linked
    to the main sheet
2026-10-27 Ask DOLD for igus drag chains and MR12 carriages
    Dold Bestellung.xlsx gets a separate section with the parts so far
    planned at igus and Motedis (8 + 8 drag chains, 12 MR12 carriages),
    so DOLD can check whether they can supply them.
2026-10-27 Split order list into all parts, to order and to manufacture
    - "Alle Bauteile": adds JLCPCB multiplexer and probing boards
    (quantity only), all 3D-printed parts by mounting position, the
    back plate and a new "Hilfsmittel" section
    - "zu bestellen": purchased parts grouped by shop with status dropdown
    - "zu fertigen": 3D prints (PETG), workshop parts and PCBs with
    quantity for the full build, material and status dropdown
    - Print quantities counted from hardware/3d_models/proboter.stp,
    doubled X belt tensioners removed
2026-10-27 Update DOLD order list, rename Bestellliste to Bauteilliste, add tooled parts STEP
    - Move MR12 600 mm rails and carriages to DOLD; drop M8 nuts (included with sensors)
    - Set screw/nut quantities from CAD count plus reserve; small quantities from Werkstatt
    - Add docs/offene-fragen.md and STEP export of all parts to be machined
2026-10-28 Answer SCHUTZWERK questions, document mux scope/multimeter switching concept
    - Move answered questions S1-S4, S6-S8 to Erledigt in offene-fragen.md
    - Document hybrid concept for the signal multiplexer board: keep GND/Power
    hardwired, make signal probes relay-switchable between scope and
    multimeter, with the bandwidth and break-before-make trade-offs to watch
2026-10-28 Add probe system, laser parts and PCB holder rods to Bauteilliste
    - Probes: RS Components pins 261-5171/-5193/-5187 and crimp receptacle
    261-5250 replace the "Probespitze" placeholder; igus chainflex CFKOAX
    and CF9.05.02 cables replace "Kabel Probe"
    - Drop the probe_tip_pcb board: no Gerber data exists and the receptacle
    press-fits into the printed holder
    - Split motor and side plates into single parts, sourced from
    laserteile4you.de; add acrylic covers (fabricator still open)
    - Add aluminium tubes for the PCB holder guides (Amazon)
    - Set materials: drawer plate 12 mm Siebdruck, back plate 5 mm MDF,
    calibration plate PLA
    - Sort new entries into their sections, add RS Components, la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
